JeremyProffittOrg/wopr/output/pdf/wopr-first-draft.pdf

DESIGN REVIEW

# W.O.P.R. / divided storage and inset base

Seven RGB panels per side. Two main-cup layouts. Recessed screw heads. Gray and flush white text.

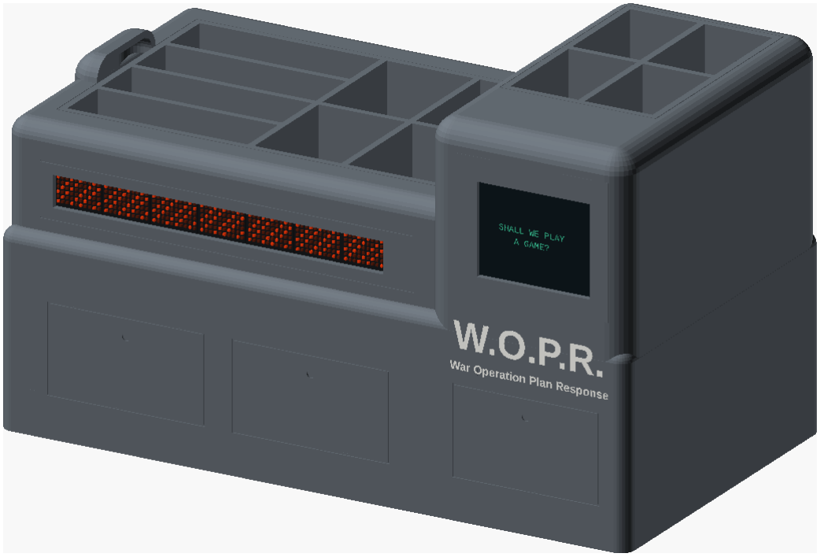
[picture p187: figure]

W.O.P.R. / DRAFT 07 / 2026-09-27 / dimensions in mm / not to print scale | 01 / 08
279.4 x 155 x 165 mm | 11.00 x 6.10 x 6.50 in | 3 mm nominal shell
OpenSCAD model render. Colored LEDs and display are hardware previews, not printed material.

MOCKUPS

# Seven-panel banks, the same case

Fourteen boards total: seven adjacent boards behind one continuous window on each side.

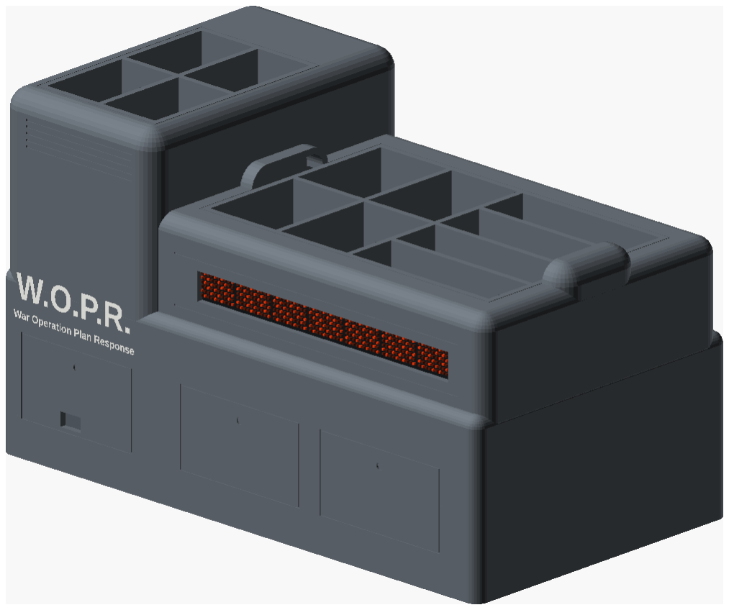
[picture p188: figure]
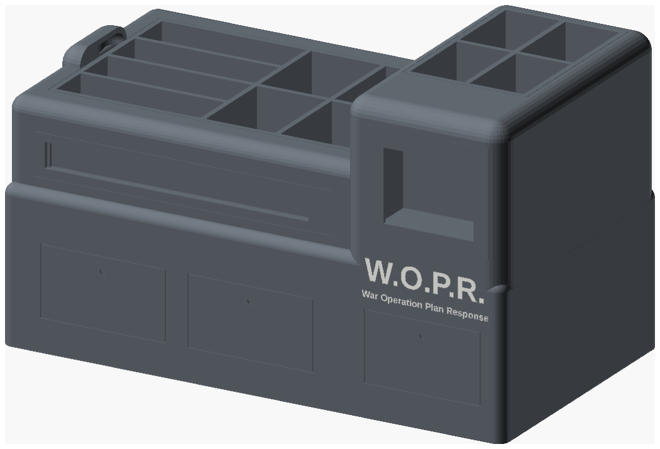
[picture p189: figure]

W.O.P.R. / DRAFT 07 / 2026-09-27 / dimensions in mm / not to print scale | 02 / 08

CASE WITHOUT ELECTRONICS

The tower cup has crossed dividers, making four deep compartments.

Both long sides carry white W.O.P.R. / War Operation Plan Response lettering.

The main touchscreen is on one side, directly above its logo.

Main cup: four shallow compartments in one half, four deep compartments in the other.

The inset base has 3 mm of screw-head space above the lower body edge.

Remove the pen cups and base for rear access. Fit the electronics first, then lower the cups into place.

# Overall envelope and panel placement

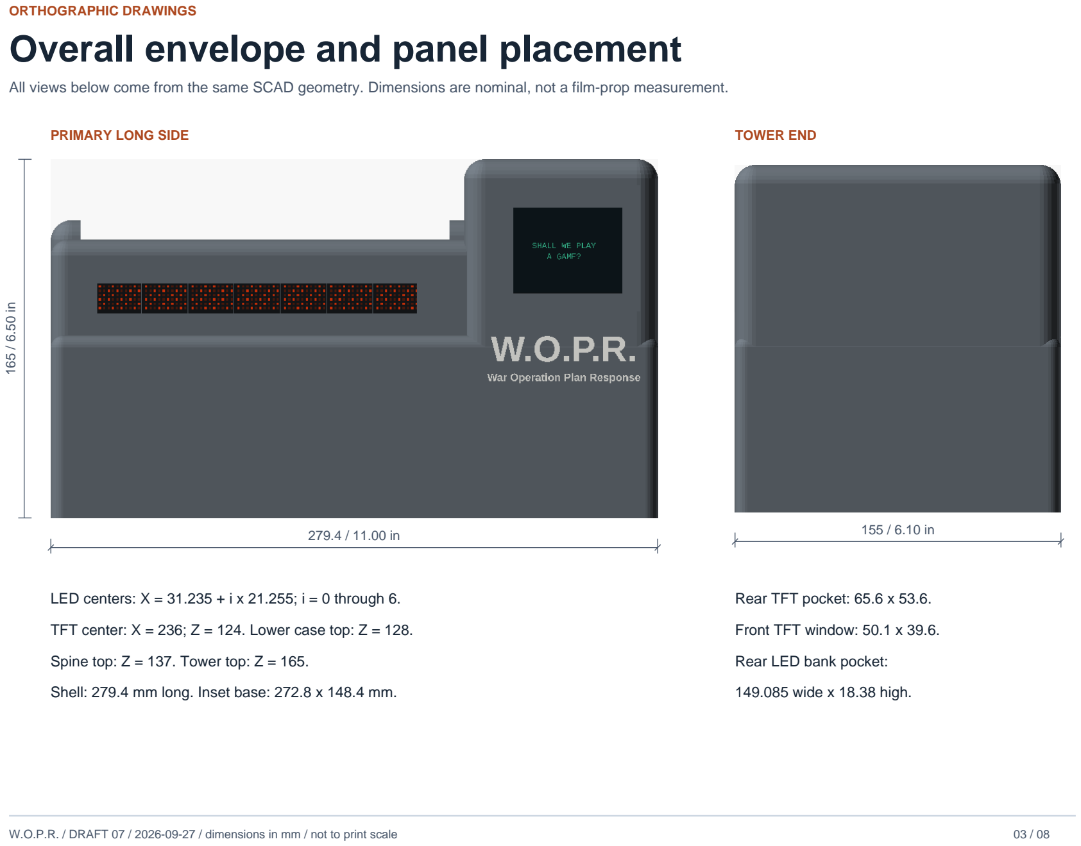
[picture p190: page 3]

ORTHOGRAPHIC DRAWINGS

All views below come from the same SCAD geometry. Dimensions are nominal, not a film-prop measurement.

W.O.P.R. / DRAFT 07 / 2026-09-27 / dimensions in mm / not to print scale | 03 / 08

PRIMARY LONG SIDE

279.4 / 11.00 in

165 / 6.50 in

TOWER END

155 / 6.10 in

LED centers: X = 31.235 + i x 21.255; i = 0 through 6.

TFT center: X = 236; Z = 124. Lower case top: Z = 128.

Spine top: Z = 137. Tower top: Z = 165.

Shell: 279.4 mm long. Inset base: 272.8 x 148.4 mm.

Rear TFT pocket: 65.6 x 53.6.

Front TFT window: 50.1 x 39.6.

Rear LED bank pocket:

149.085 wide x 18.38 high.

# Top, rear and service access

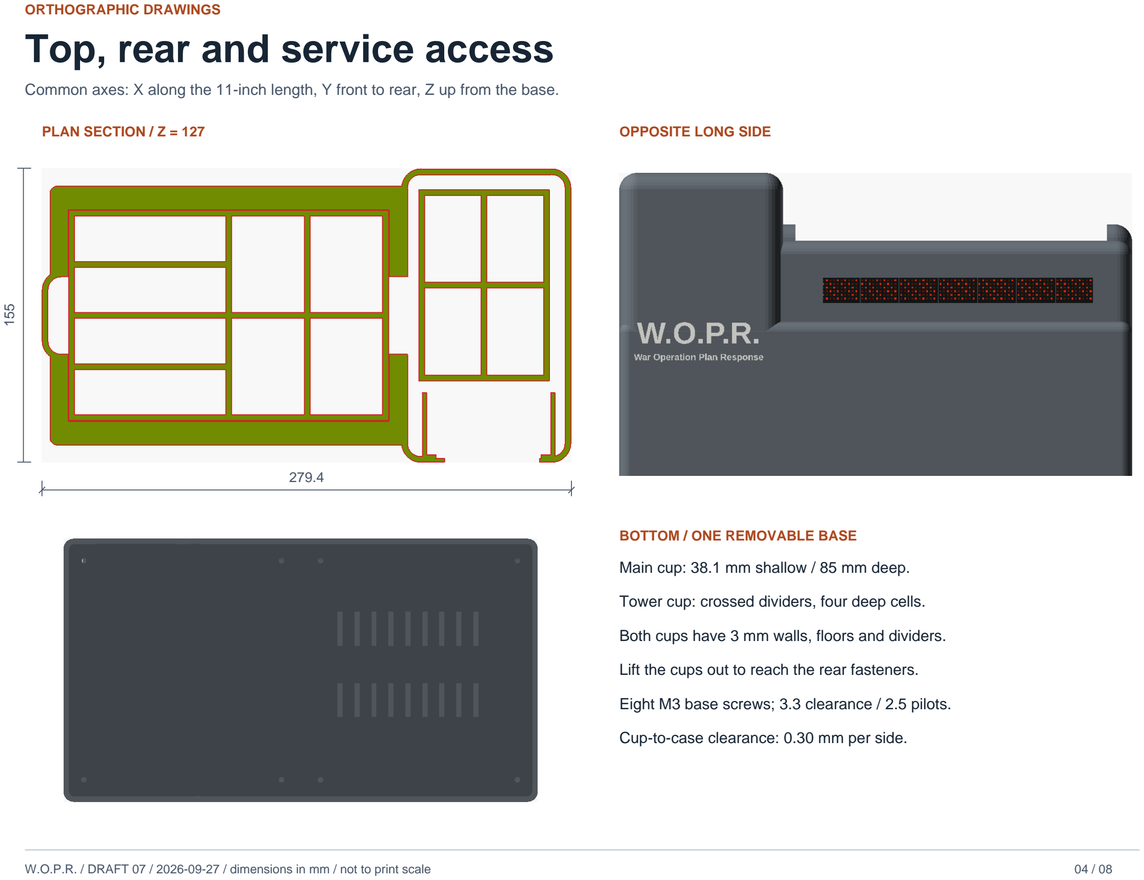
[picture p191: page 4]

ORTHOGRAPHIC DRAWINGS

Common axes: X along the 11-inch length, Y front to rear, Z up from the base.

W.O.P.R. / DRAFT 07 / 2026-09-27 / dimensions in mm / not to print scale | 04 / 08

PLAN SECTION / Z = 127

279.4

155

OPPOSITE LONG SIDE

BOTTOM / ONE REMOVABLE BASE

Main cup: 38.1 mm shallow / 85 mm deep.

Tower cup: crossed dividers, four deep cells.

Both cups have 3 mm walls, floors and dividers.

Lift the cups out to reach the rear fasteners.

Eight M3 base screws; 3.3 clearance / 2.5 pilots.

Cup-to-case clearance: 0.30 mm per side.

# Both main-cup versions are included

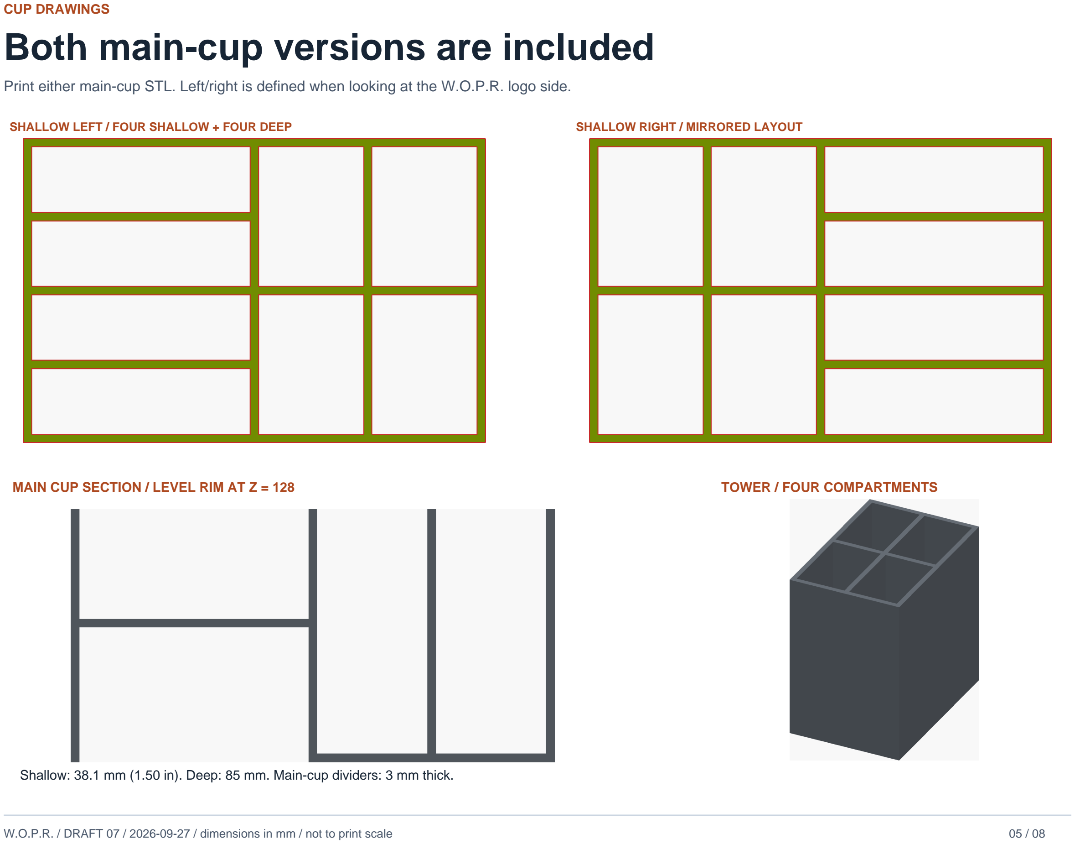
[picture p192: page 5]

CUP DRAWINGS

Print either main-cup STL. Left/right is defined when looking at the W.O.P.R. logo side.

W.O.P.R. / DRAFT 07 / 2026-09-27 / dimensions in mm / not to print scale | 05 / 08
SHALLOW LEFT / FOUR SHALLOW + FOUR DEEP | SHALLOW RIGHT / MIRRORED LAYOUT
MAIN CUP SECTION / LEVEL RIM AT Z = 128 | TOWER / FOUR COMPARTMENTS

Shallow: 38.1 mm (1.50 in). Deep: 85 mm. Main-cup dividers: 3 mm thick.

BASE DRAWING

# The base sits inside the body

Exactly 3 mm from the underside of the plate to the bottom edge of the body.

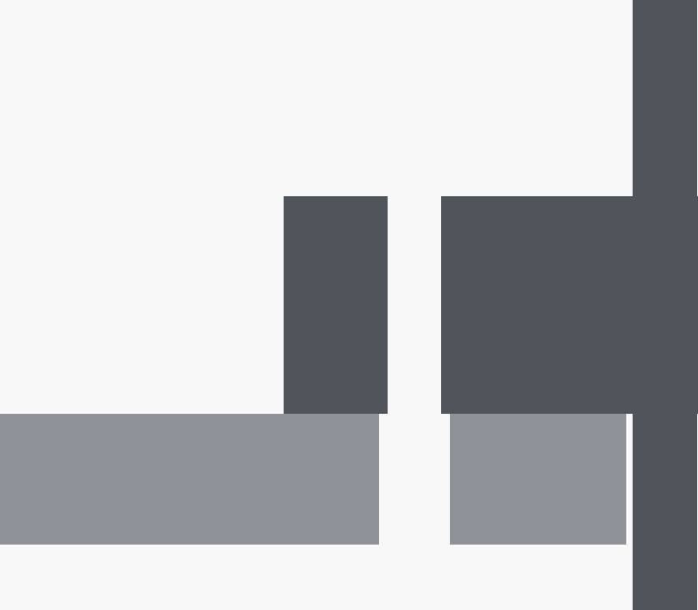
[picture p193: figure]

W.O.P.R. / DRAFT 07 / 2026-09-27 / dimensions in mm / not to print scale | 06 / 08

SECTION THROUGH A FRONT BASE SCREW

SCREW-HEAD SPACE

### 6 mm BASE PLATE

SCREW BOSS

3.0 mm

6.0 mm

BODY BOTTOM / Z = 0

Base footprint: 272.8 x 148.4 mm, inside the 279.4 x 155 mm body. 3.3 mm inset per side = 3 mm shell wall + 0.3 mm assembly clearance. Plate underside Z = 3. Plate top and screw-boss seats Z = 9.
Use M3 heads no taller than 3 mm; the old counterbores have been removed.

MOUNT DRAWING

# A full inch behind the display

Section through X = 236. The bay is open at the rear for wires and installation from below.

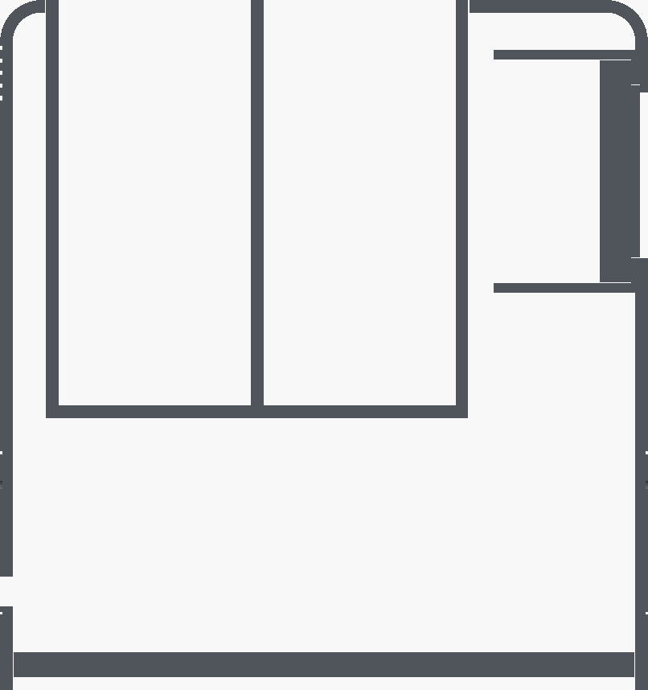
[picture p194: figure]

W.O.P.R. / DRAFT 07 / 2026-09-27 / dimensions in mm / not to print scale | 07 / 08

SCAD SECTION / LOOKING ALONG X

DEPTH CHAIN / DETAIL

2.0

9.5 hardware

25.4 / 1.00 in clear

OUTSIDE | CLEAR REAR BAY

36.9 from exterior face to bay rear

Rear-loading pocket: 65.6 x 53.6; front bezel hides PCB.

Front opening: 50.1 x 39.6; left +4.5, right -1, top -2.

Four hidden blind pilots: diameter 1.8 for M2 screws.

V2 hole pitch: 59.690 x 47.498 (landscape).

Front glass is nominally 2 mm below the case face.

Tower cup starts at Y = 43, beyond the 36.9 mm bay.

The 25.4 mm bay excludes the 9.5 mm hardware depth. Mount positions follow manufacturer CAD; assembly thickness and tolerances still need a physical check.

PRINT KIT AND EVIDENCE

# Install from the inside

Rear access shown with the base and removable pen cups removed. Physical fit remains untested.

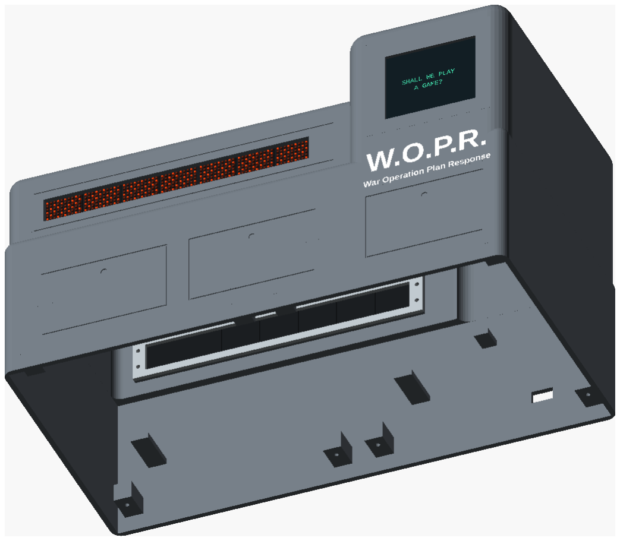
[picture p195: figure]

W.O.P.R. / DRAFT 07 / 2026-09-27 / dimensions in mm / not to print scale | 08 / 08

UNDERSIDE / REAR MOUNTING ACCESS

PRINT FILES
OPEN wopr-parts.3mf alone in Bambu Studio. gray-shell.stl: one continuous structural case. white-text.stl: aligned lettering; import with gray-shell. base.stl: one continuous removable underside. cup-main-shallow-left / shallow-right: choose ONE. cup-tower.stl: four compartments with crossed dividers. led-retainer.stl: print two; screws enter from inside.
3 mm walls/dividers. White text: 0.8 mm deep, flush. No splice strips. Test fit-coupon.stl before the case. Shell and base need a 280 x 155 mm area, plus brim. Assign the two filament colors explicitly in the slicer.

CHECKED: Eight STL exports are watertight; each structural part is a single solid.
CHECKED: 3 mm base recess, 38.1 mm shallow cells, dividers and mounting clearances.
NOT CHECKED: Actual print, hardware fit, touch access, electrical power or operating temperature. Proportions are adapted from visual references. This is a review draft, not a measured replica.

SOURCES / MANUFACTURER DATA AND VISUAL REFERENCE

Seeed product + board CAD | https://wiki.seeedstudio.com/rgb_matrix_for_xiao/
Adafruit #3315 / 65 x 53 x 9.5 mm | https://www.adafruit.com/product/3315
Adafruit V2 mounting geometry | https://github.com/adafruit/Adafruit-2.4-TFT-FeatherWing-PCB
Miniatua / visual proportions only | https://www.miniatua.com/work/wopr/
