JeremyProffittOrg/wopr/output/concealed/views/four-wheel-concealed-shell-0.png

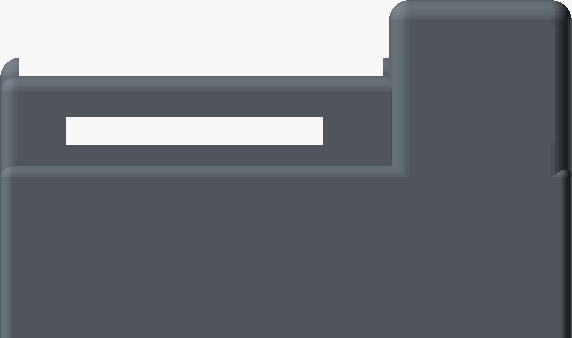
output/concealed/views/four-wheel-concealed-shell-0.png
