JeremyProffittOrg/wopr/output/concealed/views/four-wheel-concealed-shell-2.png

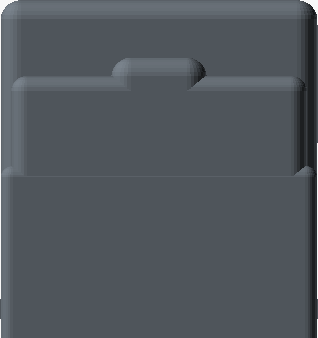
output/concealed/views/four-wheel-concealed-shell-2.png
