JeremyProffittOrg/wopr/output/concealed/views/four-wheel-concealed-shell-3.png

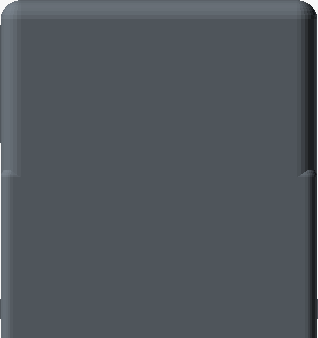
output/concealed/views/four-wheel-concealed-shell-3.png
