JeremyProffittOrg/wopr/output/concealed/views/four-wheel-concealed-shell-4.png

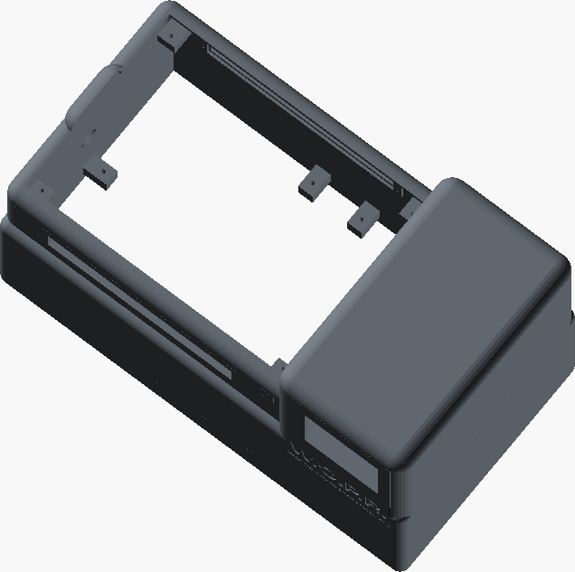
output/concealed/views/four-wheel-concealed-shell-4.png
