JeremyProffittOrg/wopr/output/concealed/views/four-wheel-concealed-shell-5.png

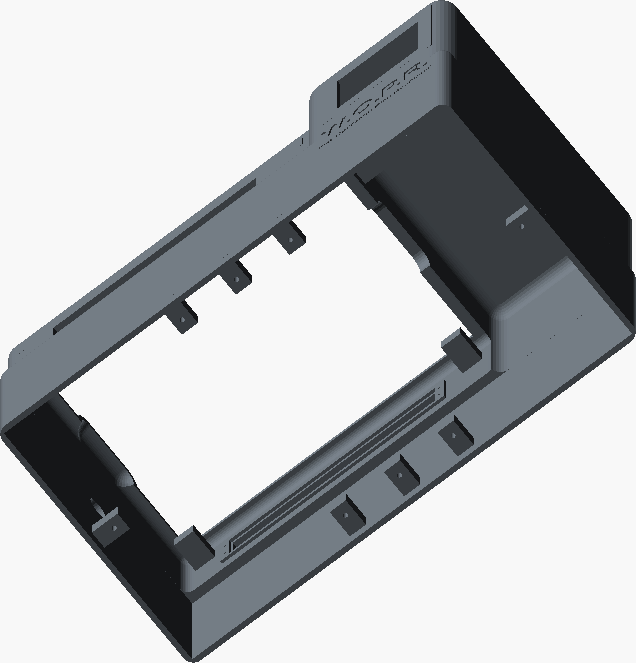
output/concealed/views/four-wheel-concealed-shell-5.png
