JeremyProffittOrg/wopr/output/concealed/views/four-wheel-concealed-shell-6.png

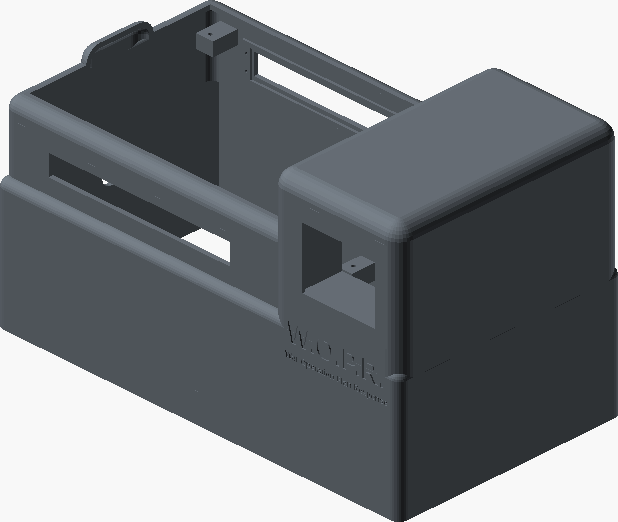
output/concealed/views/four-wheel-concealed-shell-6.png
