JeremyProffittOrg/wopr/output/concealed/views/four-wheel-concealed-shell-7.png

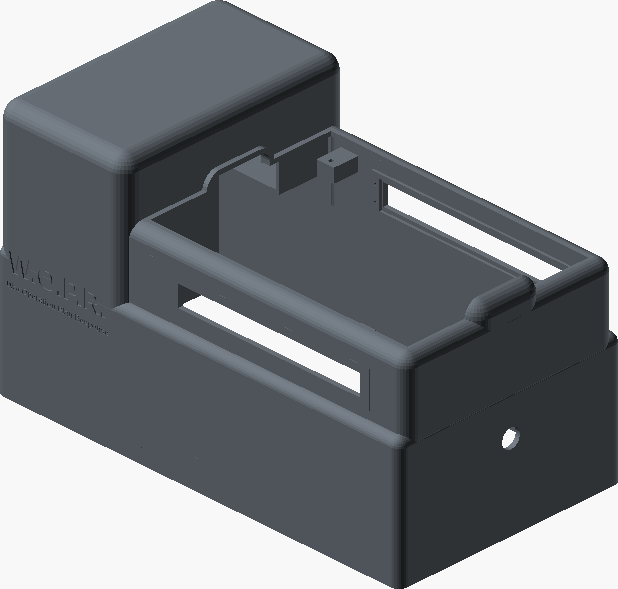
output/concealed/views/four-wheel-concealed-shell-7.png
