JeremyProffittOrg/wopr/output/concealed/views/four-wheel-exploded-6.png

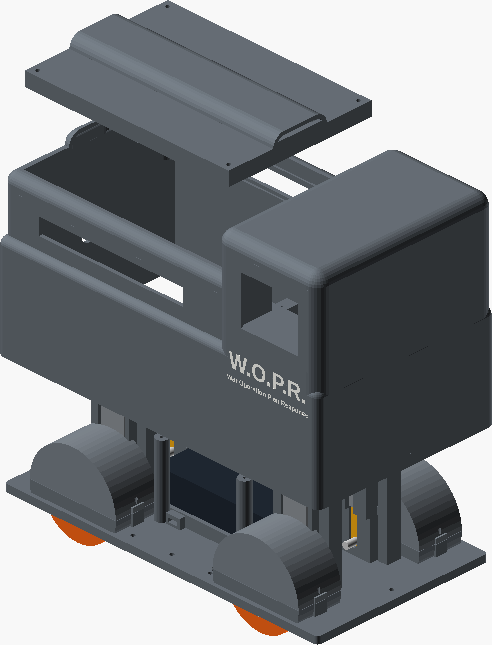
output/concealed/views/four-wheel-exploded-6.png
