JeremyProffittOrg/wopr/output/concealed/views/four-wheel-fit-coupon-5.png

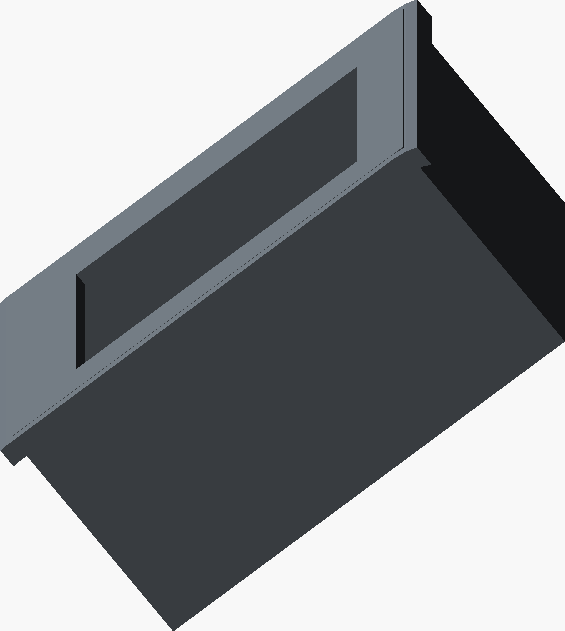
output/concealed/views/four-wheel-fit-coupon-5.png
