JeremyProffittOrg/wopr/output/concealed/views/four-wheel-interior-6.png

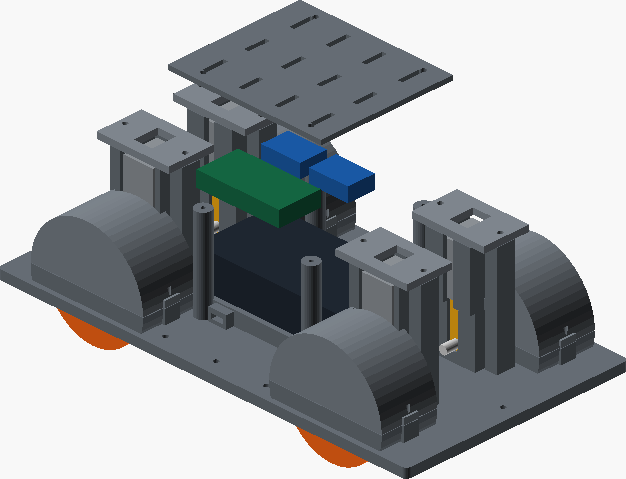
output/concealed/views/four-wheel-interior-6.png
