JeremyProffittOrg/wopr/output/concealed/views/four-wheel-robot-lid-6.png

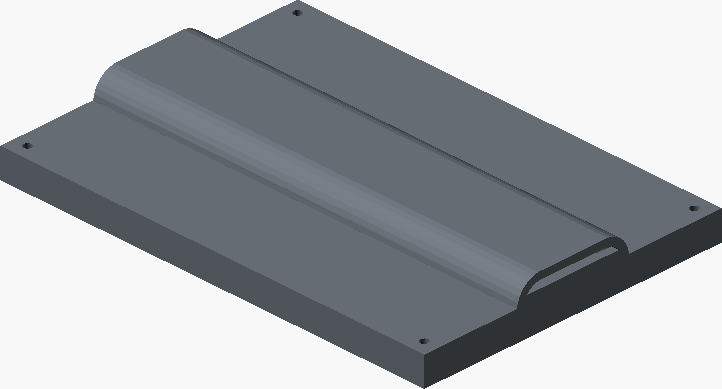
output/concealed/views/four-wheel-robot-lid-6.png
