JeremyProffittOrg/wopr/output/concealed/views/four-wheel-wheel-hood-front-4.png

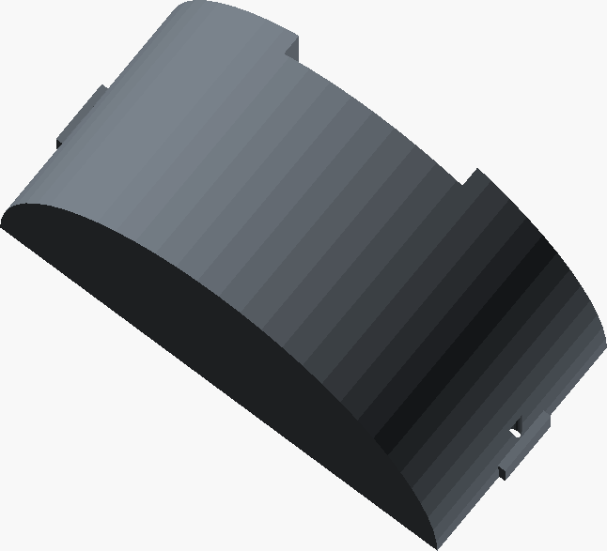
output/concealed/views/four-wheel-wheel-hood-front-4.png
