JeremyProffittOrg/wopr/output/concealed/views/four-wheel-wheel-hood-front-5.png

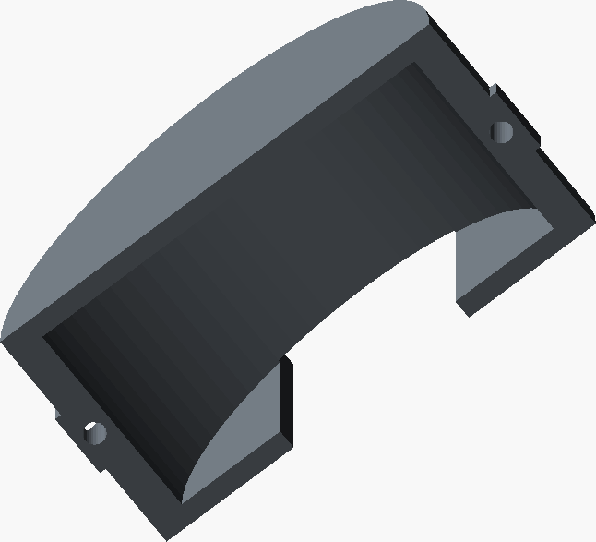
output/concealed/views/four-wheel-wheel-hood-front-5.png
