JeremyProffittOrg/wopr/output/concealed/views/four-wheel-wheel-hood-rear-0.png

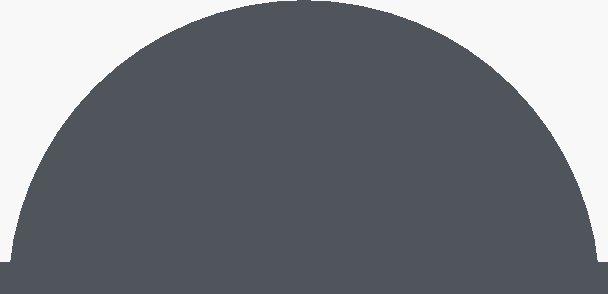
output/concealed/views/four-wheel-wheel-hood-rear-0.png
