JeremyProffittOrg/wopr/output/concealed/views/four-wheel-wheel-hood-rear-4.png

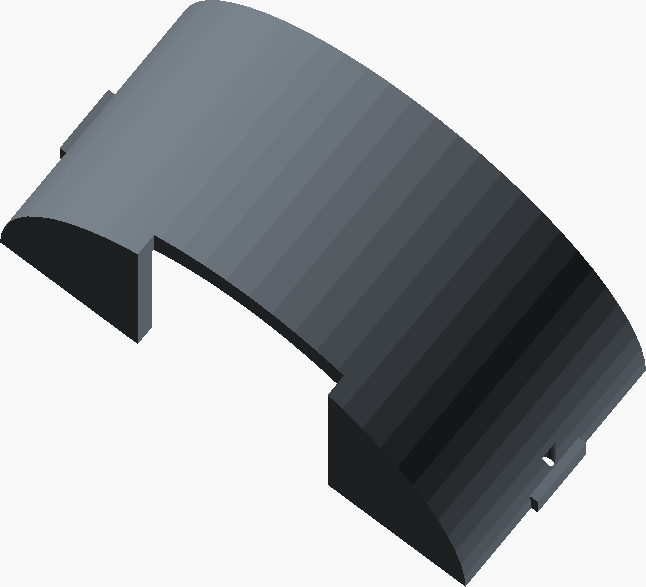
output/concealed/views/four-wheel-wheel-hood-rear-4.png
