JeremyProffittOrg/wopr/output/concealed/views/four-wheel-white-text-1.png

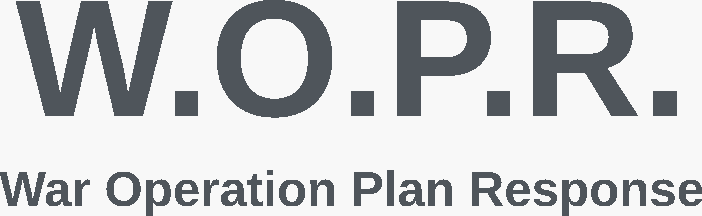
output/concealed/views/four-wheel-white-text-1.png
