JeremyProffittOrg/wopr/output/concealed/views/wide-eight-wheel-concealed-shell-6.png

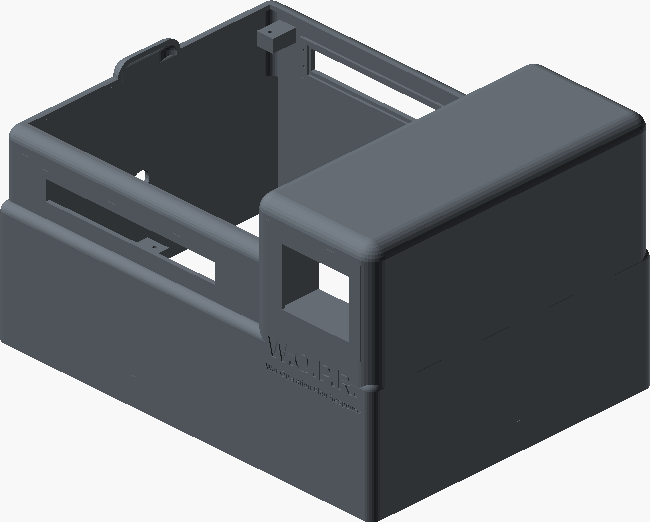
output/concealed/views/wide-eight-wheel-concealed-shell-6.png
