JeremyProffittOrg/wopr/output/concealed/views/wide-eight-wheel-concealed-shell-7.png

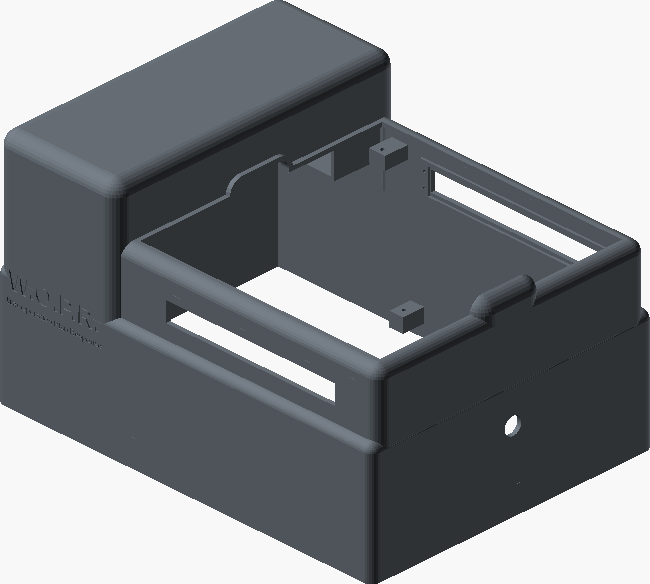
output/concealed/views/wide-eight-wheel-concealed-shell-7.png
