JeremyProffittOrg/wopr/output/concealed/views/wide-eight-wheel-exploded-6.png

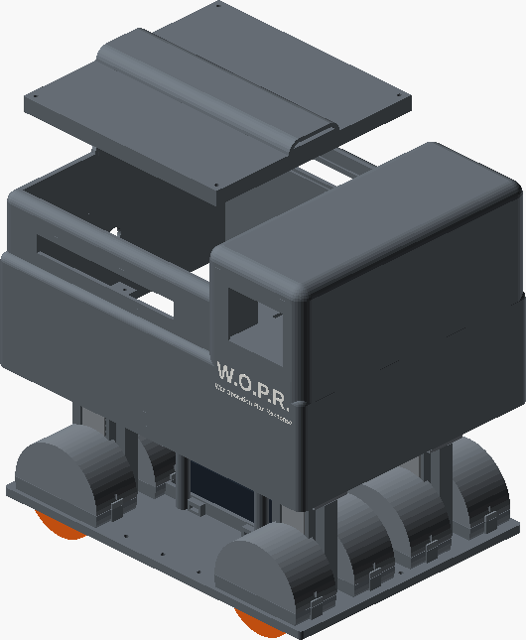
output/concealed/views/wide-eight-wheel-exploded-6.png
