JeremyProffittOrg/wopr/output/concealed/views/wide-eight-wheel-interior-6.png

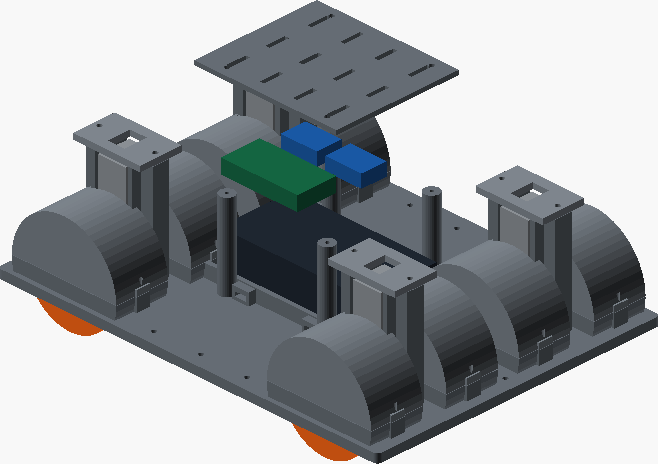
output/concealed/views/wide-eight-wheel-interior-6.png
