JeremyProffittOrg/wopr/output/reinforced/views/exposed-r-shell-3.png

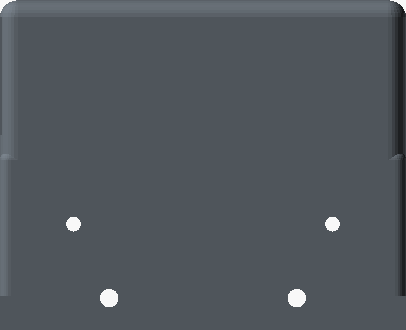
output/reinforced/views/exposed-r-shell-3.png
