JeremyProffittOrg/wopr/output/reinforced/views/exposed-r-shell-4.png

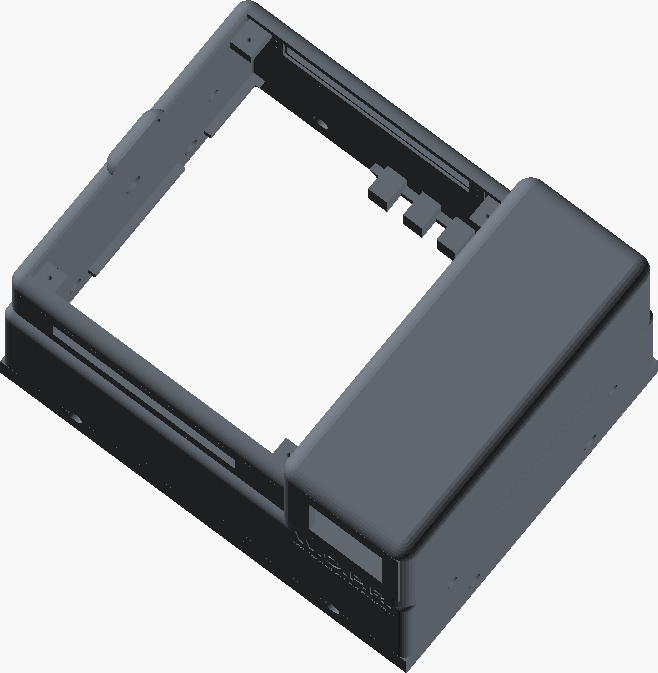
output/reinforced/views/exposed-r-shell-4.png
