JeremyProffittOrg/wopr/output/reinforced/views/exposed-r-shell-5.png

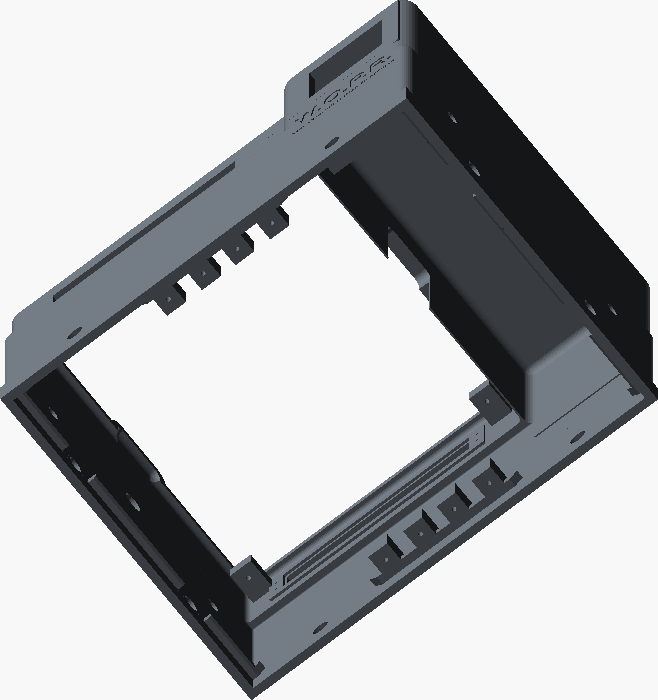
output/reinforced/views/exposed-r-shell-5.png
