JeremyProffittOrg/wopr/output/reinforced/views/exposed-r-shell-6.png

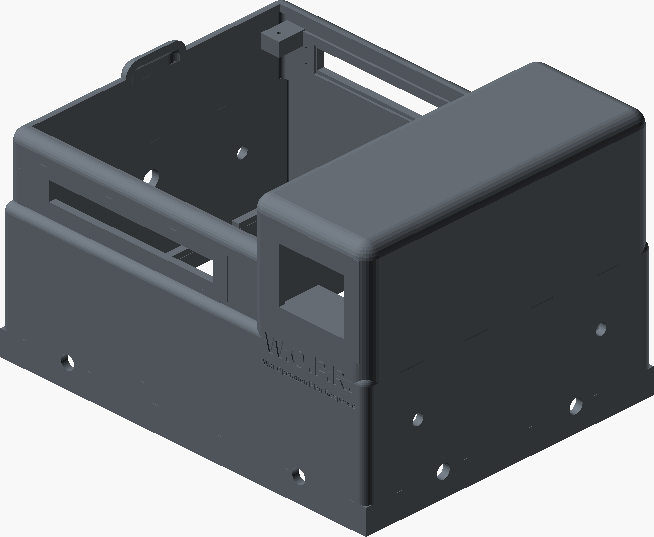
output/reinforced/views/exposed-r-shell-6.png
