JeremyProffittOrg/wopr/output/reinforced/views/exposed-r-shell-7.png

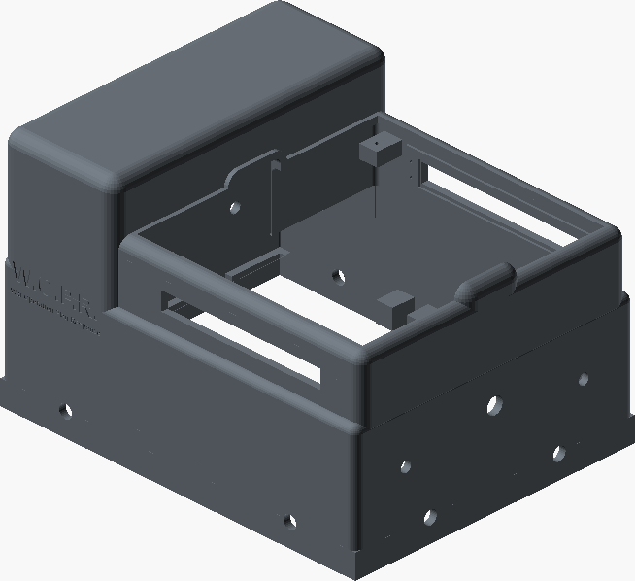
output/reinforced/views/exposed-r-shell-7.png
