JeremyProffittOrg/wopr/output/reinforced/views/four-r-cap-7.png

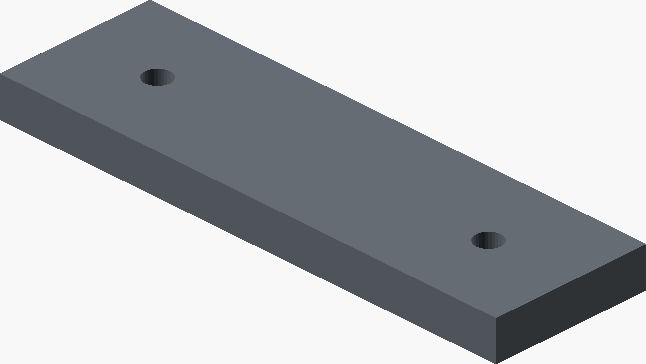
output/reinforced/views/four-r-cap-7.png
