JeremyProffittOrg/wopr/output/reinforced/views/four-r-shell-1.png

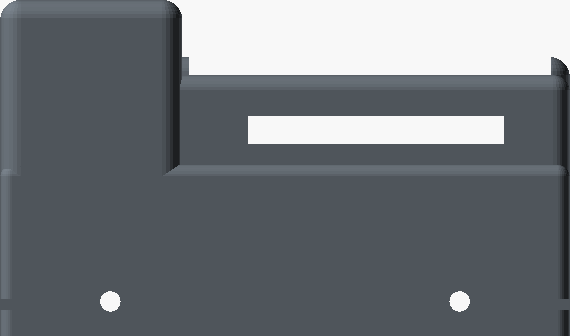
output/reinforced/views/four-r-shell-1.png
