JeremyProffittOrg/wopr/output/reinforced/views/four-r-shell-3.png

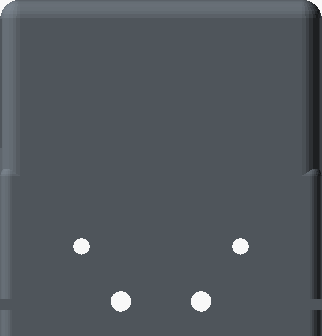
output/reinforced/views/four-r-shell-3.png
