JeremyProffittOrg/wopr/output/reinforced/views/four-r-shell-5.png

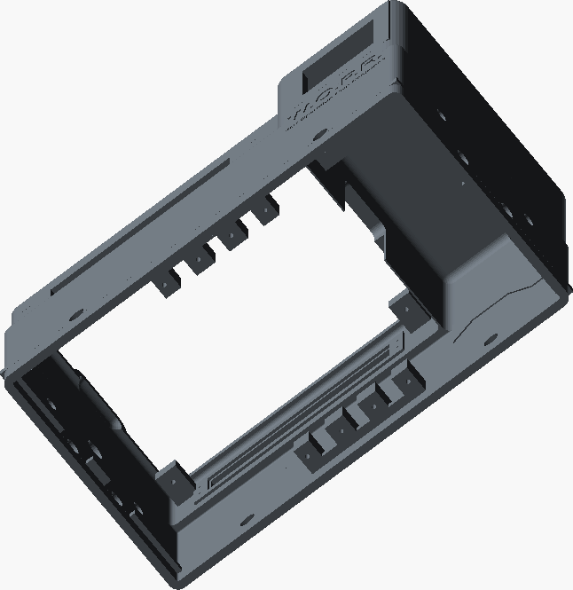
output/reinforced/views/four-r-shell-5.png
