JeremyProffittOrg/wopr/output/reinforced/views/four-r-tray-7.png

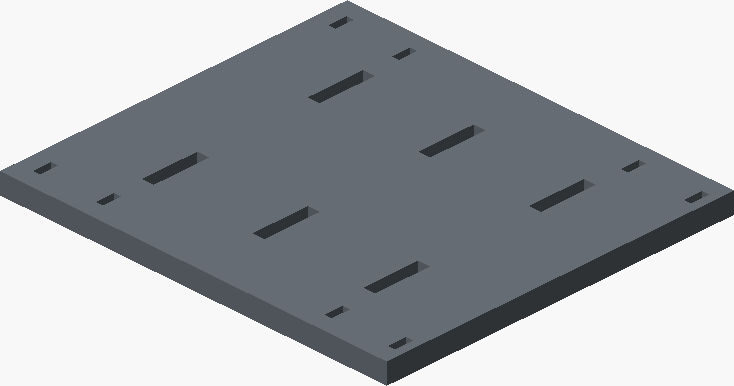
output/reinforced/views/four-r-tray-7.png
