JeremyProffittOrg/wopr/output/reinforced/views/four-zip-route-1.png

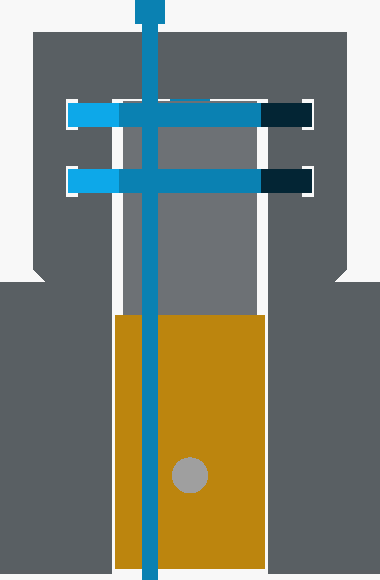
output/reinforced/views/four-zip-route-1.png
