JeremyProffittOrg/wopr/output/reinforced/views/four-zip-route-3.png

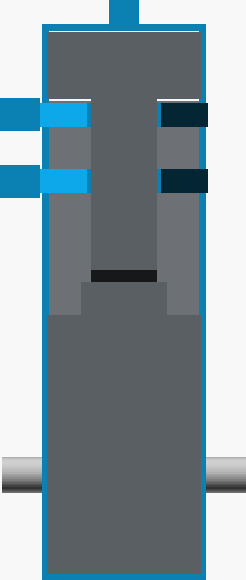
output/reinforced/views/four-zip-route-3.png
