JeremyProffittOrg/wopr/output/reinforced/views/four-zip-route-4.png

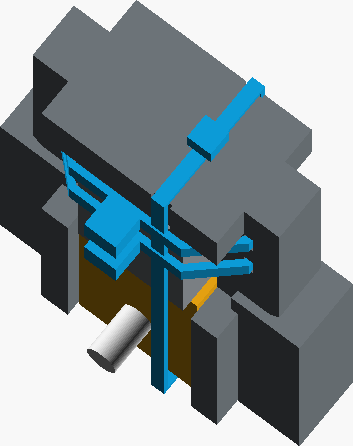
output/reinforced/views/four-zip-route-4.png
