JeremyProffittOrg/wopr/output/reinforced/views/four-zip-route-7.png

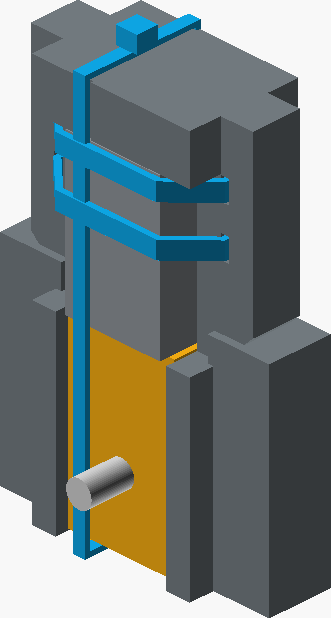
output/reinforced/views/four-zip-route-7.png
