JeremyProffittOrg/wopr/output/reinforced/views/seven-r-cup-left-4.png

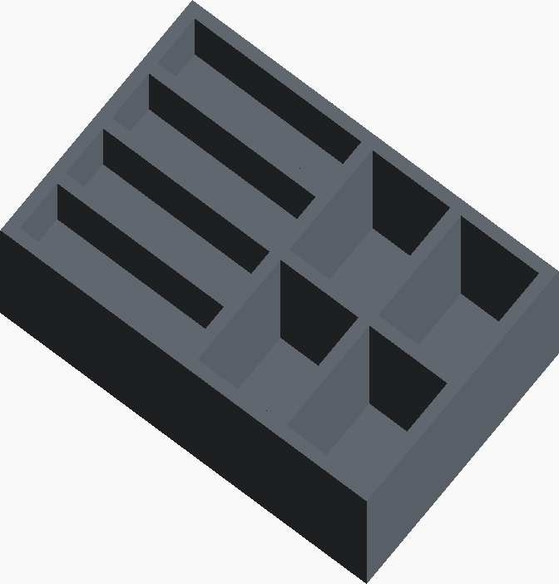
output/reinforced/views/seven-r-cup-left-4.png
