JeremyProffittOrg/wopr/output/reinforced/views/seven-r-cup-left-6.png

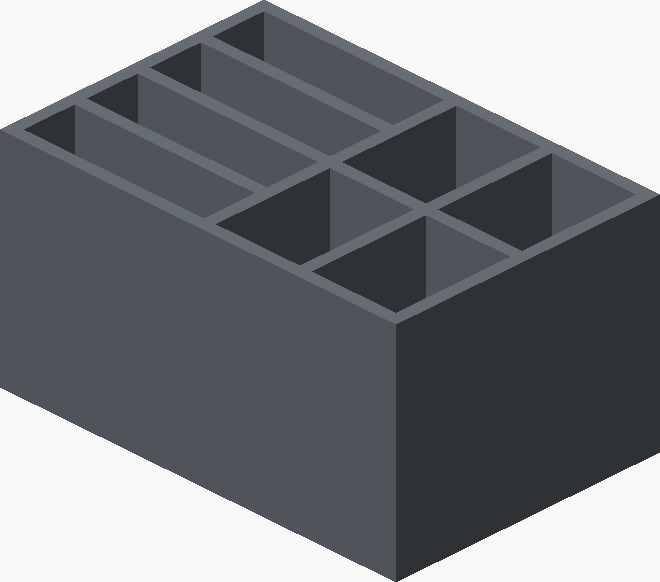
output/reinforced/views/seven-r-cup-left-6.png
