JeremyProffittOrg/wopr/output/reinforced/views/seven-r-cup-left-7.png

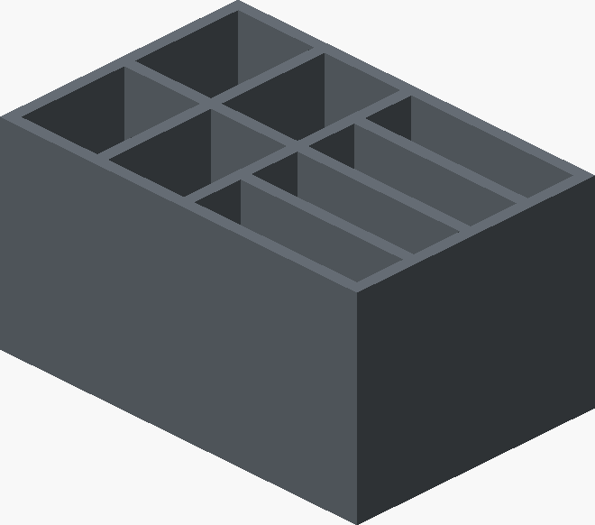
output/reinforced/views/seven-r-cup-left-7.png
