JeremyProffittOrg/wopr/output/reinforced/views/seven-r-cup-tower-4.png

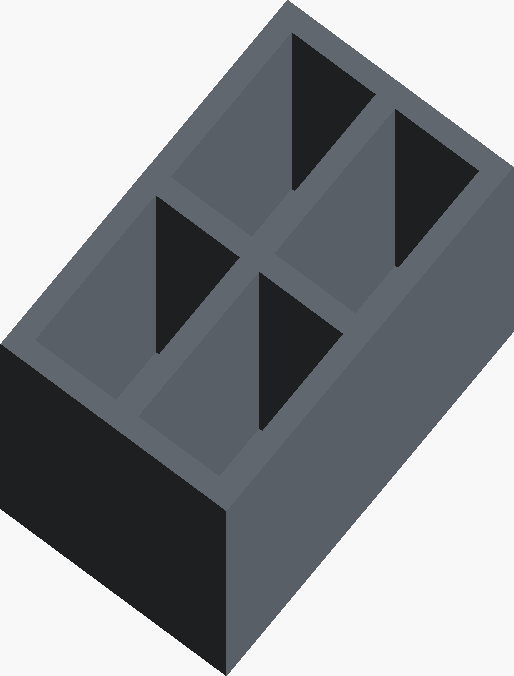
output/reinforced/views/seven-r-cup-tower-4.png
