JeremyProffittOrg/wopr/output/reinforced/views/six-r-shell-1.png

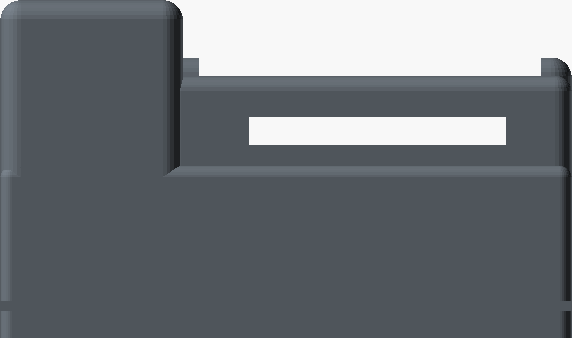
output/reinforced/views/six-r-shell-1.png
