JeremyProffittOrg/wopr/output/reinforced/views/wide-r-frame-zip-4.png

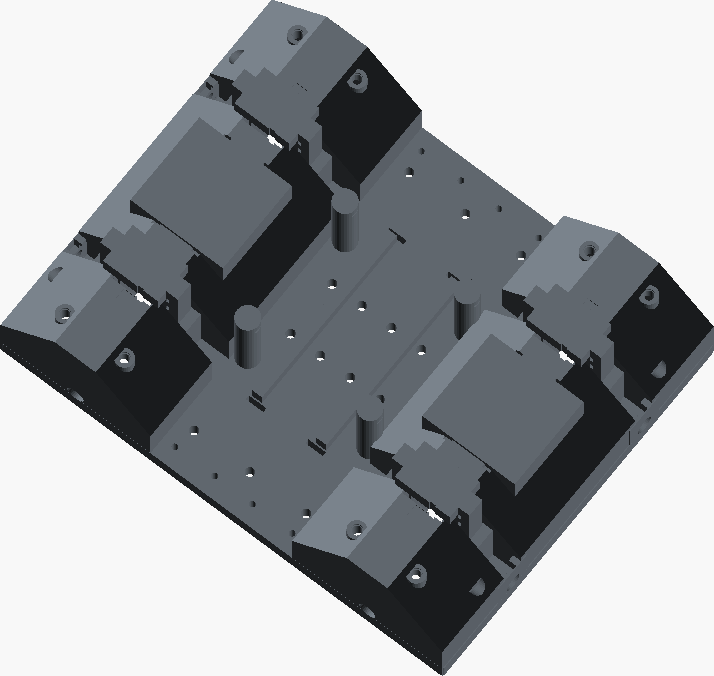
output/reinforced/views/wide-r-frame-zip-4.png
