JeremyProffittOrg/wopr/output/reinforced/views/wide-r-shell-7.png

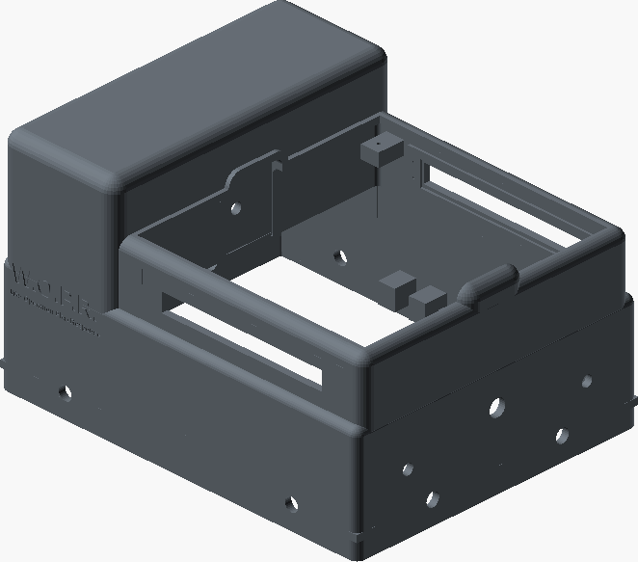
output/reinforced/views/wide-r-shell-7.png
