JeremyProffittOrg/wopr/output/variants/views/replica-base-6.png

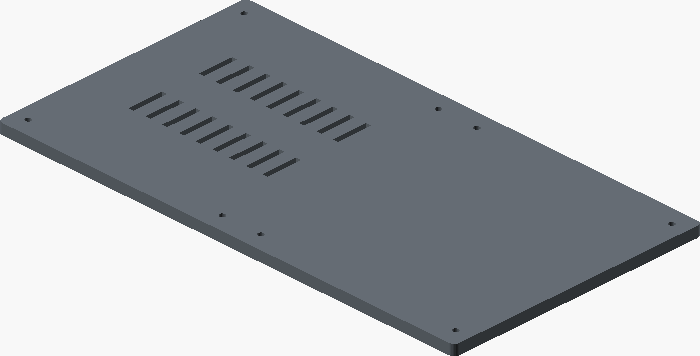
output/variants/views/replica-base-6.png
