JeremyProffittOrg/wopr/output/variants/views/replica-cup-main-shallow-left-5.png

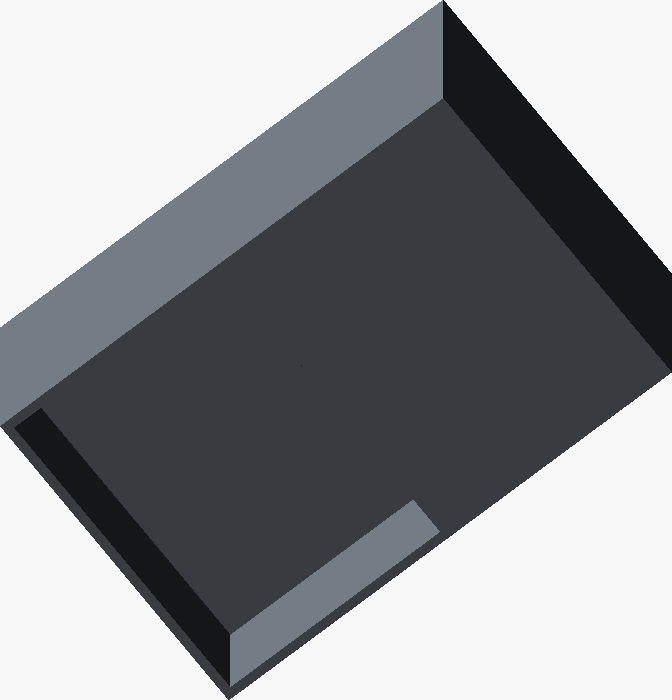
output/variants/views/replica-cup-main-shallow-left-5.png
