JeremyProffittOrg/wopr/output/variants/views/replica-cup-tower-5.png

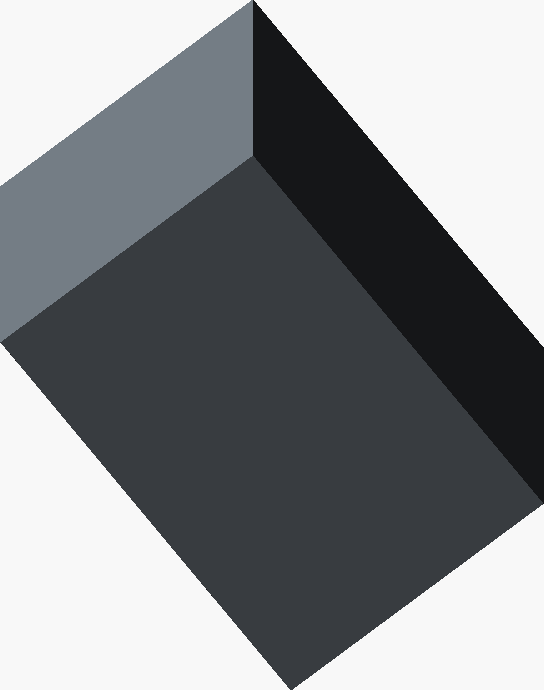
output/variants/views/replica-cup-tower-5.png
