JeremyProffittOrg/wopr/output/variants/views/replica-cup-tower-6.png

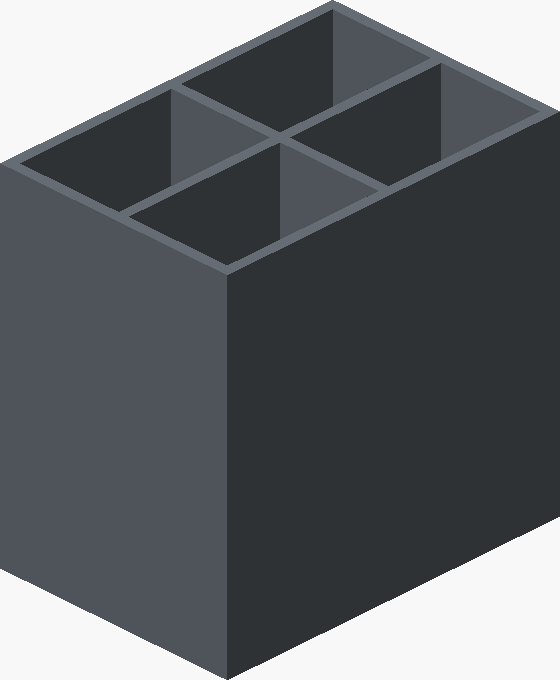
output/variants/views/replica-cup-tower-6.png
