JeremyProffittOrg/wopr/output/variants/views/replica-gray-shell-5.png

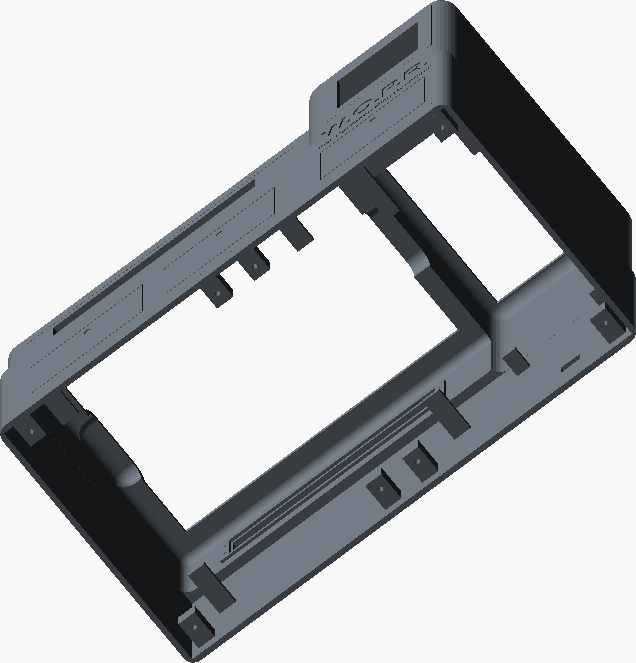
output/variants/views/replica-gray-shell-5.png
