JeremyProffittOrg/wopr/output/variants/views/replica-gray-shell-7.png

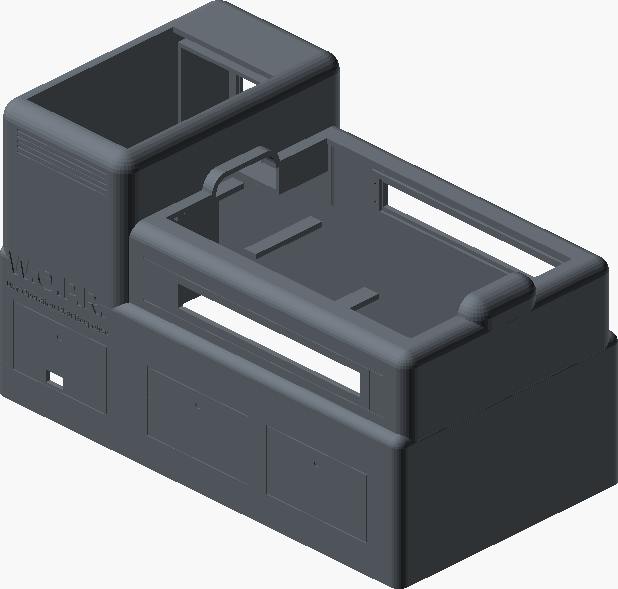
output/variants/views/replica-gray-shell-7.png
