JeremyProffittOrg/wopr/output/variants/views/robot-robot-floor-5.png

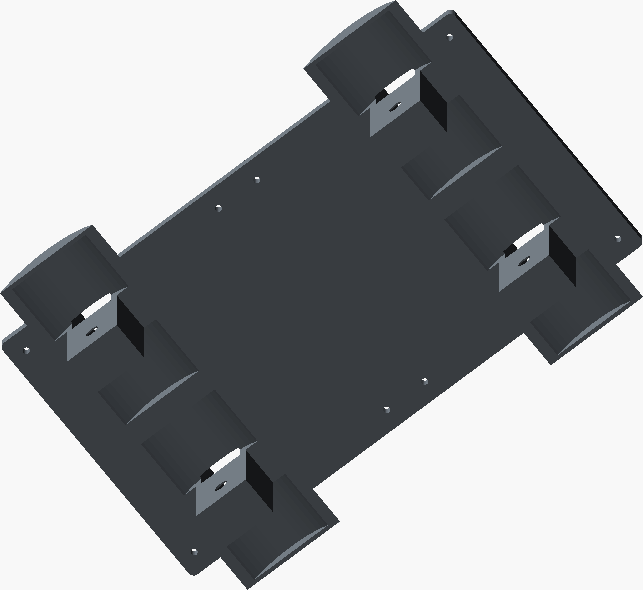
output/variants/views/robot-robot-floor-5.png
