JeremyProffittOrg/wopr/output/variants/views/robot-robot-floor-6.png

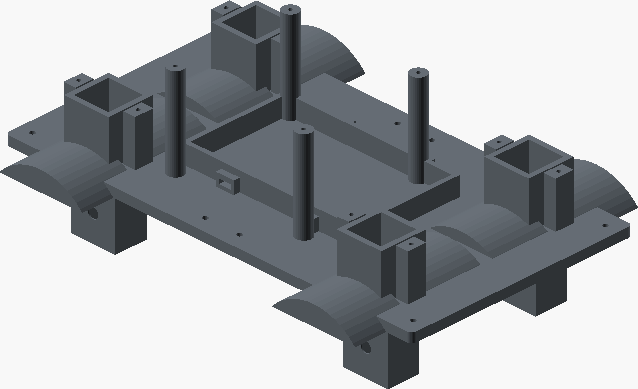
output/variants/views/robot-robot-floor-6.png
