JeremyProffittOrg/wopr/output/variants/views/robot-robot-tray-6.png

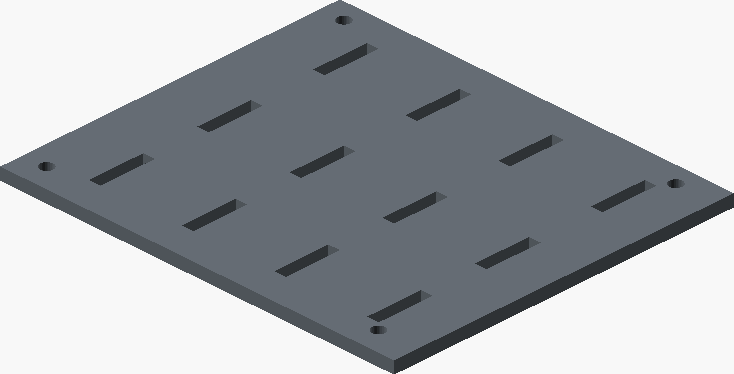
output/variants/views/robot-robot-tray-6.png
