JeremyProffittOrg/wopr/output/views/back.png

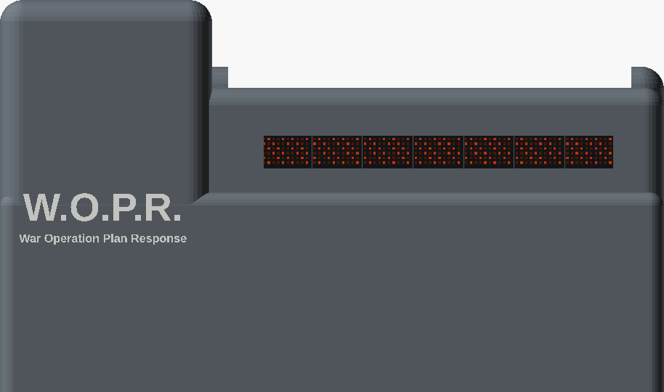
output/views/back.png
