JeremyProffittOrg/wopr/output/views/bottom.png

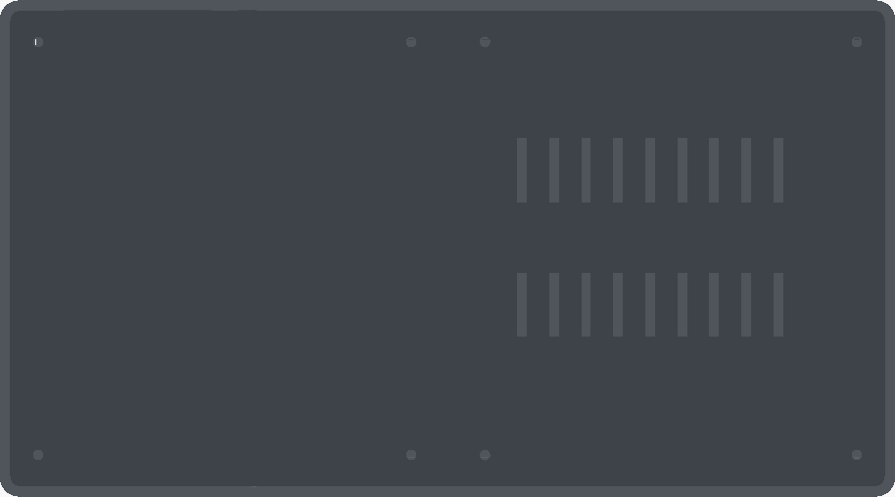
output/views/bottom.png
