JeremyProffittOrg/wopr/output/views/coupon.png

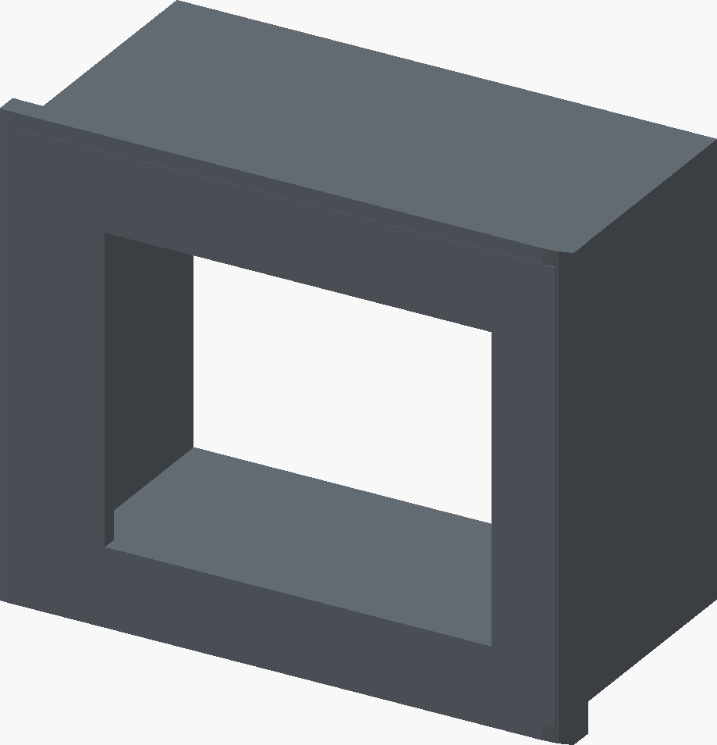
output/views/coupon.png
