JeremyProffittOrg/wopr/output/views/cup-left-top.png

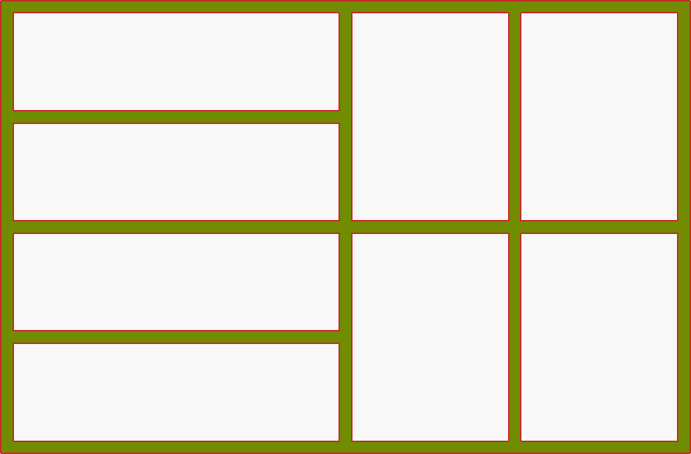
output/views/cup-left-top.png
