JeremyProffittOrg/wopr/output/views/cup-right-top.png

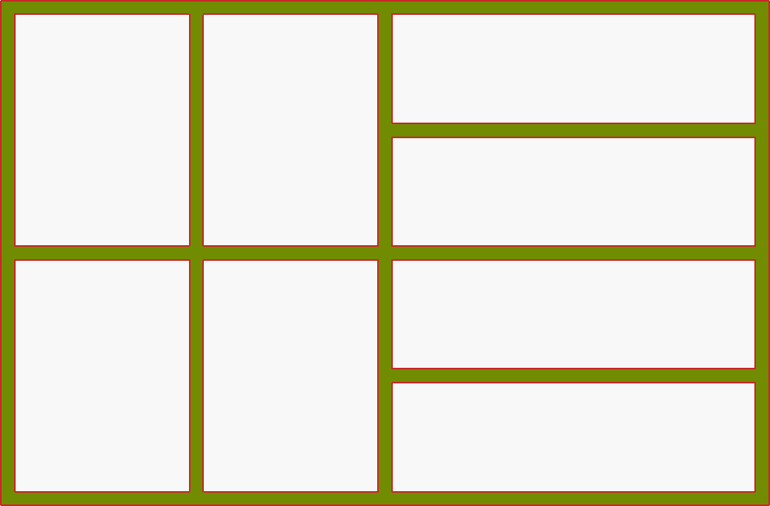
output/views/cup-right-top.png
