JeremyProffittOrg/wopr/output/views/lcd-rear-mounts.png

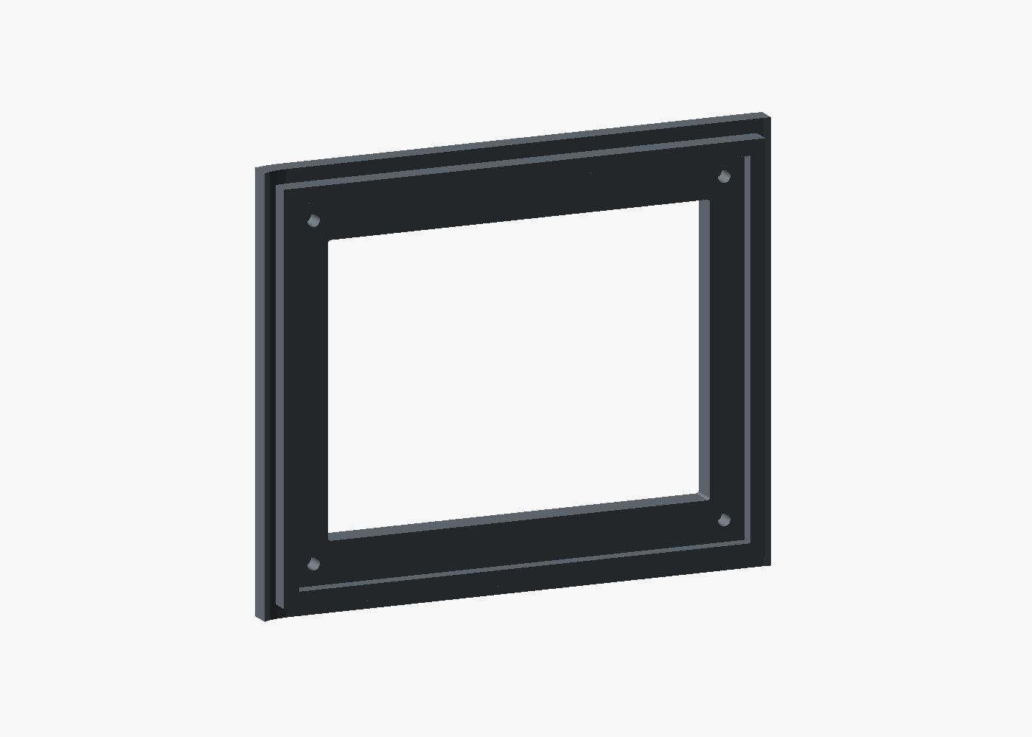
output/views/lcd-rear-mounts.png
