JeremyProffittOrg/wopr/output/views/rear.png

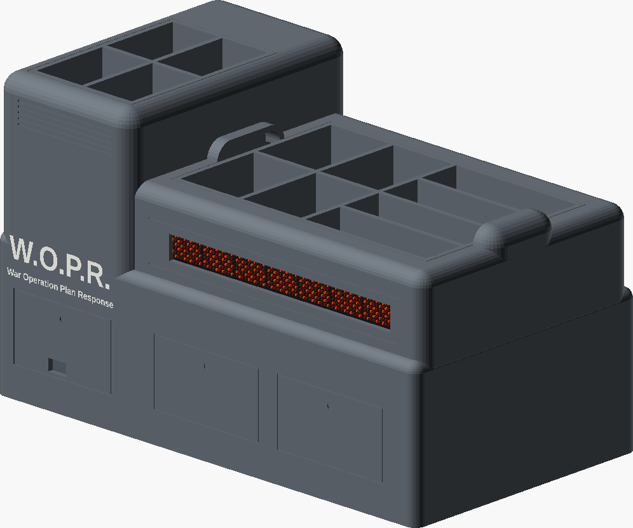
output/views/rear.png
