JeremyProffittOrg/wopr/output/variants/replica/cup-main-shallow-right.stl

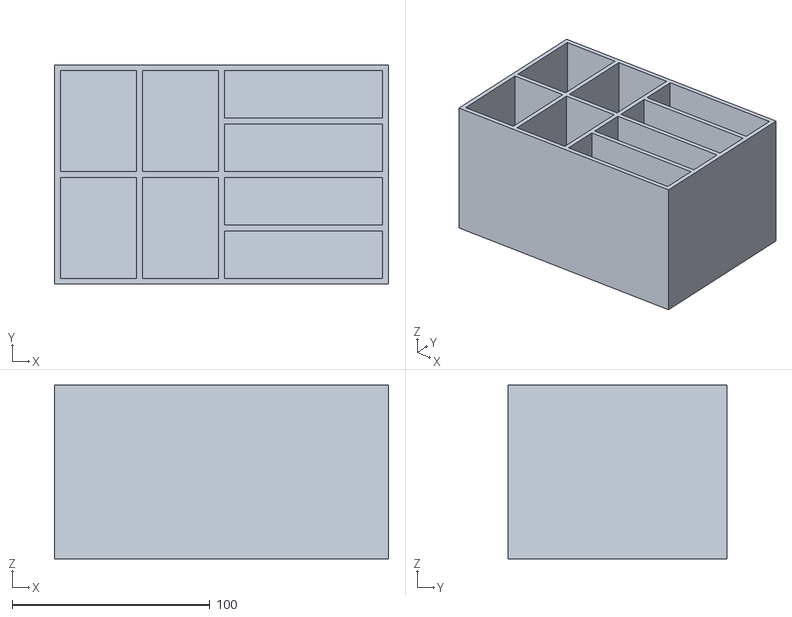
[picture p253: CAD file, 2026-09-26]
output/variants/replica/cup-main-shallow-right.stl
169.0 x 111.0 x 88.0
