JeremyProffittOrg/wopr/output/body-projects/wopr-body-multi-color.3mf

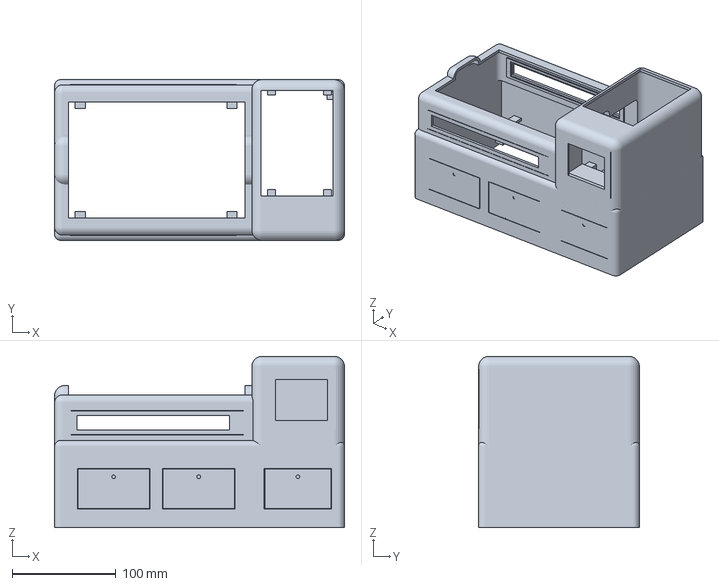
[picture p254: CAD file, 2026-09-27]
output/body-projects/wopr-body-multi-color.3mf
279.3 x 155.0 x 165.0 mm
