JeremyProffittOrg/wopr/output/concealed/four-wheel/wheel-hood-front.stl

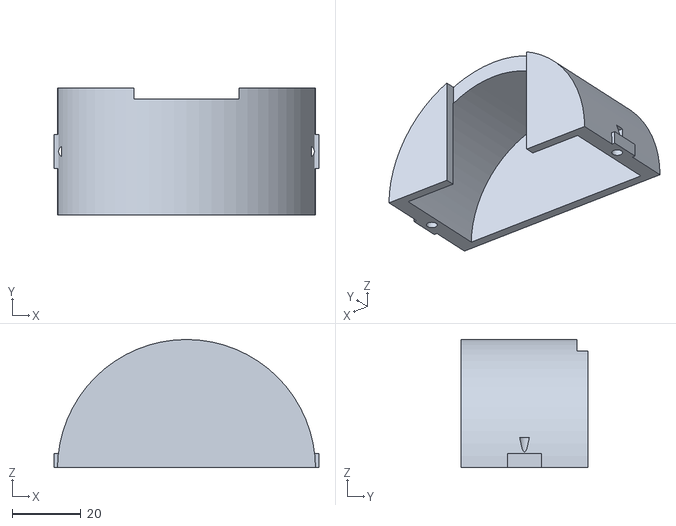
[picture p255: CAD file, 2026-09-28]
output/concealed/four-wheel/wheel-hood-front.stl
77.0 x 37.0 x 37.2
