JeremyProffittOrg/wopr/output/concealed/wide-eight-wheel/concealed-tray.stl

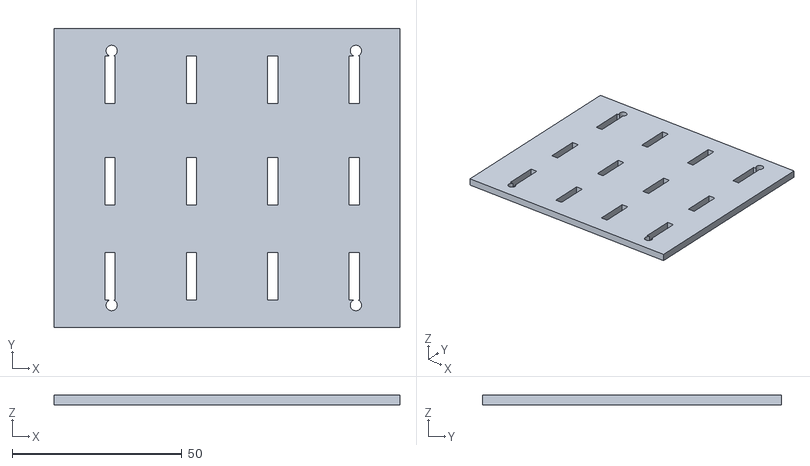
[picture p256: CAD file, 2026-09-28]
output/concealed/wide-eight-wheel/concealed-tray.stl
102.0 x 88.0 x 3.00
