JeremyProffittOrg/wopr/output/model/wopr-parts.3mf

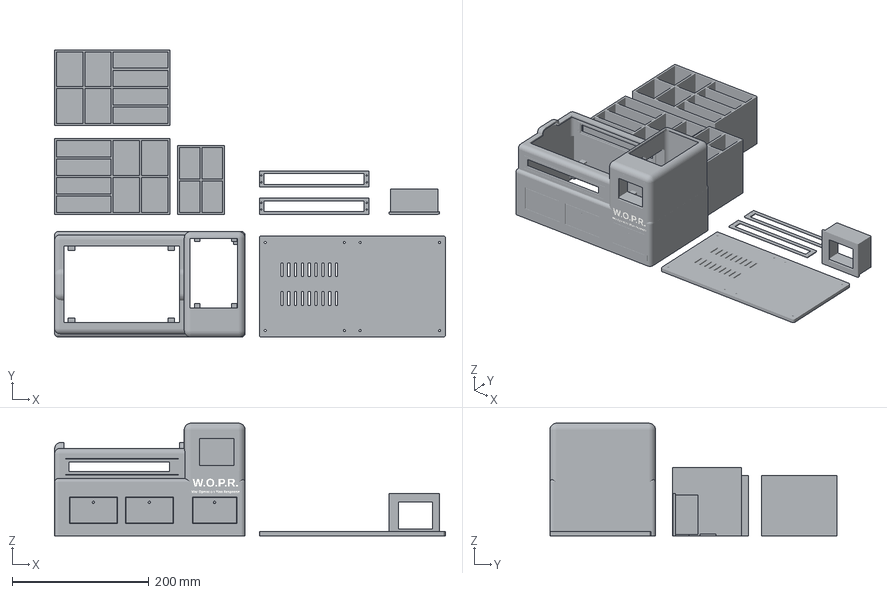
[picture p257: CAD file, 2026-09-27]
output/model/wopr-parts.3mf
572.8 x 421.0 x 165.0 mm
WOPR one-piece shell - assign gray and white
base
cup-main-shallow-left
cup-tower
led-retainer x 2
fit-coupon
cup-main-shallow-right
