JeremyProffittOrg/wopr/output/reinforced/bambu-projects/wopr-wide-one-piece-cap.3mf

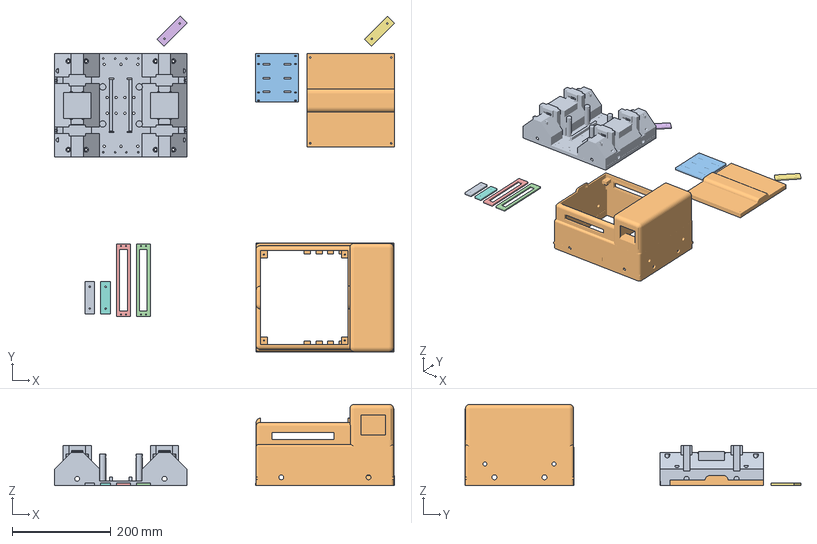
[picture p258: CAD file, 2026-10-02]
output/reinforced/bambu-projects/wopr-wide-one-piece-cap.3mf
688.8 x 680.0 x 165.0 mm
r-frame
r-lid
r-tray
r-retainer
r-cap
WOPR wide-one-piece-cap body
