JeremyProffittOrg/wopr/output/reinforced/exposed/r-cap.stl

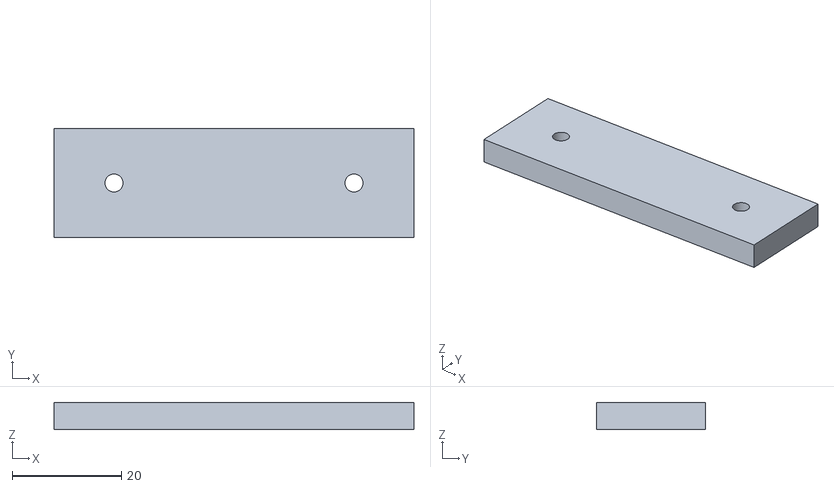
[picture p259: CAD file, 2026-10-02]
output/reinforced/exposed/r-cap.stl
66.0 x 20.0 x 5.00
