JeremyProffittOrg/wopr/output/reinforced/four/r-shell.stl

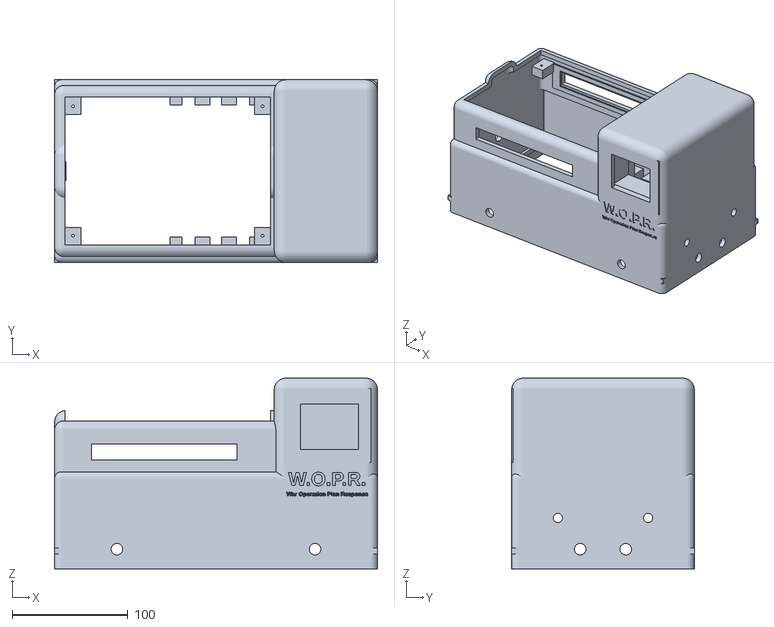
[picture p260: CAD file, 2026-10-02]
output/reinforced/four/r-shell.stl
279.4 x 158.0 x 165.0
