JeremyProffittOrg/wopr/output/reinforced/seven/shell-two-color.3mf

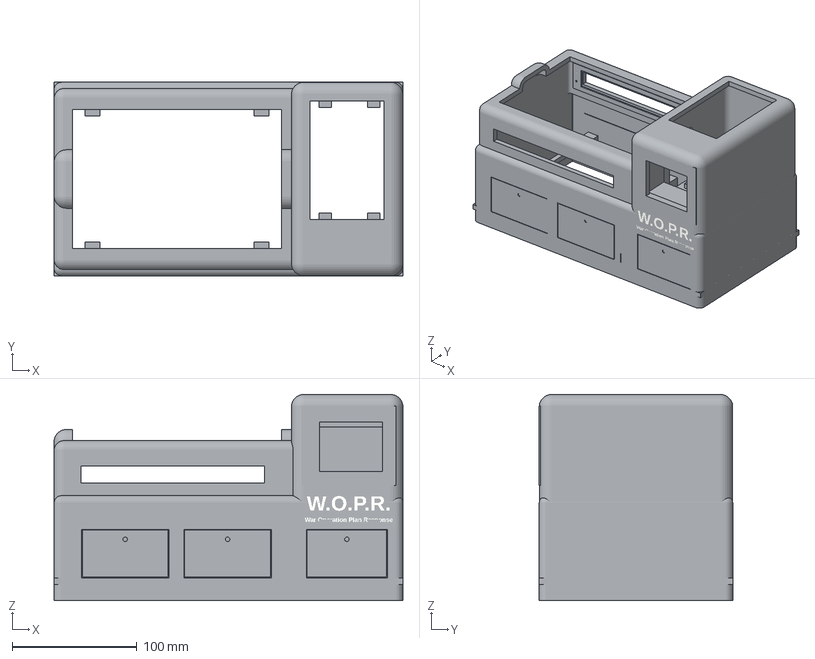
[picture p261: CAD file, 2026-10-02]
output/reinforced/seven/shell-two-color.3mf
279.4 x 155.0 x 165.0 mm
