JeremyProffittOrg/wopr/output/reinforced/wide/shell-two-color.3mf

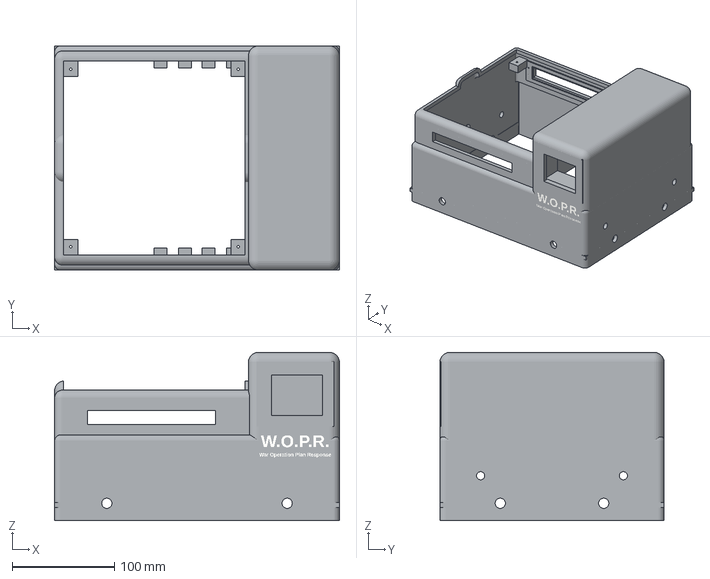
[picture p262: CAD file, 2026-10-02]
output/reinforced/wide/shell-two-color.3mf
279.4 x 220.0 x 165.0 mm
