JeremyProffittOrg/wopr/output/variants/robot/robot-shell.stl

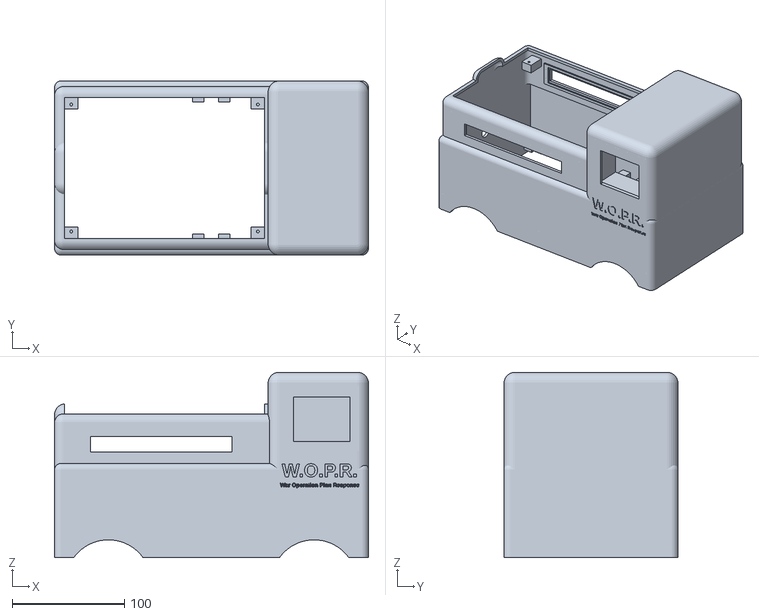
[picture p263: CAD file, 2026-09-28]
output/variants/robot/robot-shell.stl
279.3 x 155.0 x 165.0
