JeremyProffittOrg/wopr/output/wording-test/wopr-two-filament-test.3mf

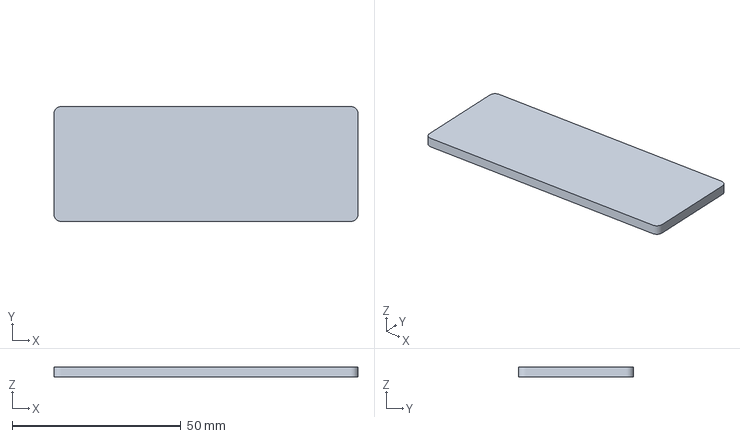
[picture p264: CAD file, 2026-09-27]
output/wording-test/wopr-two-filament-test.3mf
90.0 x 34.0 x 3.00 mm
