JeremyProffittOrg/wopr/output/concealed/wide-eight-wheel/concealed-floor.stl

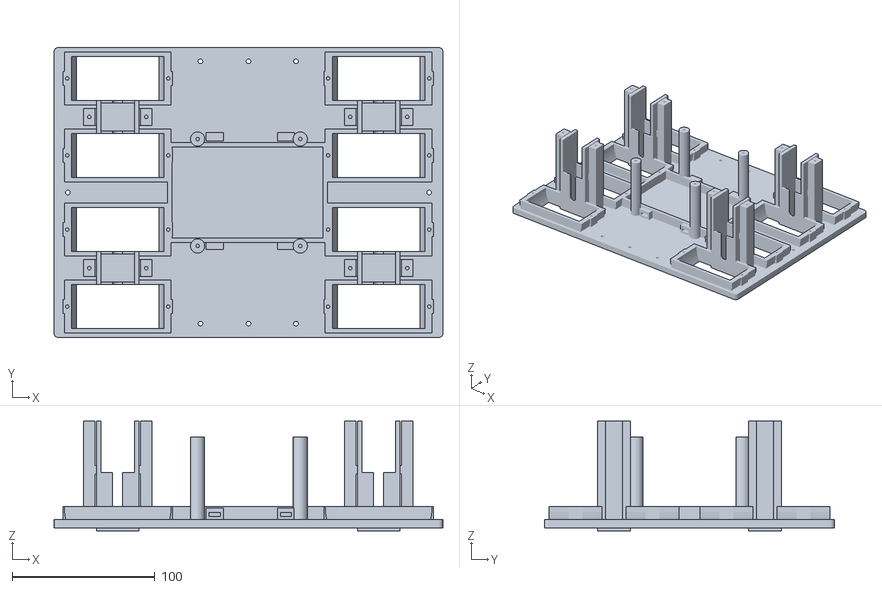
[picture p265: CAD file, 2026-09-28]
output/concealed/wide-eight-wheel/concealed-floor.stl
272.8 x 203.4 x 77.0
