JeremyProffittOrg/wopr/output/reinforced/bambu-projects/wopr-exposed-one-piece-zip.3mf

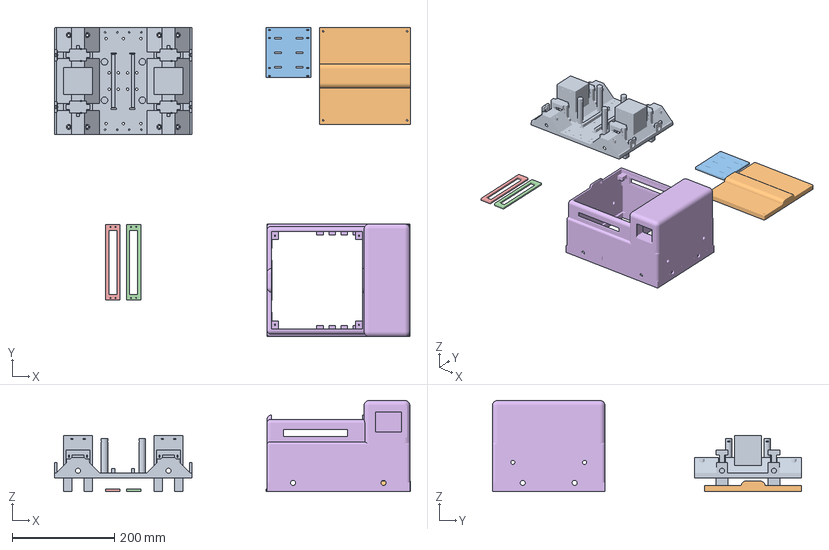
[picture p266: CAD file, 2026-10-02]
output/reinforced/bambu-projects/wopr-exposed-one-piece-zip.3mf
695.4 x 604.0 x 178.0 mm
r-frame-zip
r-lid
r-tray
r-retainer
WOPR exposed-one-piece-zip body
