JeremyProffittOrg/wopr/output/reinforced/exposed/r-shell.stl

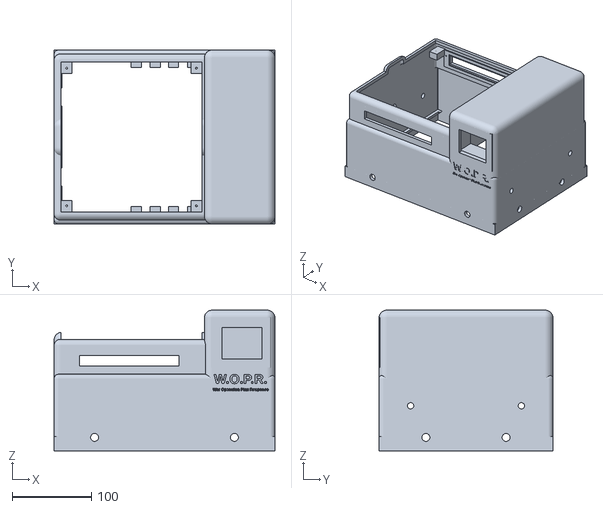
[picture p267: CAD file, 2026-10-02]
output/reinforced/exposed/r-shell.stl
279.4 x 220.0 x 178.0
