JeremyProffittOrg/wopr/output/reinforced/six/r-cup-right.stl

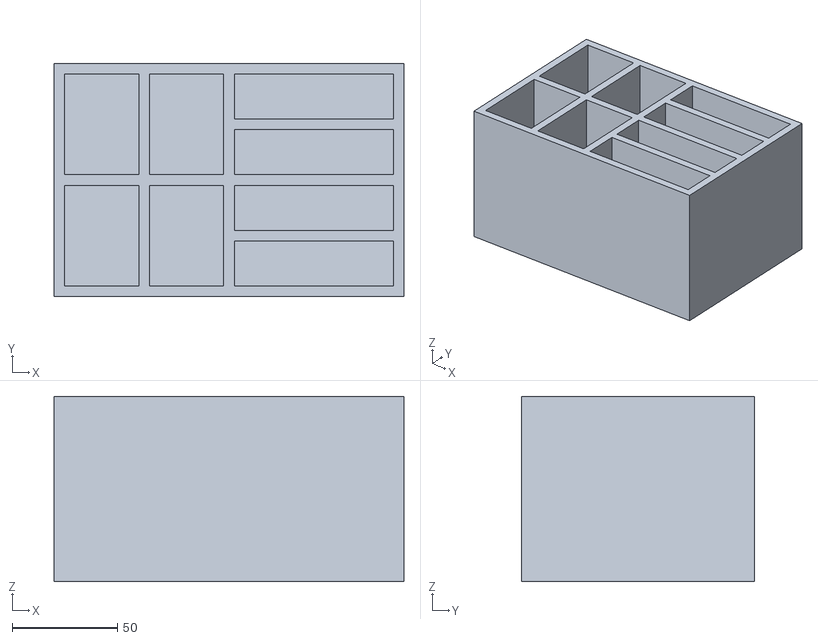
[picture p268: CAD file, 2026-10-02]
output/reinforced/six/r-cup-right.stl
166.4 x 111.0 x 88.0
