JeremyProffittOrg/wopr/output/reinforced/wide/r-frame-zip.stl

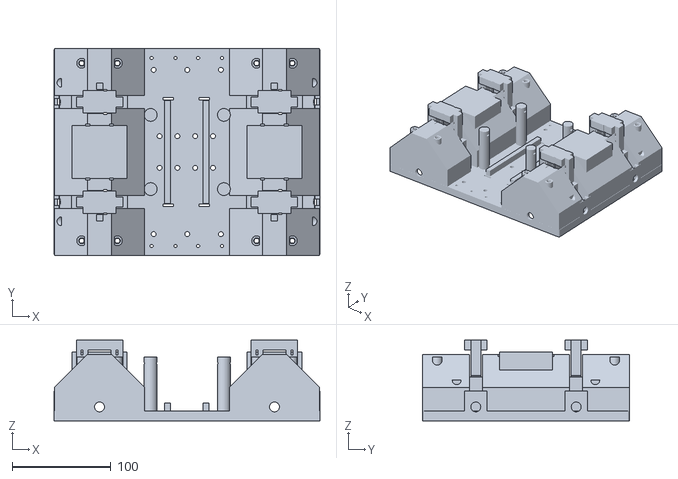
[picture p269: CAD file, 2026-10-02]
output/reinforced/wide/r-frame-zip.stl
268.8 x 209.6 x 81.4
