JeremyProffittOrg/wopr/output/wording-test/wording-gray.stl

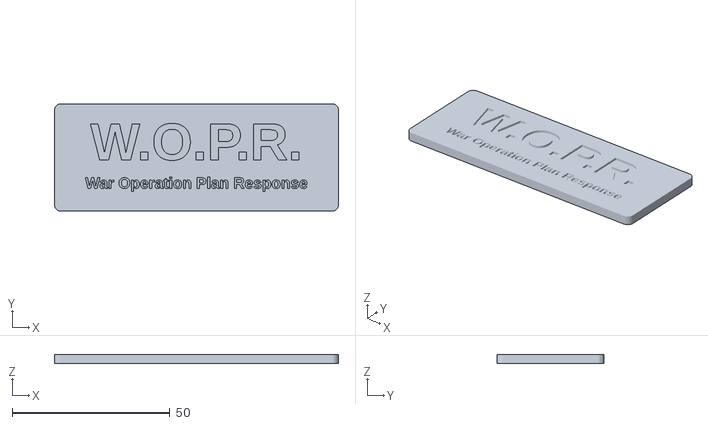
[picture p270: CAD file, 2026-09-27]
output/wording-test/wording-gray.stl
90.0 x 34.0 x 3.00
