JeremyProffittOrg/wopr/output/concealed/four-wheel/concealed-floor.stl

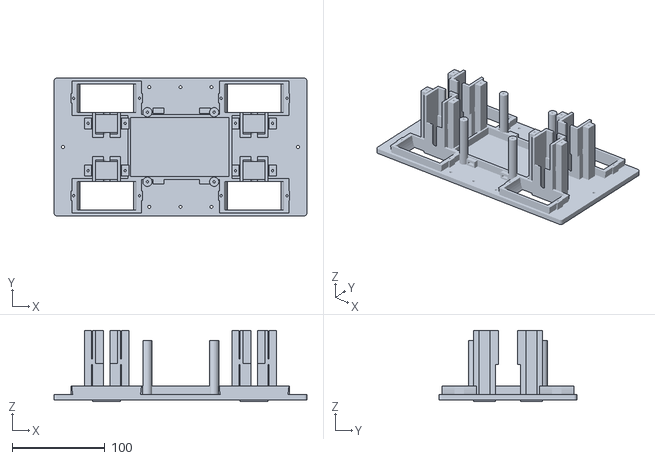
[picture p271: CAD file, 2026-09-28]
output/concealed/four-wheel/concealed-floor.stl
272.8 x 148.4 x 77.0
