JeremyProffittOrg/wopr/output/concealed/wide-eight-wheel/fit-coupon.stl

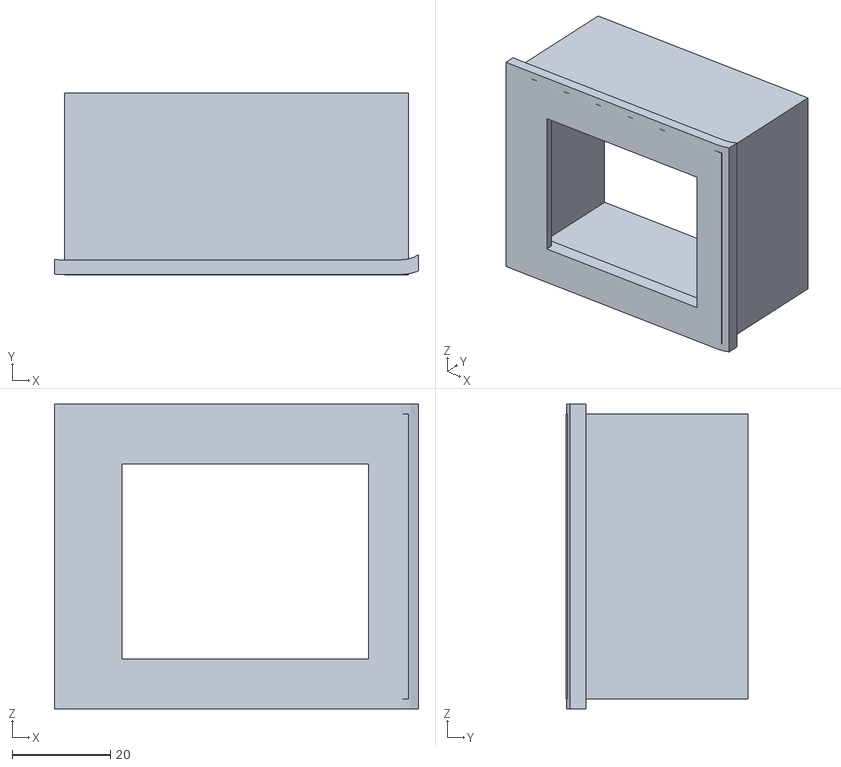
[picture p272: CAD file, 2026-09-28]
output/concealed/wide-eight-wheel/fit-coupon.stl
74.0 x 36.9 x 62.0
