JeremyProffittOrg/wopr/output/reinforced/bambu-projects/wopr-four-one-piece-zip.3mf

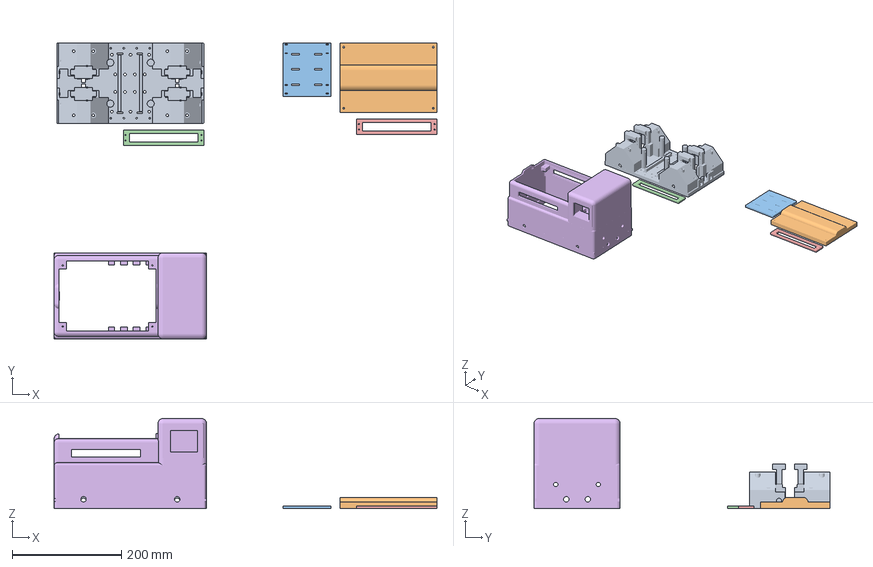
[picture p273: CAD file, 2026-10-02]
output/reinforced/bambu-projects/wopr-four-one-piece-zip.3mf
700.7 x 542.0 x 165.0 mm
r-frame-zip
r-lid
r-tray
r-retainer
WOPR four-one-piece-zip body
