JeremyProffittOrg/wopr/output/variants/replica/base.stl

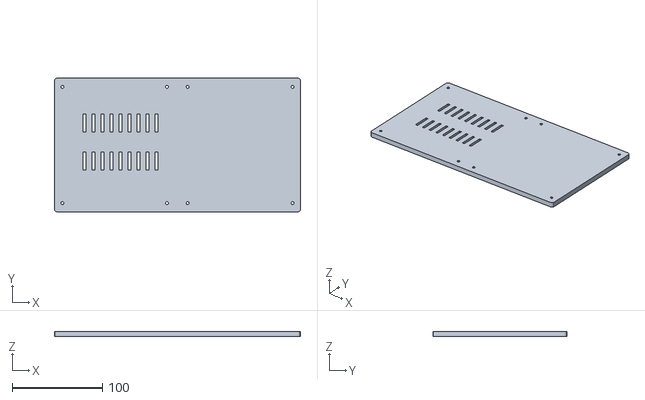
[picture p274: CAD file, 2026-09-28]
output/variants/replica/base.stl
272.8 x 148.4 x 6.00
