JeremyProffittOrg/wopr/output/variants/robot/robot-pod-test.stl

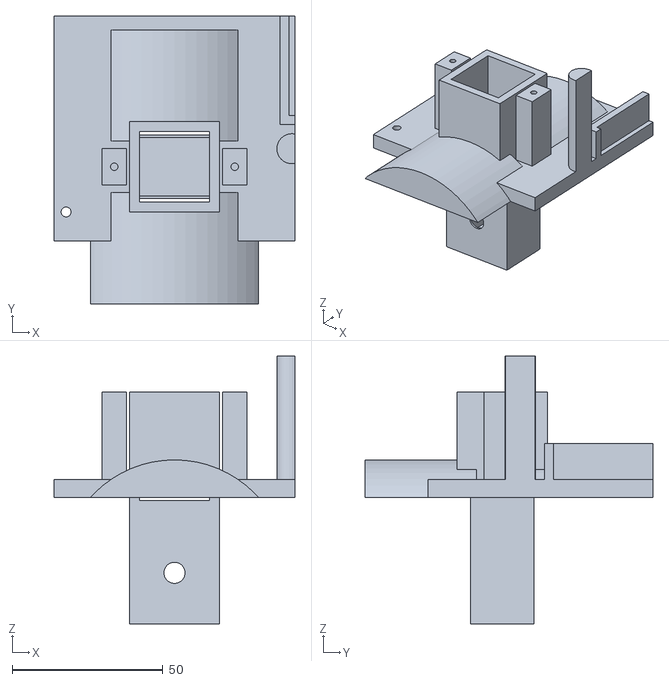
[picture p275: CAD file, 2026-09-28]
output/variants/robot/robot-pod-test.stl
80.0 x 95.5 x 89.0
