JeremyProffittOrg/wopr/output/wording-test/wording-white.stl

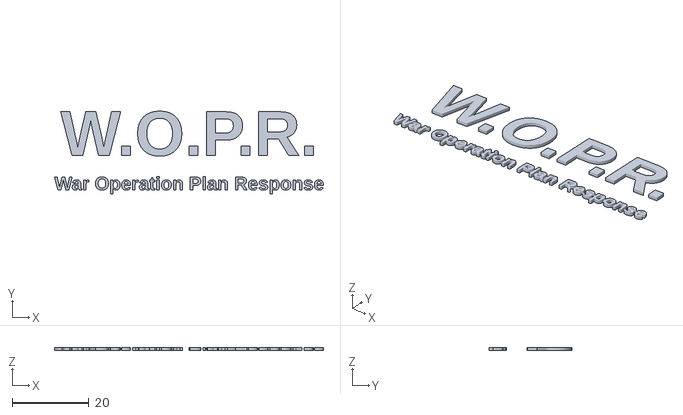
[picture p276: CAD file, 2026-09-27]
output/wording-test/wording-white.stl
70.3 x 21.7 x 0.8
