JeremyProffittOrg/wopr/output/concealed/wide-eight-wheel/white-text.stl

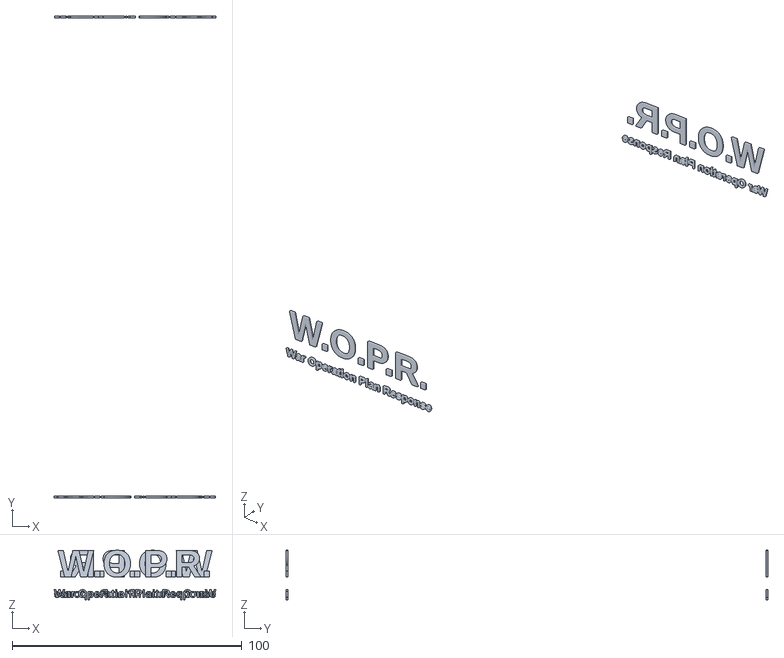
[picture p277: CAD file, 2026-09-28]
output/concealed/wide-eight-wheel/white-text.stl
70.5 x 210.0 x 21.7
