JeremyProffittOrg/wopr/output/reinforced/bambu-projects/wopr-wide-one-piece-zip.3mf

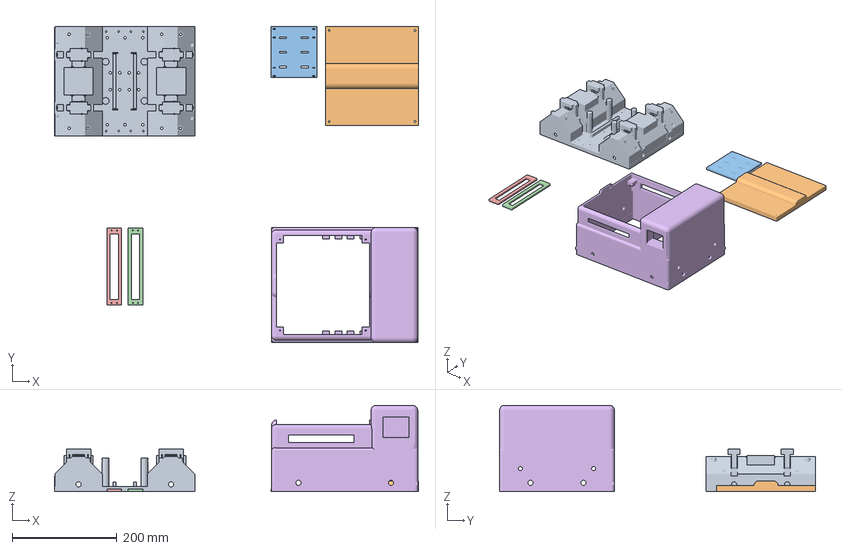
[picture p278: CAD file, 2026-10-02]
output/reinforced/bambu-projects/wopr-wide-one-piece-zip.3mf
695.4 x 604.0 x 165.0 mm
r-frame-zip
r-lid
r-tray
r-retainer
WOPR wide-one-piece-zip body
