JeremyProffittOrg/wopr/output/reinforced/exposed/r-frame-zip.stl

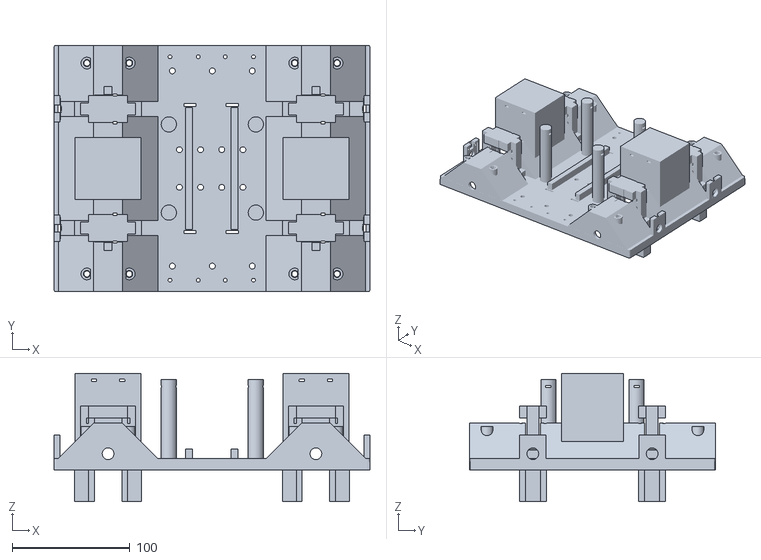
[picture p279: CAD file, 2026-10-02]
output/reinforced/exposed/r-frame-zip.stl
268.8 x 209.6 x 109.0
