JeremyProffittOrg/wopr/output/reinforced/four/r-frame.stl

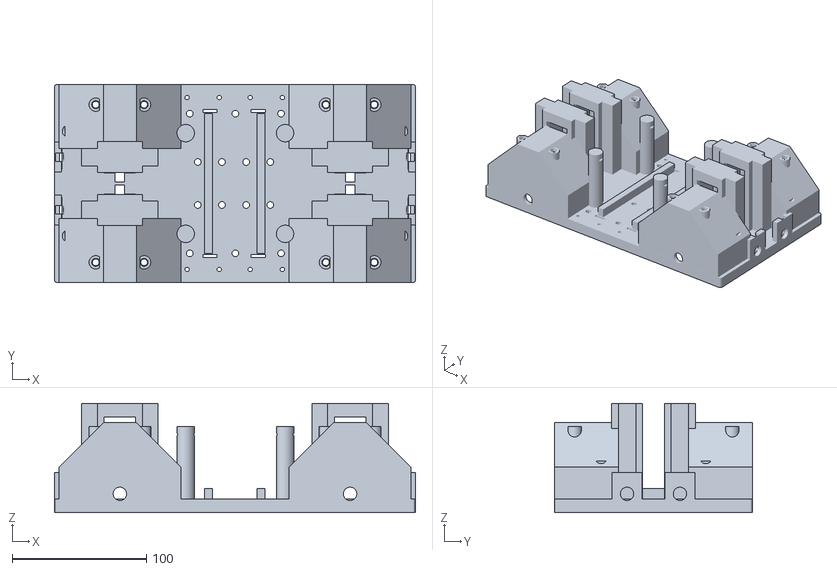
[picture p280: CAD file, 2026-10-02]
output/reinforced/four/r-frame.stl
268.8 x 147.6 x 81.4
