JeremyProffittOrg/wopr/output/variants/replica/cup-tower.stl

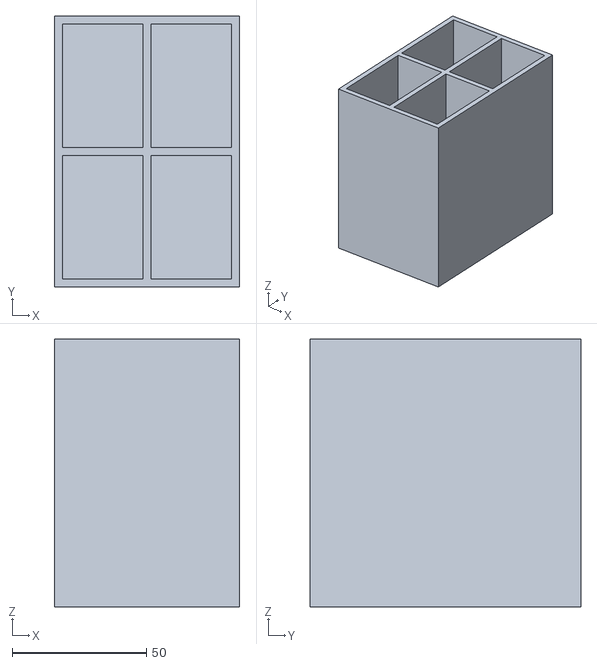
[picture p281: CAD file, 2026-09-26]
output/variants/replica/cup-tower.stl
69.0 x 101.0 x 100.0
