JeremyProffittOrg/wopr/output/concealed/four-wheel/concealed-pod-test.stl

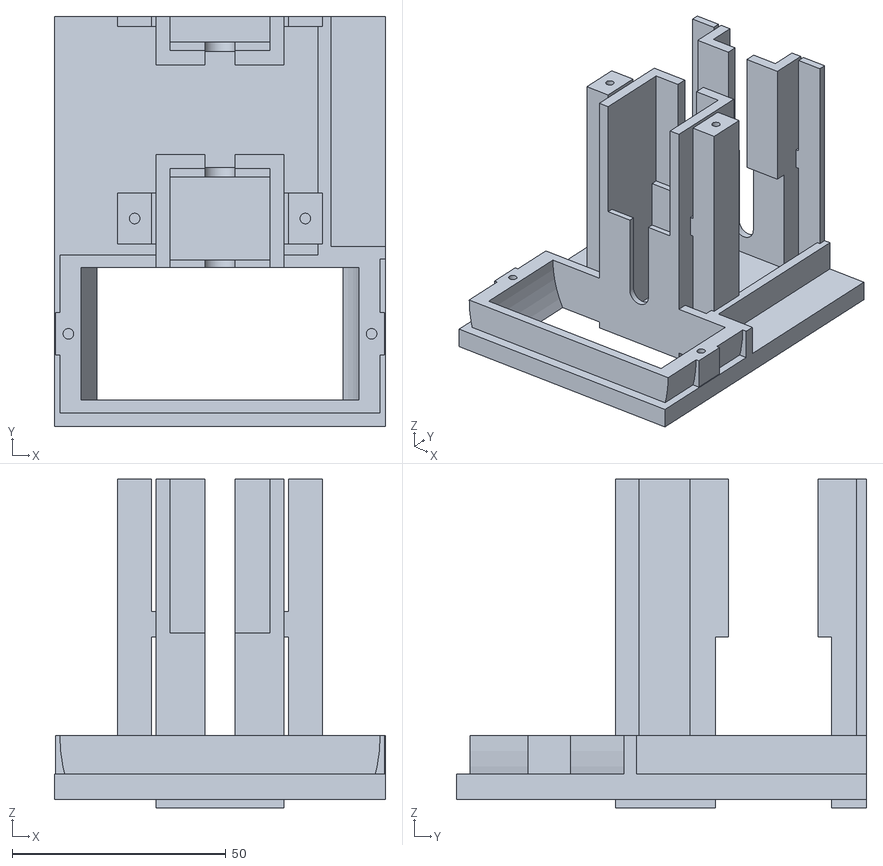
[picture p282: CAD file, 2026-09-28]
output/concealed/four-wheel/concealed-pod-test.stl
77.6 x 96.0 x 77.0
