JeremyProffittOrg/wopr/output/concealed/wide-eight-wheel/robot-lid.stl

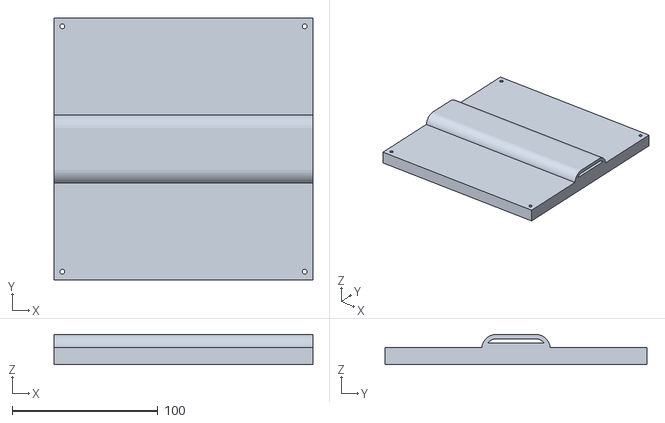
[picture p283: CAD file, 2026-09-28]
output/concealed/wide-eight-wheel/robot-lid.stl
177.4 x 179.4 x 20.7
