JeremyProffittOrg/wopr/output/reinforced/bambu-projects/wopr-exposed-one-piece-cap.3mf

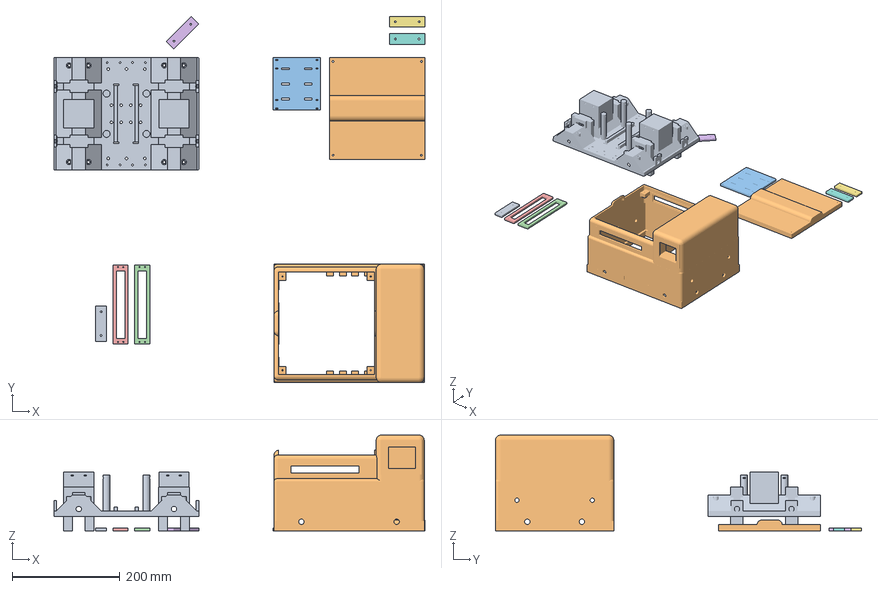
[picture p284: CAD file, 2026-10-02]
output/reinforced/bambu-projects/wopr-exposed-one-piece-cap.3mf
688.8 x 680.0 x 178.0 mm
r-frame
r-lid
r-tray
r-retainer
r-cap
WOPR exposed-one-piece-cap body
