JeremyProffittOrg/wopr/output/reinforced/exposed/r-lcd-coupon.stl

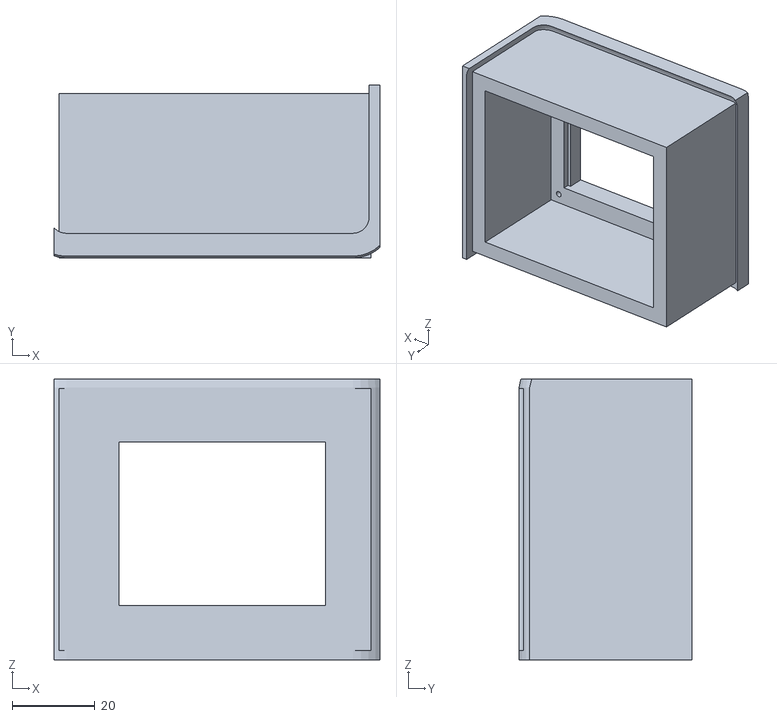
[picture p285: CAD file, 2026-10-02]
output/reinforced/exposed/r-lcd-coupon.stl
79.0 x 42.0 x 68.0
