JeremyProffittOrg/wopr/output/reinforced/seven/r-frame.stl

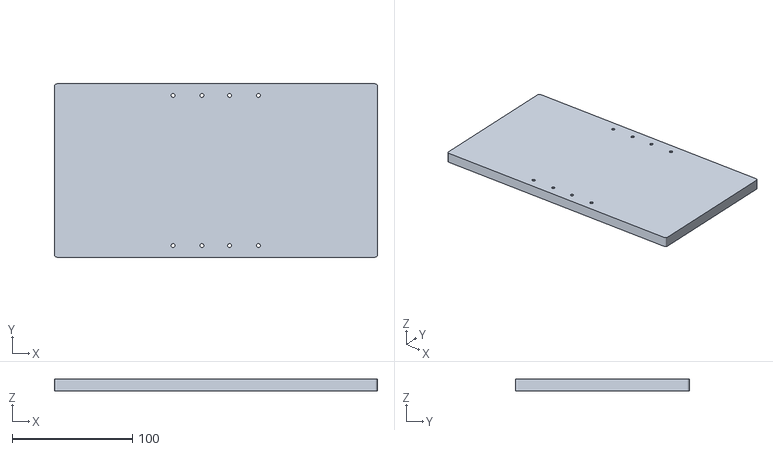
[picture p286: CAD file, 2026-09-29]
output/reinforced/seven/r-frame.stl
268.8 x 144.4 x 10.0
