JeremyProffittOrg/wopr/output/reinforced/wide/r-frame.stl

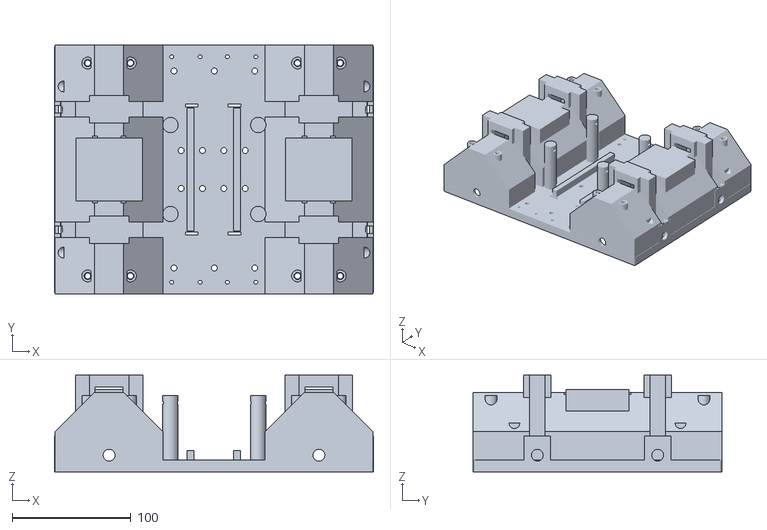
[picture p287: CAD file, 2026-10-02]
output/reinforced/wide/r-frame.stl
268.8 x 209.6 x 81.4
