JeremyProffittOrg/wopr/output/variants/robot/robot-floor.stl

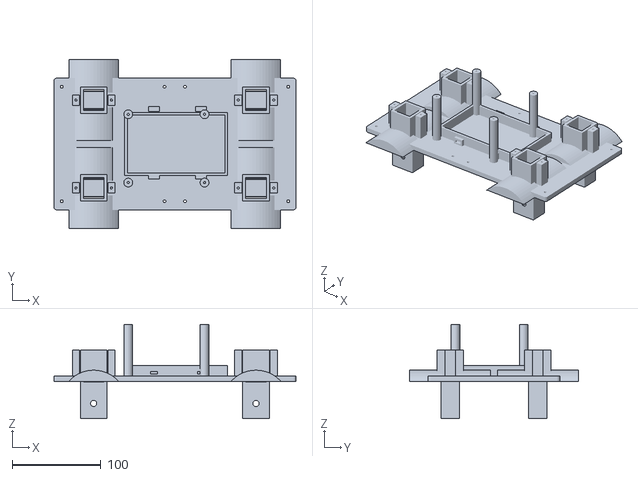
[picture p288: CAD file, 2026-09-28]
output/variants/robot/robot-floor.stl
272.8 x 190.0 x 106.0
