JeremyProffittOrg/wopr/output/concealed/wide-eight-wheel/concealed-shell.stl

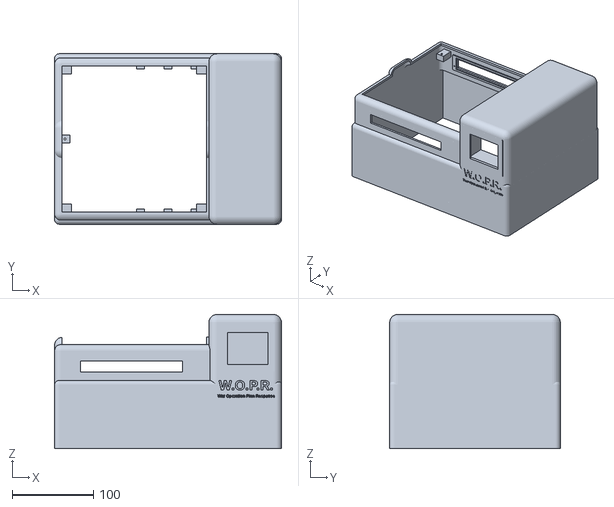
[picture p289: CAD file, 2026-09-28]
output/concealed/wide-eight-wheel/concealed-shell.stl
279.4 x 210.0 x 165.0
