JeremyProffittOrg/wopr/output/reinforced/bambu-projects/wopr-four-one-piece-cap.3mf

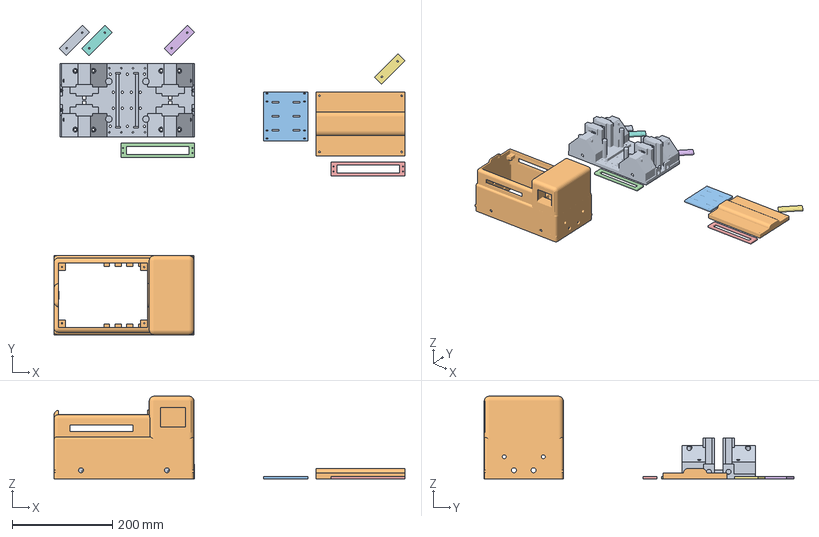
[picture p290: CAD file, 2026-10-02]
output/reinforced/bambu-projects/wopr-four-one-piece-cap.3mf
700.7 x 618.0 x 165.0 mm
r-frame
r-lid
r-tray
r-retainer
r-cap
WOPR four-one-piece-cap body
