JeremyProffittOrg/wopr/output/reinforced/exposed/r-frame.stl

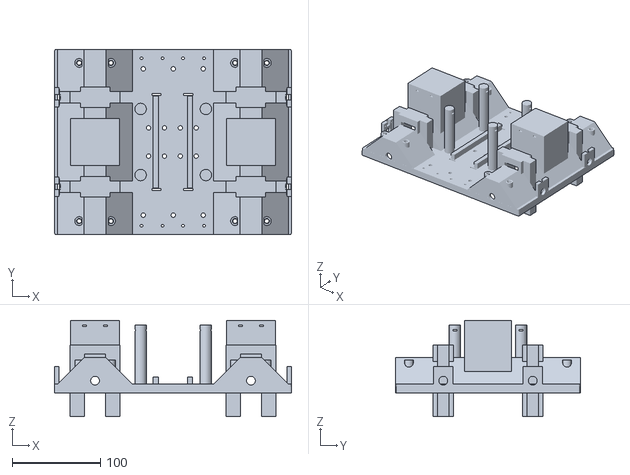
[picture p291: CAD file, 2026-10-02]
output/reinforced/exposed/r-frame.stl
268.8 x 209.6 x 109.0
