JeremyProffittOrg/wopr/output/reinforced/four/r-lid.stl

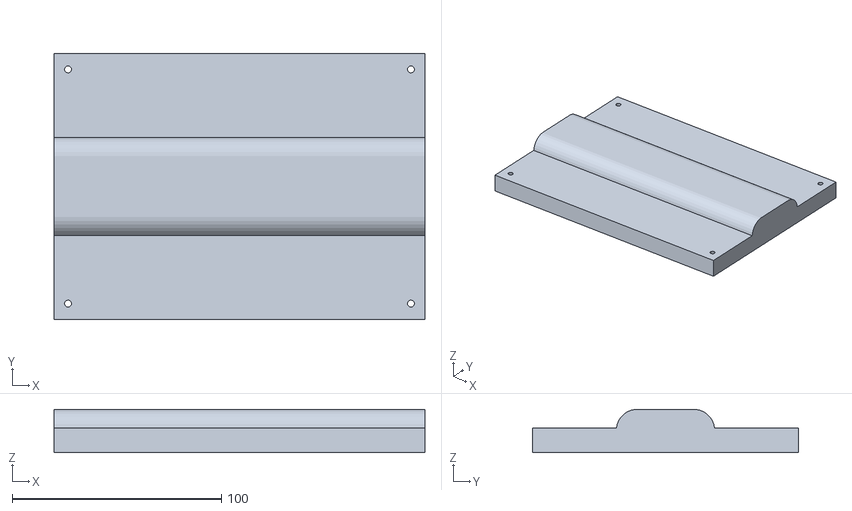
[picture p292: CAD file, 2026-09-29]
output/reinforced/four/r-lid.stl
177.4 x 127.4 x 20.7
