JeremyProffittOrg/wopr/output/reinforced/six/r-cup-tower.stl

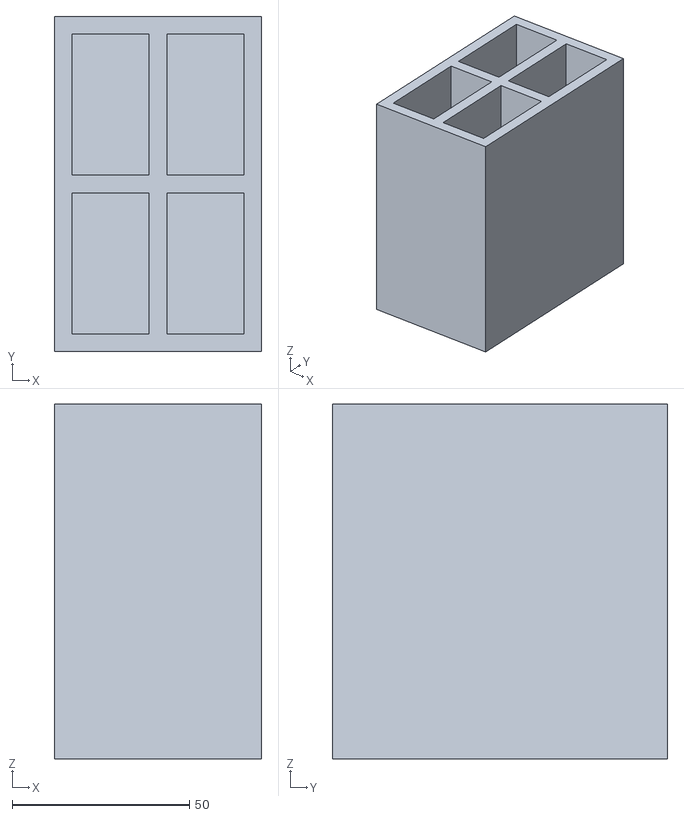
[picture p293: CAD file, 2026-09-29]
output/reinforced/six/r-cup-tower.stl
58.4 x 94.4 x 100.0
