JeremyProffittOrg/wopr/output/reinforced/wide/r-tray.stl

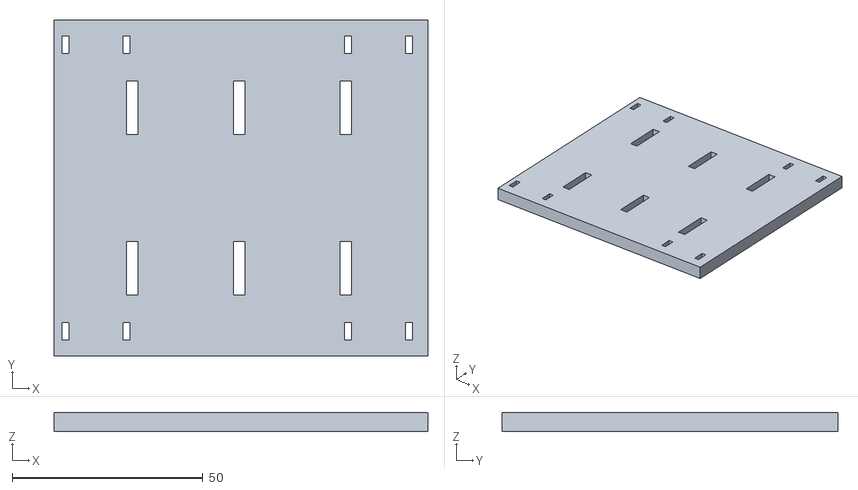
[picture p294: CAD file, 2026-09-29]
output/reinforced/wide/r-tray.stl
98.0 x 88.0 x 5.00
