JeremyProffittOrg/wopr/output/reinforced/four/r-white.stl

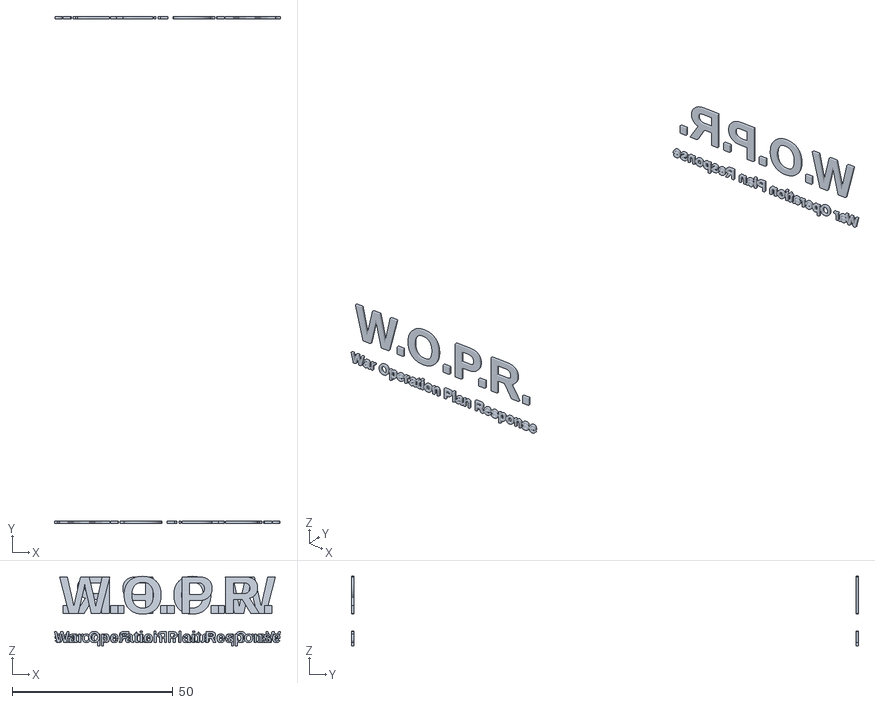
[picture p295: CAD file, 2026-09-29]
output/reinforced/four/r-white.stl
70.5 x 157.9 x 21.7
