JeremyProffittOrg/wopr/output/reinforced/six/r-white.stl

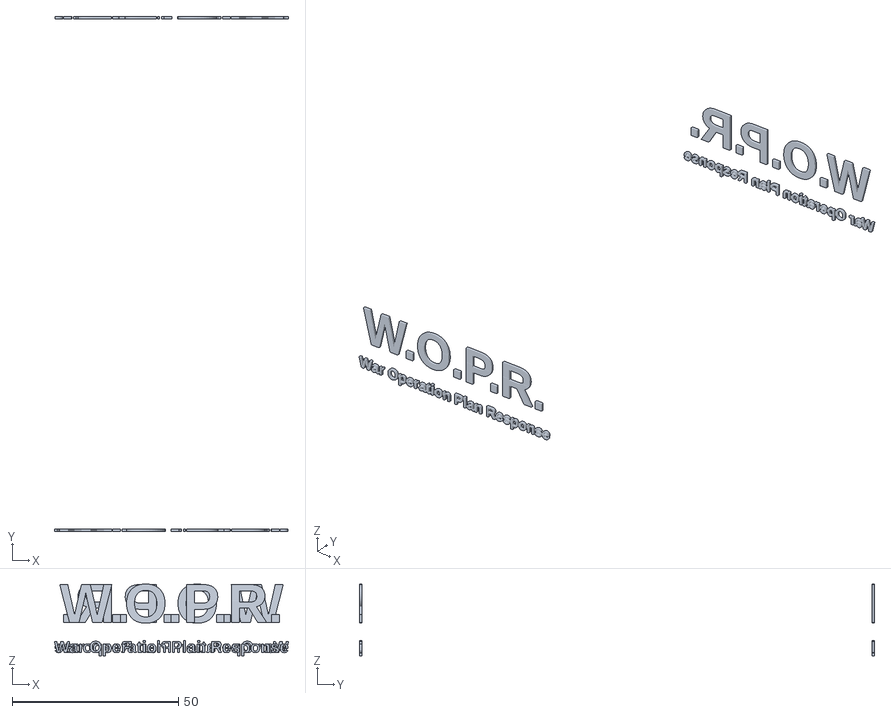
[picture p296: CAD file, 2026-09-29]
output/reinforced/six/r-white.stl
70.5 x 154.9 x 21.7
