JeremyProffittOrg/wopr/output/concealed/four-wheel/robot-cap.stl

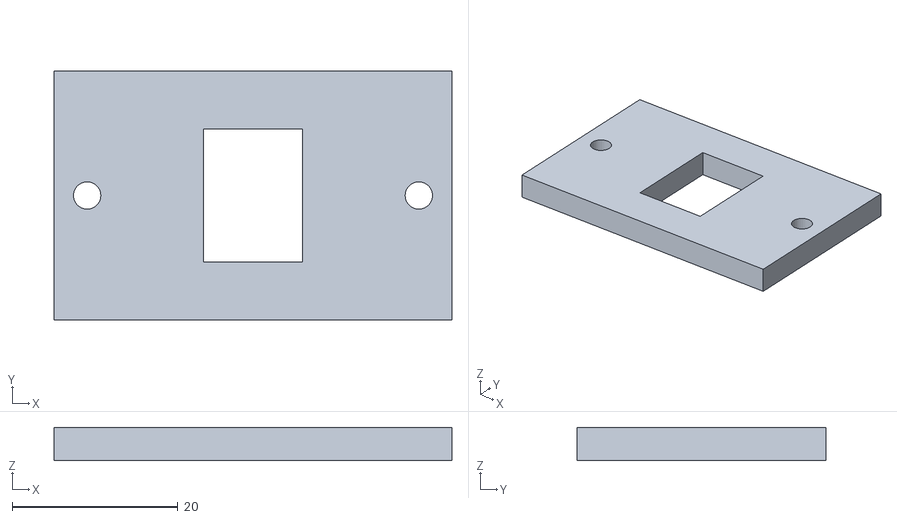
[picture p297: CAD file, 2026-09-28]
output/concealed/four-wheel/robot-cap.stl
48.0 x 30.0 x 4.00
