JeremyProffittOrg/wopr/output/concealed/wide-eight-wheel/concealed-pod-test.stl

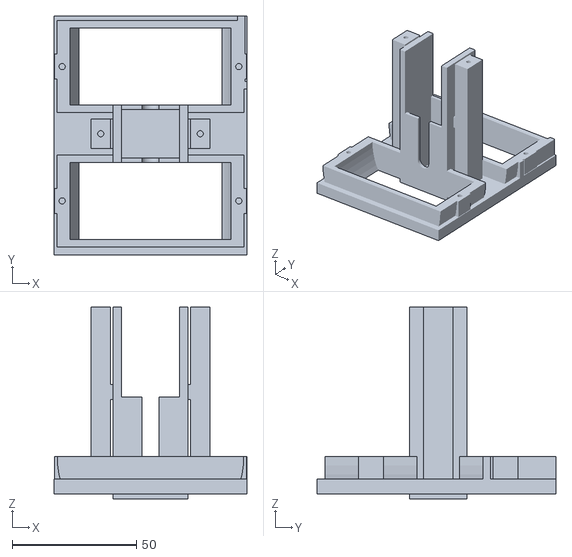
[picture p298: CAD file, 2026-09-28]
output/concealed/wide-eight-wheel/concealed-pod-test.stl
77.6 x 96.0 x 77.0
