JeremyProffittOrg/wopr/output/reinforced/exposed/r-retainer.stl

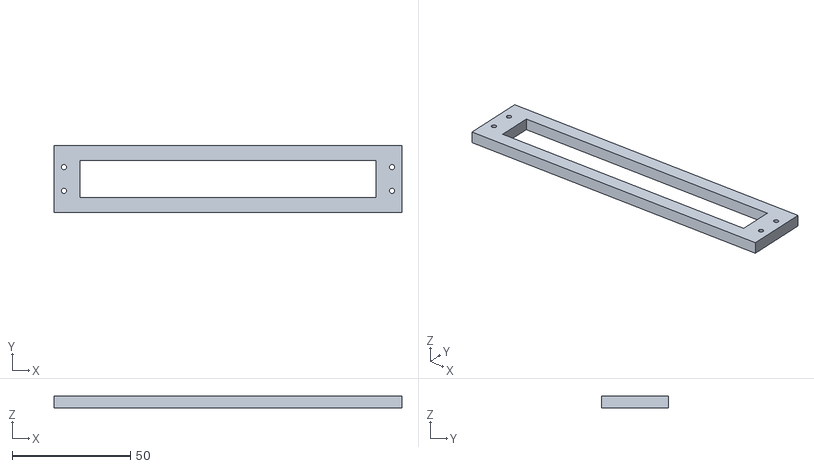
[picture p299: CAD file, 2026-09-29]
output/reinforced/exposed/r-retainer.stl
147.2 x 28.4 x 5.00
