JeremyProffittOrg/wopr/output/reinforced/seven/r-retainer.stl

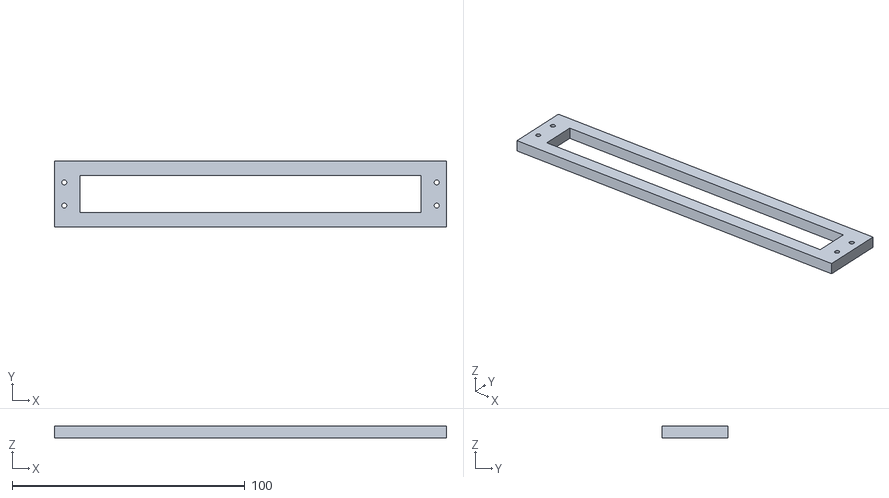
[picture p300: CAD file, 2026-09-29]
output/reinforced/seven/r-retainer.stl
168.5 x 28.4 x 5.00
