JeremyProffittOrg/wopr/output/concealed/four-wheel/robot-lid.stl

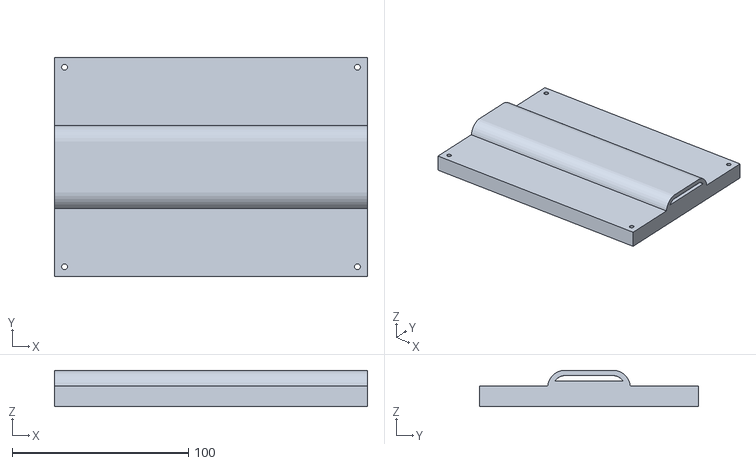
[picture p301: CAD file, 2026-09-28]
output/concealed/four-wheel/robot-lid.stl
177.4 x 124.4 x 20.7
