JeremyProffittOrg/wopr/output/reinforced/exposed/r-white.stl

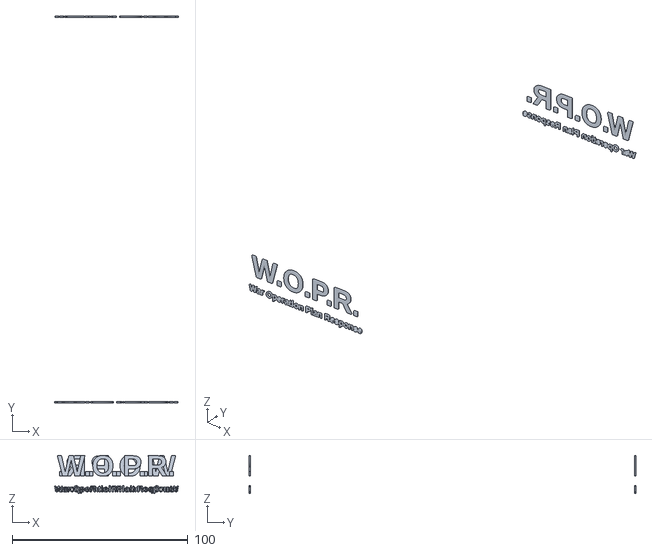
[picture p302: CAD file, 2026-09-29]
output/reinforced/exposed/r-white.stl
70.5 x 219.9 x 21.7
