JeremyProffittOrg/wopr/output/reinforced/wide/r-lid.stl

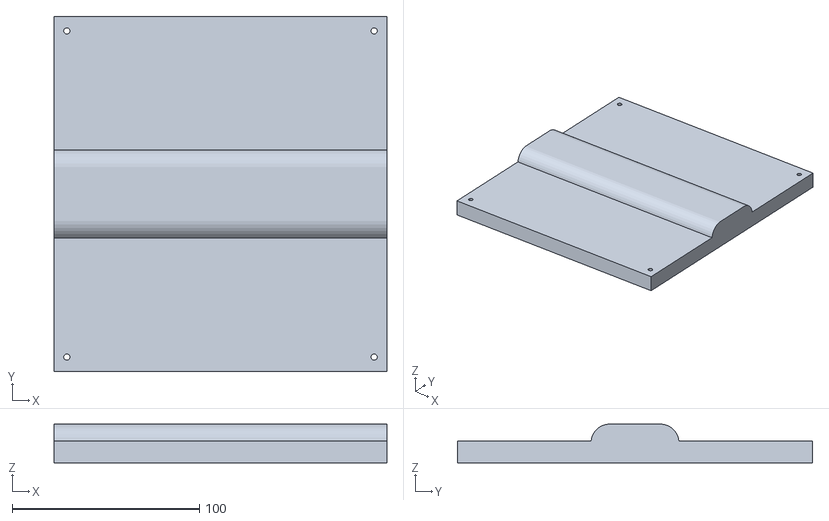
[picture p303: CAD file, 2026-09-29]
output/reinforced/wide/r-lid.stl
177.4 x 189.4 x 20.7
