JeremyProffittOrg/wopr/output/concealed/four-wheel/led-retainer.stl

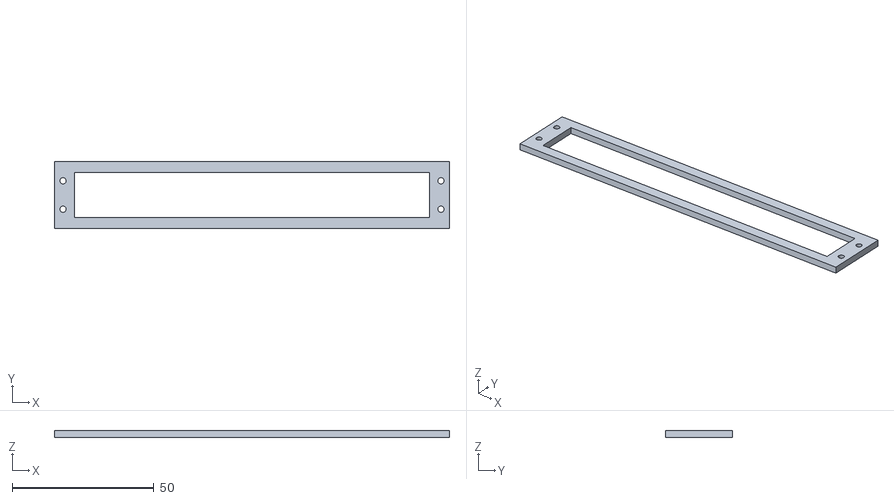
[picture p304: CAD file, 2026-09-28]
output/concealed/four-wheel/led-retainer.stl
139.2 x 23.8 x 2.40
