JeremyProffittOrg/wopr/(list of files, cad)

Other CAD files:
output/variants/replica/cup-main-shallow-left.stl
output/reinforced/six/shell-two-color.3mf
output/variants/replica/shell-two-color.3mf
output/body-projects/wopr-body-single-filament.3mf
output/concealed/four-wheel/wheel-hood-rear.stl
output/reinforced/four/shell-two-color.3mf
output/reinforced/seven/r-shell.stl
output/variants/replica/gray-shell.stl
output/variants/robot/robot-tray.stl
output/reinforced/exposed/shell-two-color.3mf
output/reinforced/six/r-cup-left.stl
output/concealed/four-wheel/concealed-shell.stl
output/reinforced/seven/r-cup-left.stl
output/reinforced/six/r-shell.stl
output/reinforced/wide/r-shell.stl
output/variants/robot/shell-two-color.3mf
output/reinforced/four/r-frame-zip.stl
output/reinforced/six/r-lcd-coupon.stl
output/concealed/four-wheel/shell-two-color.3mf
output/reinforced/seven/r-lcd-coupon.stl
output/concealed/four-wheel/concealed-tray.stl
output/concealed/wide-eight-wheel/wheel-hood-rear.stl
output/reinforced/wide/r-lcd-coupon.stl
output/reinforced/four/r-lcd-coupon.stl
output/concealed/wide-eight-wheel/shell-two-color.3mf
output/reinforced/four/r-tray.stl
output/concealed/four-wheel/fit-coupon.stl
output/concealed/four-wheel/white-text.stl
output/concealed/wide-eight-wheel/wopr-wide-eight-wheel.scad
output/variants/robot/wopr-robot.scad
output/reinforced/four/wopr-reinforced-four.scad
output/reinforced/seven/wopr-reinforced-seven.scad
output/reinforced/six/wopr-reinforced-six.scad
output/reinforced/wide/wopr-reinforced-wide.scad
output/variants/replica/wopr-six-per-side.scad
cad/wopr-concealed.scad
cad/wopr-reinforced.scad
cad/wopr-variants.scad
cad/wopr.scad
