JeremyProffittOrg/wopr/output/concealed/views/four-wheel-assembly-0.png

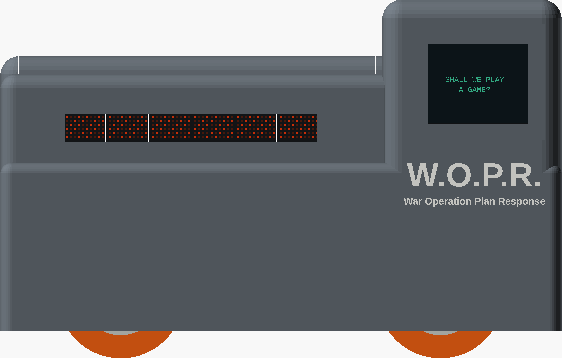
output/concealed/views/four-wheel-assembly-0.png
