JeremyProffittOrg/wopr/output/concealed/views/four-wheel-assembly-1.png

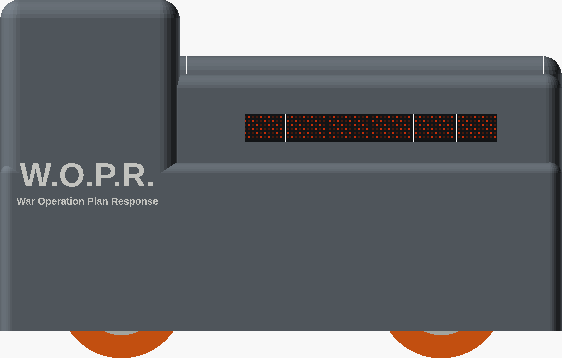
output/concealed/views/four-wheel-assembly-1.png
