JeremyProffittOrg/wopr/output/concealed/views/four-wheel-assembly-2.png

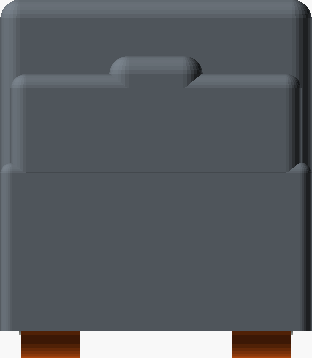
output/concealed/views/four-wheel-assembly-2.png
