JeremyProffittOrg/wopr/output/concealed/views/four-wheel-assembly-4.png

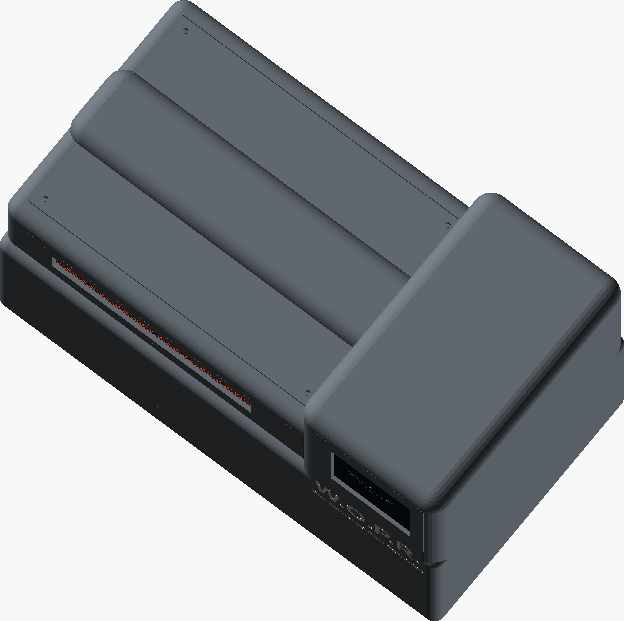
output/concealed/views/four-wheel-assembly-4.png
