JeremyProffittOrg/wopr/output/concealed/views/four-wheel-assembly-5.png

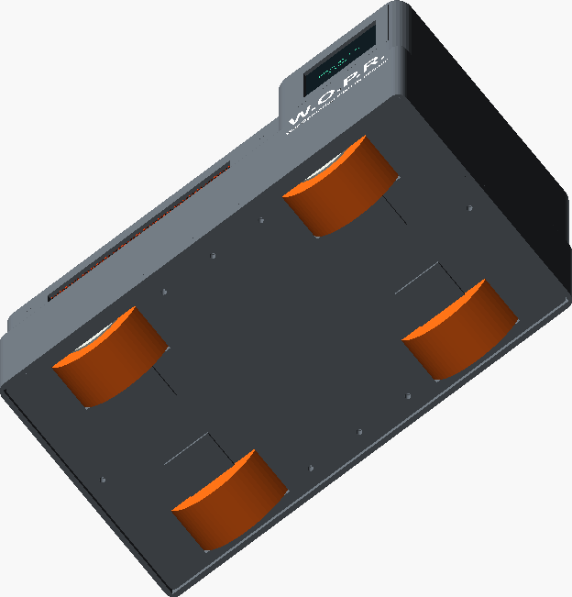
output/concealed/views/four-wheel-assembly-5.png
