JeremyProffittOrg/wopr/output/concealed/views/four-wheel-assembly-6.png

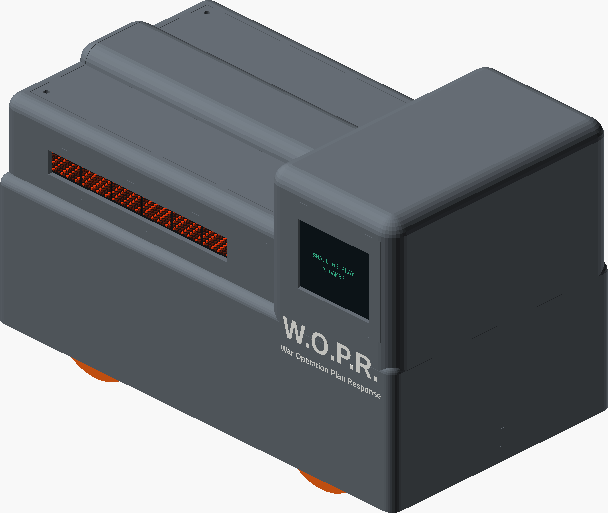
output/concealed/views/four-wheel-assembly-6.png
