JeremyProffittOrg/wopr/output/concealed/views/four-wheel-assembly-7.png

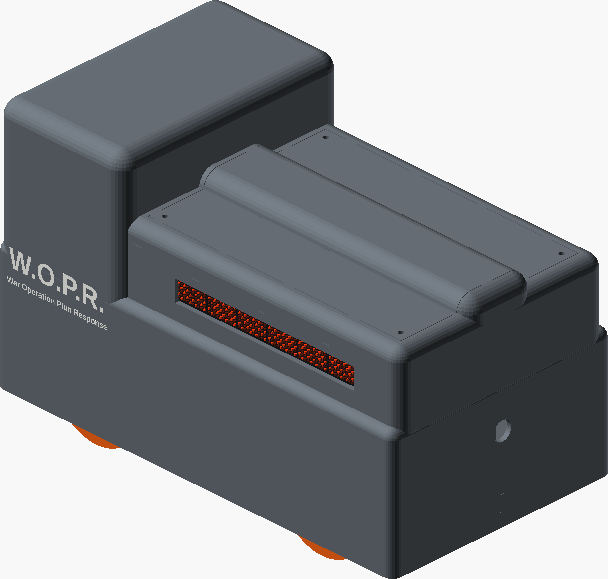
output/concealed/views/four-wheel-assembly-7.png
