JeremyProffittOrg/wopr/output/concealed/views/wide-eight-wheel-assembly-3.png

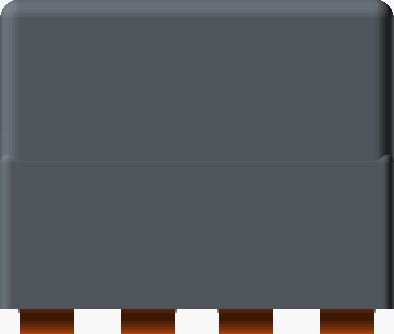
output/concealed/views/wide-eight-wheel-assembly-3.png
