JeremyProffittOrg/wopr/output/concealed/views/wide-eight-wheel-assembly-4.png

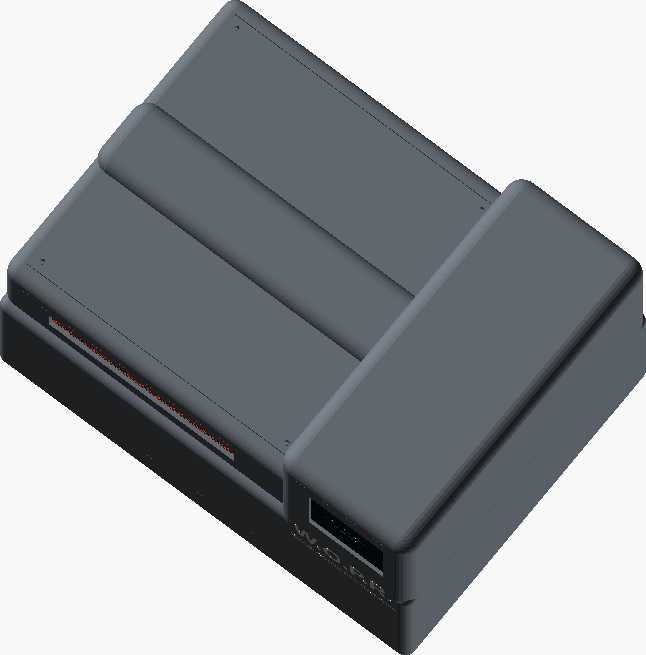
output/concealed/views/wide-eight-wheel-assembly-4.png
