JeremyProffittOrg/wopr/output/concealed/views/wide-eight-wheel-assembly-5.png

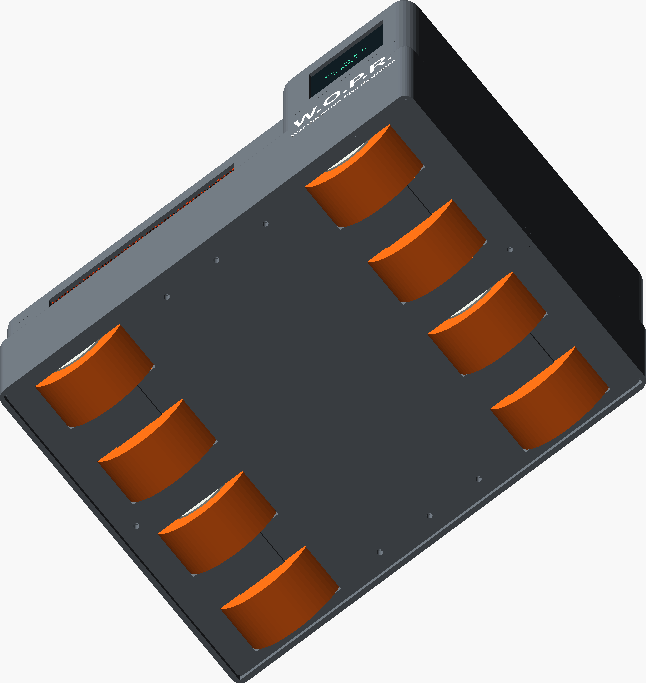
output/concealed/views/wide-eight-wheel-assembly-5.png
