JeremyProffittOrg/wopr/output/concealed/views/wide-eight-wheel-assembly-6.png

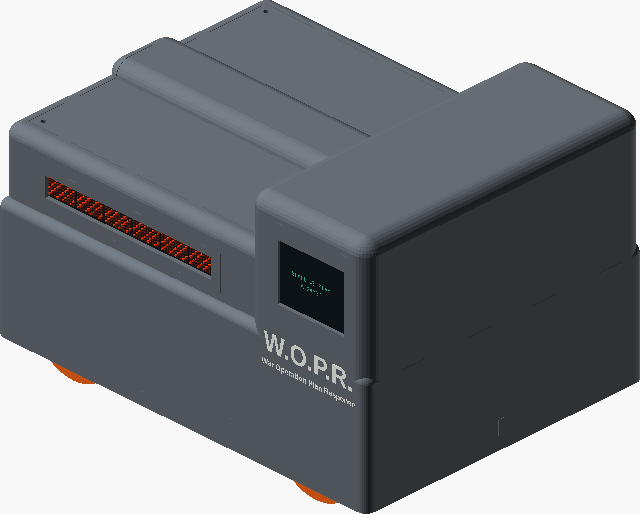
output/concealed/views/wide-eight-wheel-assembly-6.png
