JeremyProffittOrg/wopr/output/concealed/views/wide-eight-wheel-assembly-7.png

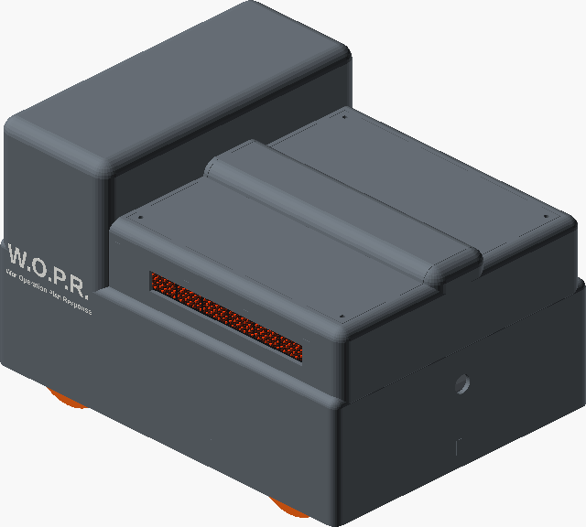
output/concealed/views/wide-eight-wheel-assembly-7.png
