JeremyProffittOrg/wopr/output/reinforced/views/exposed-assembly-0.png

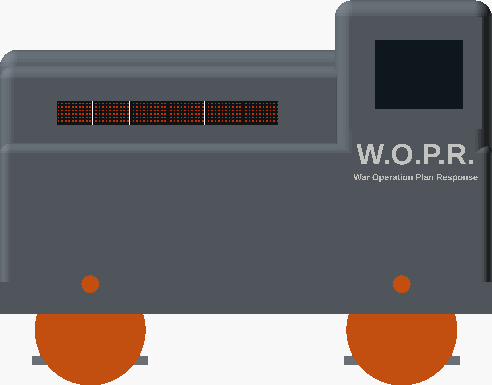
output/reinforced/views/exposed-assembly-0.png
