JeremyProffittOrg/wopr/output/reinforced/views/exposed-assembly-1.png

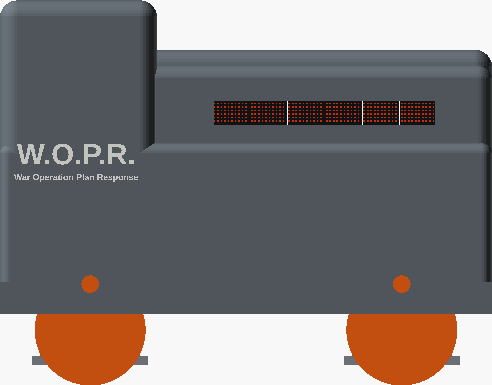
output/reinforced/views/exposed-assembly-1.png
