JeremyProffittOrg/wopr/output/reinforced/views/exposed-assembly-2.png

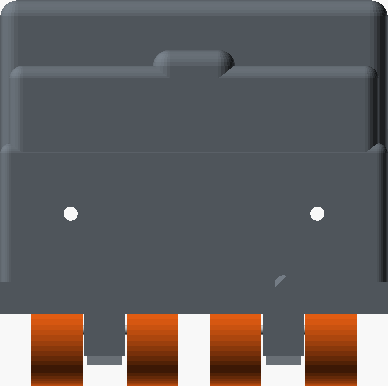
output/reinforced/views/exposed-assembly-2.png
