JeremyProffittOrg/wopr/output/reinforced/views/exposed-assembly-3.png

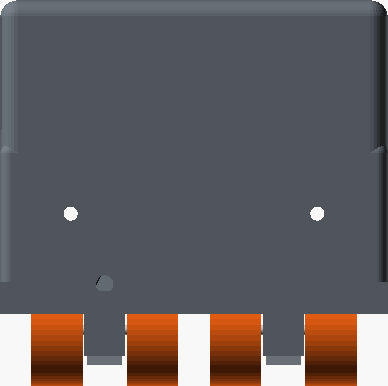
output/reinforced/views/exposed-assembly-3.png
