JeremyProffittOrg/wopr/output/reinforced/views/exposed-assembly-5.png

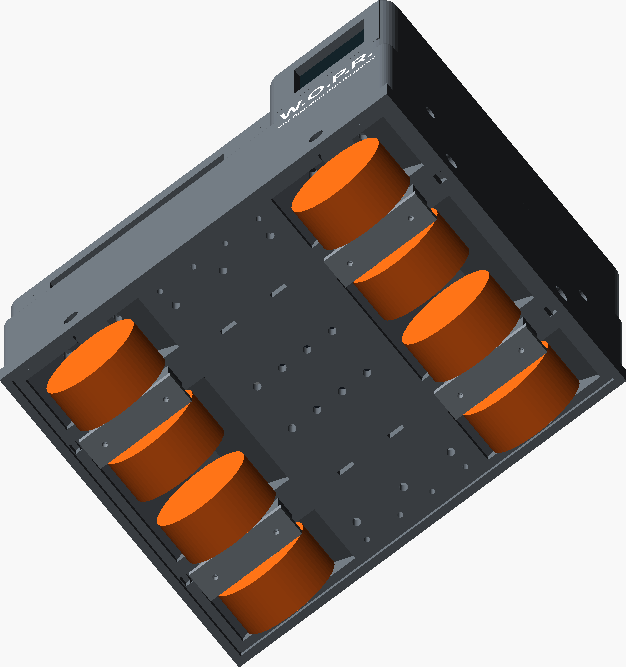
output/reinforced/views/exposed-assembly-5.png
