JeremyProffittOrg/wopr/output/reinforced/views/exposed-assembly-6.png

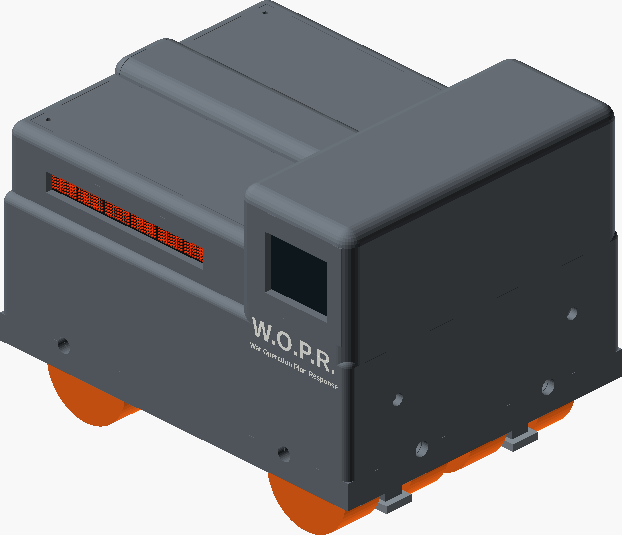
output/reinforced/views/exposed-assembly-6.png
