JeremyProffittOrg/wopr/output/reinforced/views/exposed-assembly-7.png

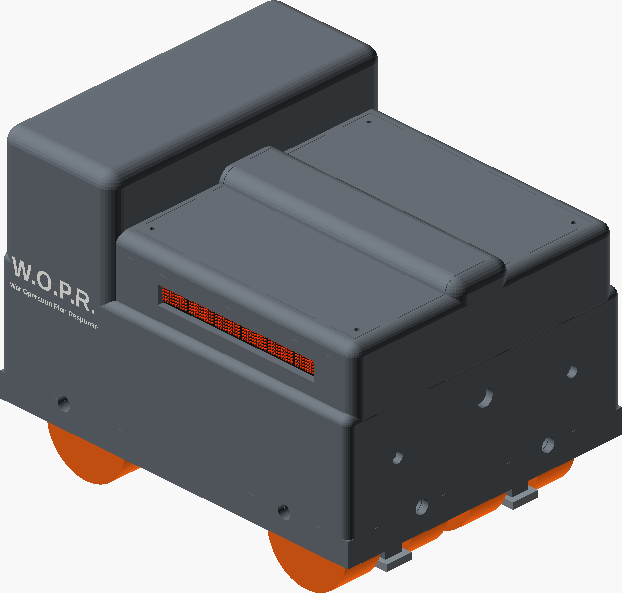
output/reinforced/views/exposed-assembly-7.png
