JeremyProffittOrg/wopr/output/reinforced/views/four-assembly-0.png

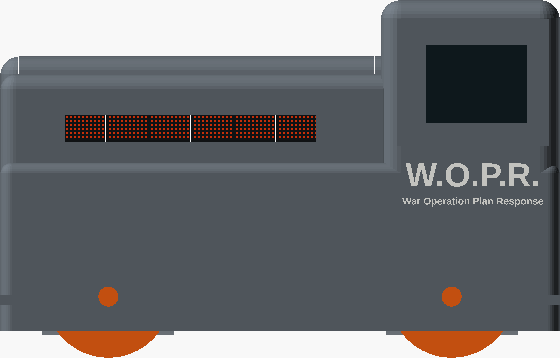
output/reinforced/views/four-assembly-0.png
