JeremyProffittOrg/wopr/output/reinforced/views/four-assembly-1.png

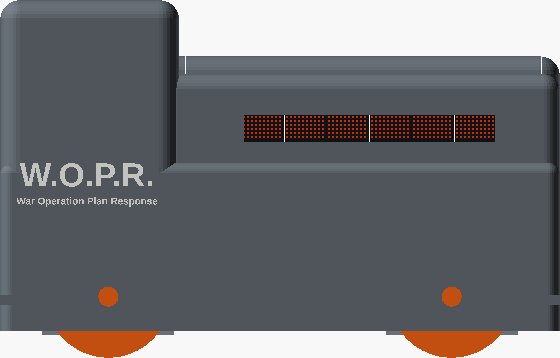
output/reinforced/views/four-assembly-1.png
