JeremyProffittOrg/wopr/output/reinforced/views/four-assembly-3.png

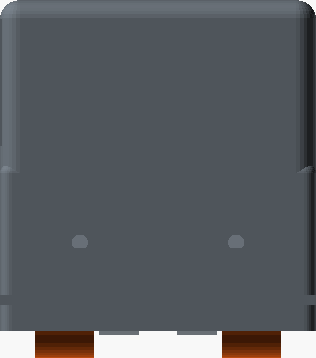
output/reinforced/views/four-assembly-3.png
