JeremyProffittOrg/wopr/output/reinforced/views/four-assembly-5.png

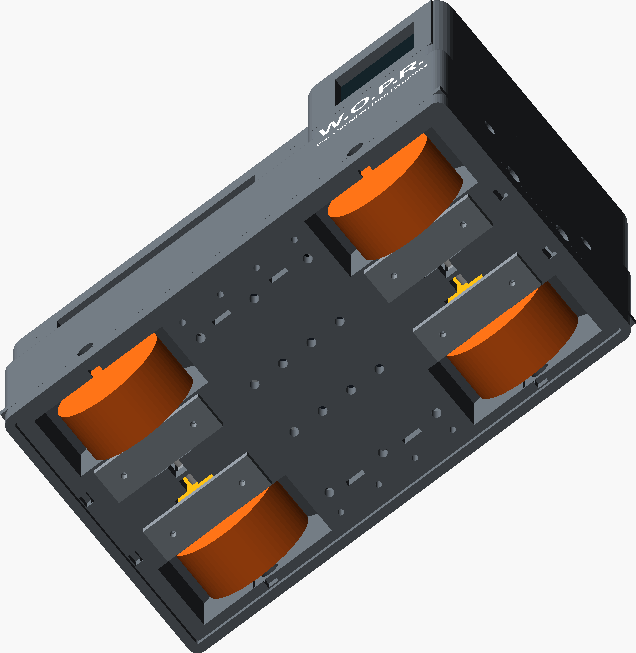
output/reinforced/views/four-assembly-5.png
