JeremyProffittOrg/wopr/output/reinforced/views/seven-assembly-0.png

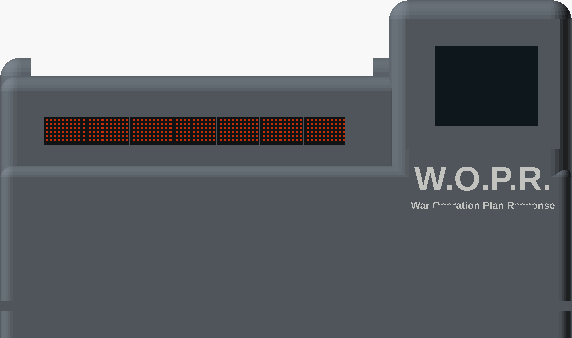
output/reinforced/views/seven-assembly-0.png
