JeremyProffittOrg/wopr/output/reinforced/views/seven-assembly-4.png

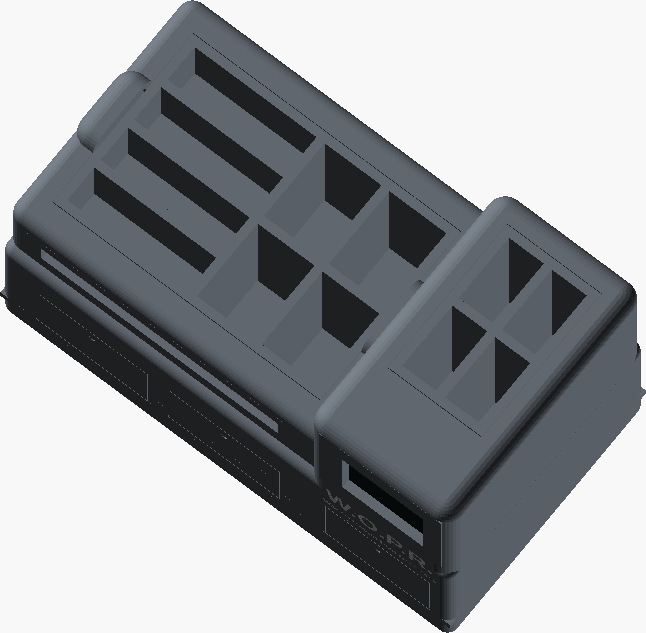
output/reinforced/views/seven-assembly-4.png
