JeremyProffittOrg/wopr/output/reinforced/views/seven-assembly-5.png

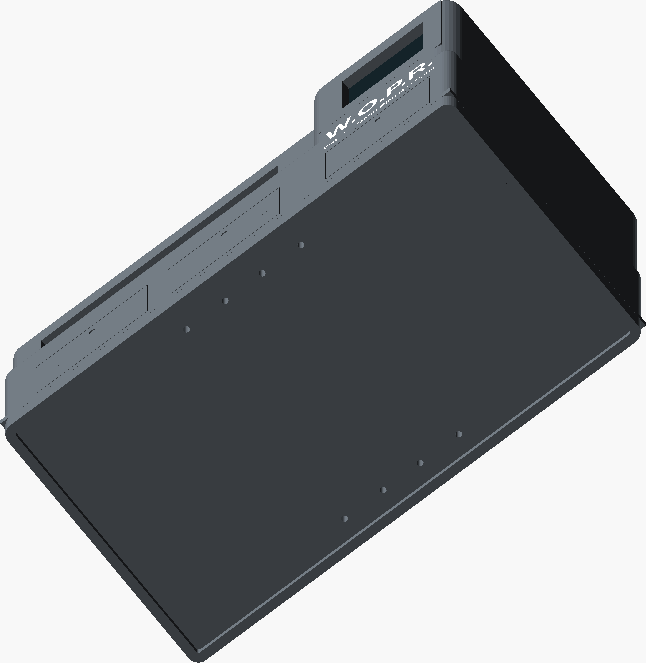
output/reinforced/views/seven-assembly-5.png
