JeremyProffittOrg/wopr/output/reinforced/views/seven-assembly-7.png

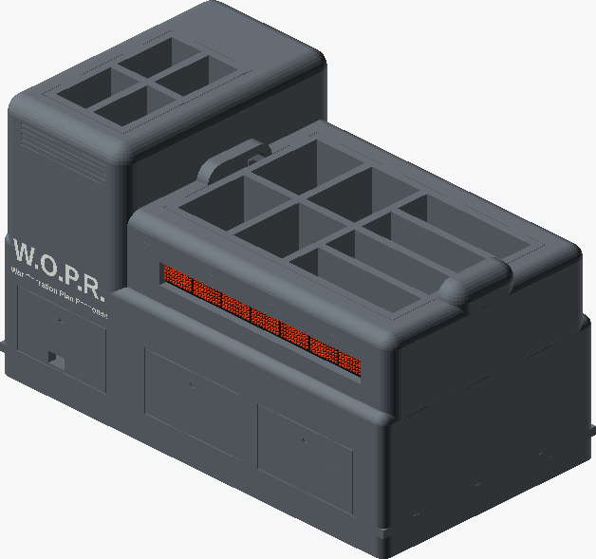
output/reinforced/views/seven-assembly-7.png
