JeremyProffittOrg/wopr/output/reinforced/views/wide-assembly-2.png

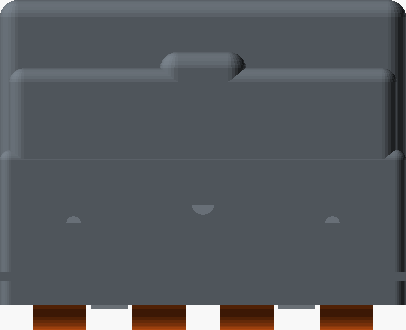
output/reinforced/views/wide-assembly-2.png
