JeremyProffittOrg/wopr/output/reinforced/views/wide-assembly-5.png

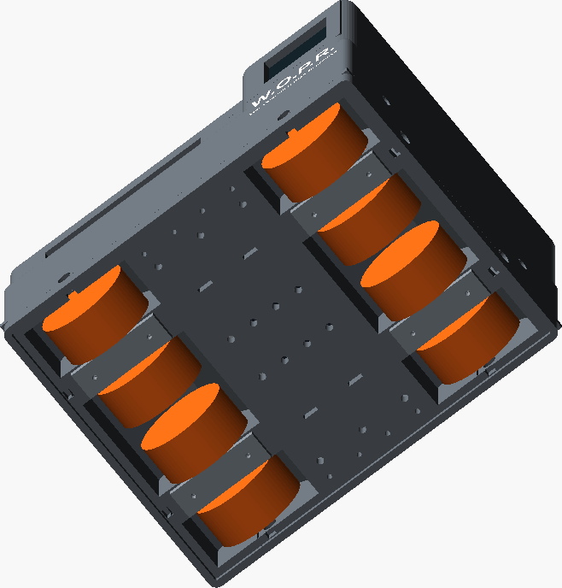
output/reinforced/views/wide-assembly-5.png
