JeremyProffittOrg/wopr/output/reinforced/views/wide-assembly-6.png

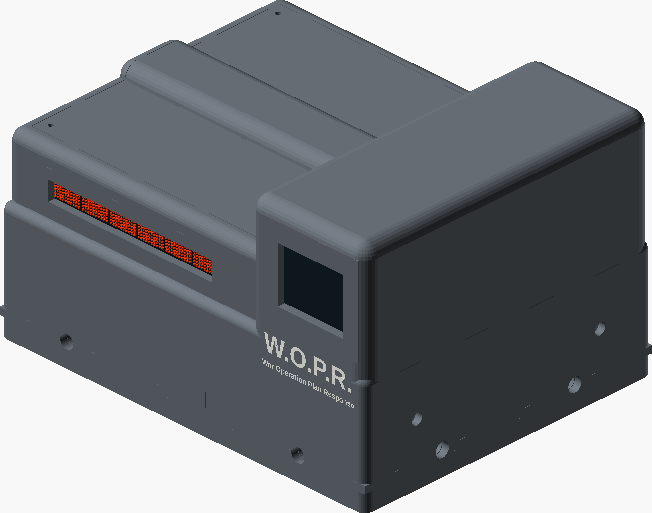
output/reinforced/views/wide-assembly-6.png
