JeremyProffittOrg/wopr/output/variants/views/replica-assembly-1.png

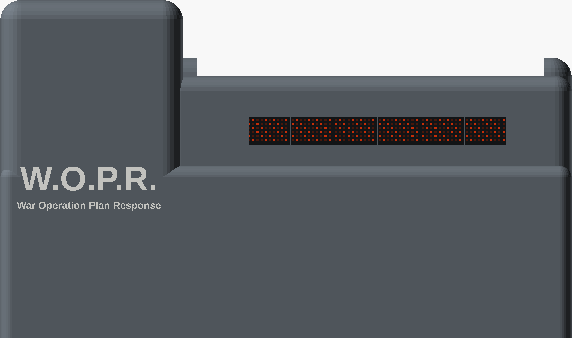
output/variants/views/replica-assembly-1.png
