JeremyProffittOrg/wopr/output/variants/views/robot-assembly-0.png

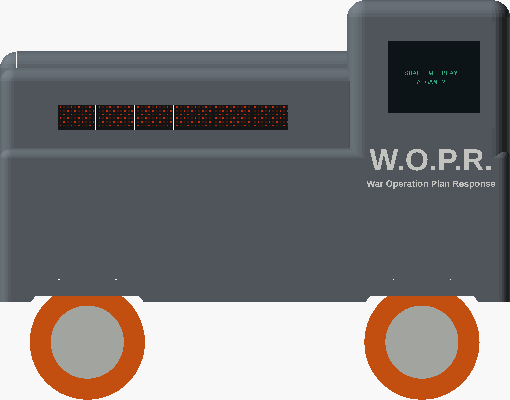
output/variants/views/robot-assembly-0.png
