JeremyProffittOrg/wopr/output/variants/views/robot-assembly-1.png

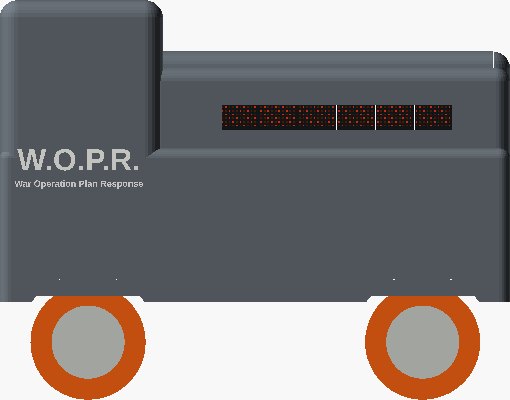
output/variants/views/robot-assembly-1.png
