JeremyProffittOrg/wopr/output/variants/views/robot-assembly-2.png

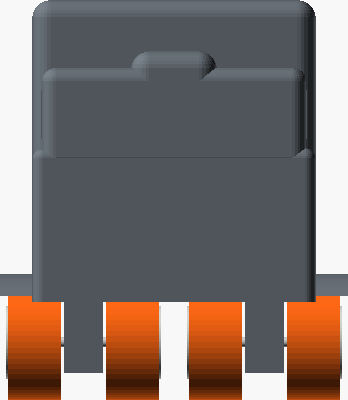
output/variants/views/robot-assembly-2.png
