JeremyProffittOrg/wopr/output/variants/views/robot-assembly-4.png

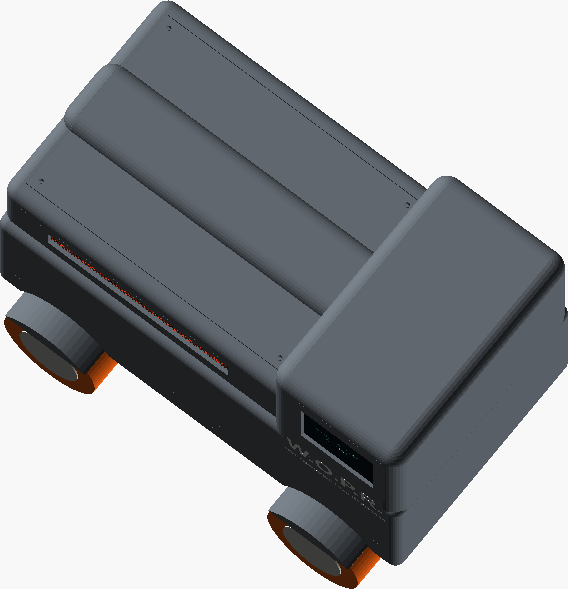
output/variants/views/robot-assembly-4.png
