JeremyProffittOrg/wopr/output/variants/views/robot-assembly-5.png

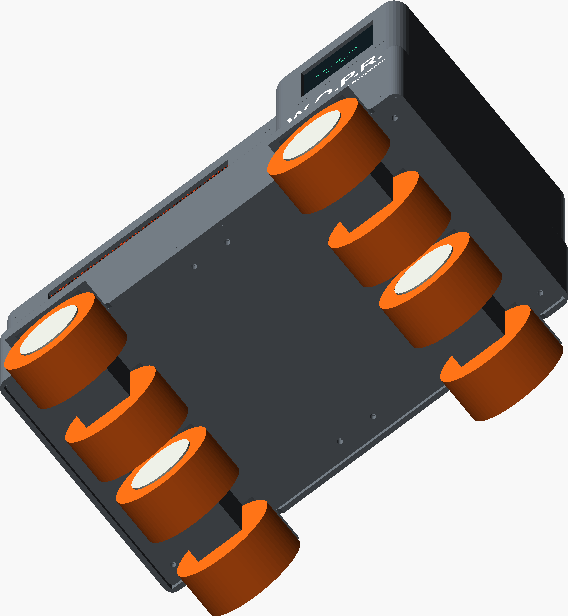
output/variants/views/robot-assembly-5.png
