JeremyProffittOrg/wopr/output/variants/views/robot-assembly-6.png

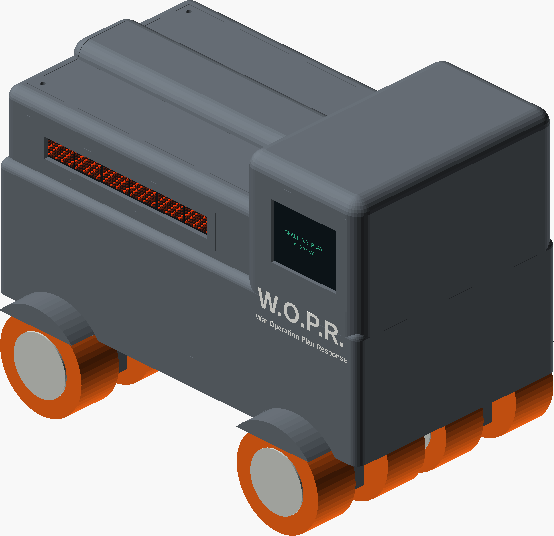
output/variants/views/robot-assembly-6.png
