JeremyProffittOrg/wopr/output/variants/views/robot-assembly-7.png

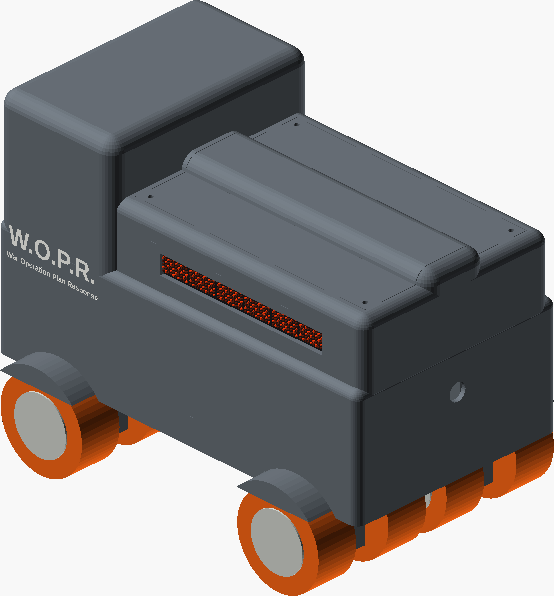
output/variants/views/robot-assembly-7.png
