JeremyProffittOrg/wopr/output/concealed/views/four-wheel-concealed-pod-test-0.png

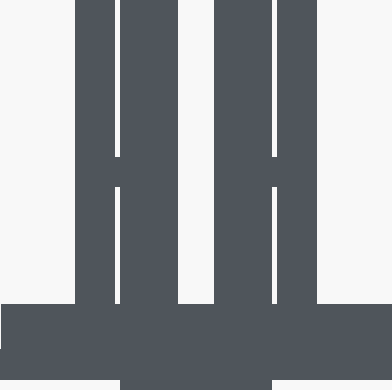
output/concealed/views/four-wheel-concealed-pod-test-0.png
