JeremyProffittOrg/wopr/output/concealed/views/four-wheel-concealed-pod-test-2.png

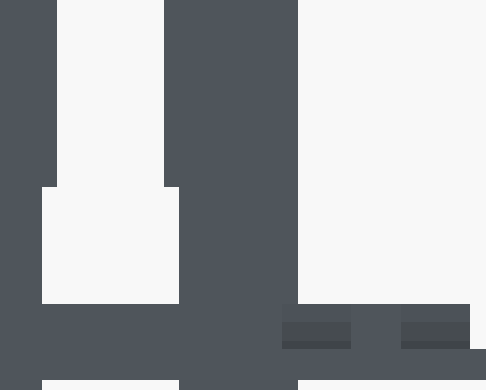
output/concealed/views/four-wheel-concealed-pod-test-2.png
