JeremyProffittOrg/wopr/output/concealed/views/four-wheel-concealed-pod-test-3.png

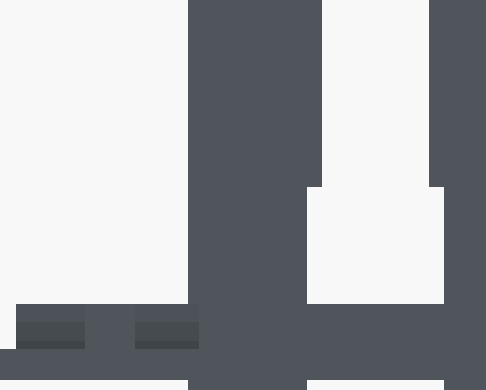
output/concealed/views/four-wheel-concealed-pod-test-3.png
