JeremyProffittOrg/wopr/output/concealed/views/four-wheel-concealed-pod-test-4.png

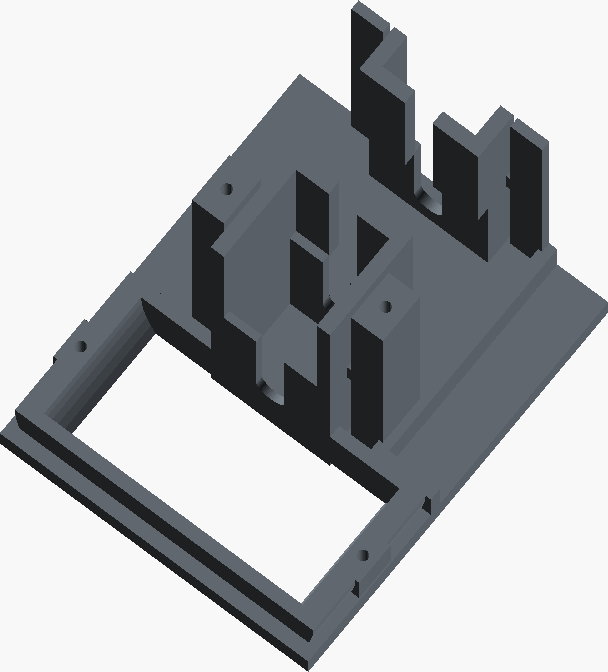
output/concealed/views/four-wheel-concealed-pod-test-4.png
