JeremyProffittOrg/wopr/output/concealed/views/four-wheel-concealed-pod-test-5.png

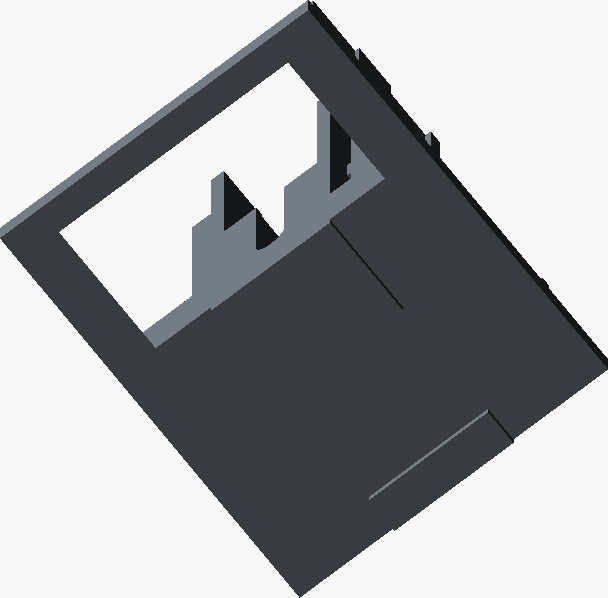
output/concealed/views/four-wheel-concealed-pod-test-5.png
