JeremyProffittOrg/wopr/output/concealed/views/four-wheel-concealed-pod-test-6.png

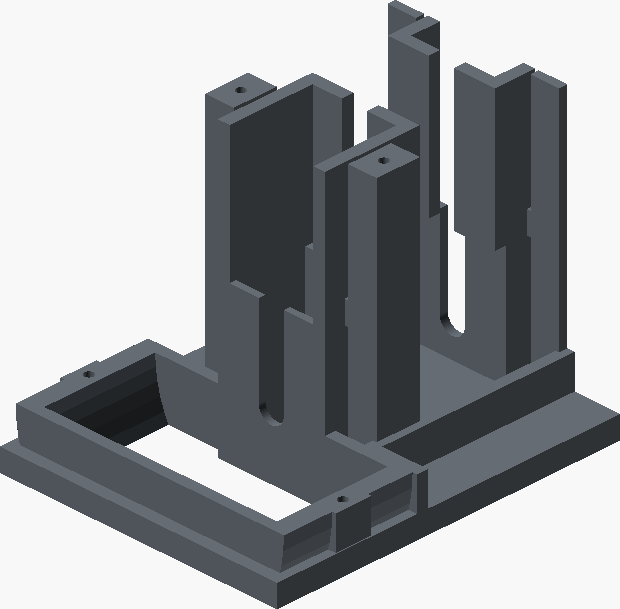
output/concealed/views/four-wheel-concealed-pod-test-6.png
