JeremyProffittOrg/wopr/output/concealed/views/four-wheel-concealed-pod-test-7.png

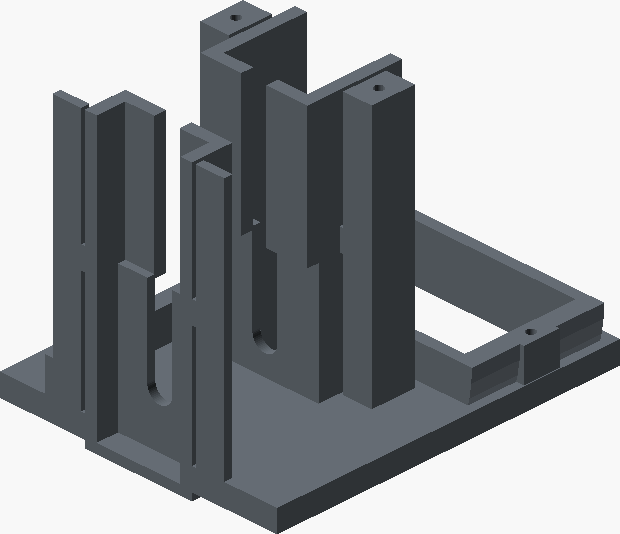
output/concealed/views/four-wheel-concealed-pod-test-7.png
