JeremyProffittOrg/wopr/output/concealed/views/wide-eight-wheel-concealed-pod-test-0.png

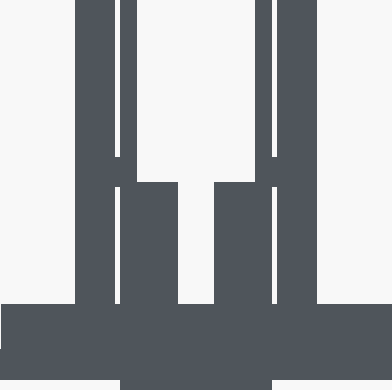
output/concealed/views/wide-eight-wheel-concealed-pod-test-0.png
