JeremyProffittOrg/wopr/output/concealed/views/wide-eight-wheel-concealed-pod-test-2.png

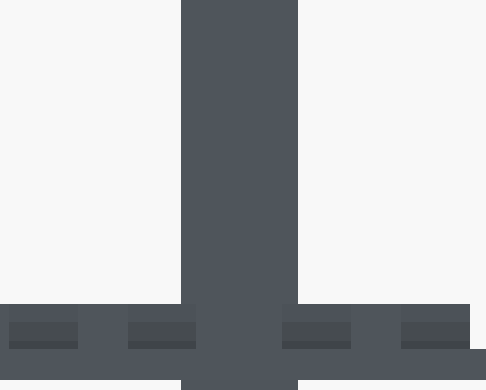
output/concealed/views/wide-eight-wheel-concealed-pod-test-2.png
