JeremyProffittOrg/wopr/output/concealed/views/wide-eight-wheel-concealed-pod-test-4.png

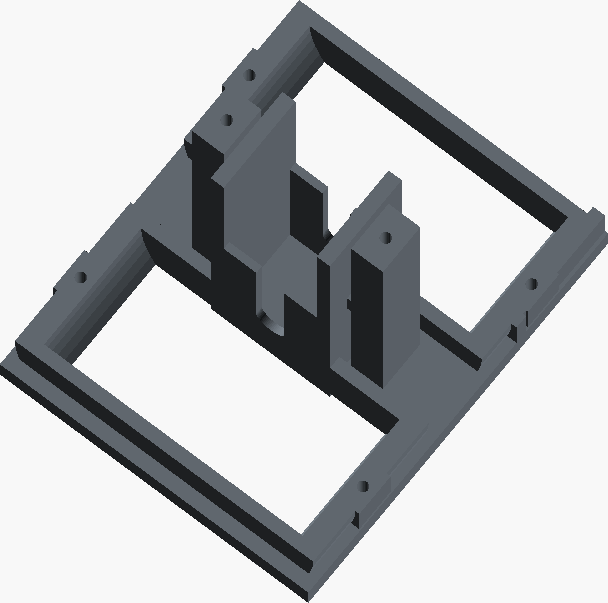
output/concealed/views/wide-eight-wheel-concealed-pod-test-4.png
