JeremyProffittOrg/wopr/output/concealed/views/wide-eight-wheel-concealed-pod-test-5.png

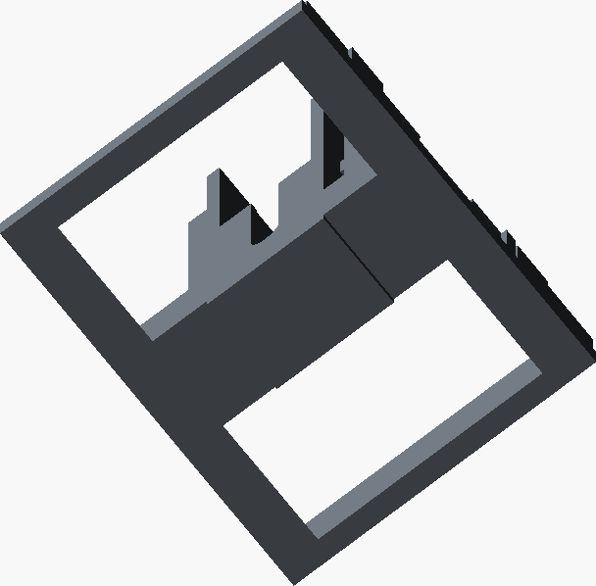
output/concealed/views/wide-eight-wheel-concealed-pod-test-5.png
