JeremyProffittOrg/wopr/output/concealed/views/wide-eight-wheel-concealed-pod-test-6.png

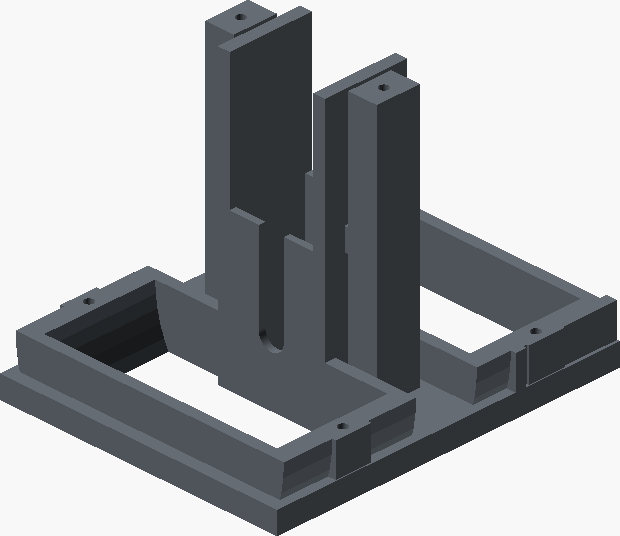
output/concealed/views/wide-eight-wheel-concealed-pod-test-6.png
