JeremyProffittOrg/wopr/output/variants/views/robot-robot-pod-test-0.png

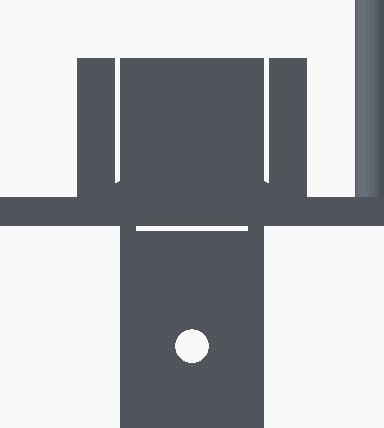
output/variants/views/robot-robot-pod-test-0.png
