JeremyProffittOrg/wopr/output/variants/views/robot-robot-pod-test-1.png

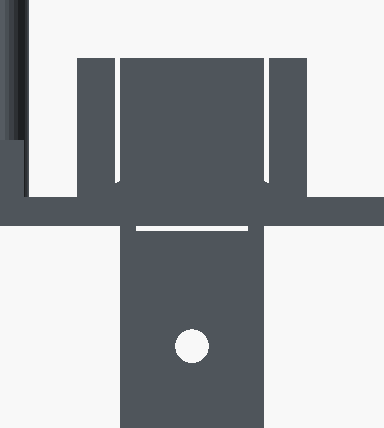
output/variants/views/robot-robot-pod-test-1.png
