JeremyProffittOrg/wopr/output/variants/views/robot-robot-pod-test-2.png

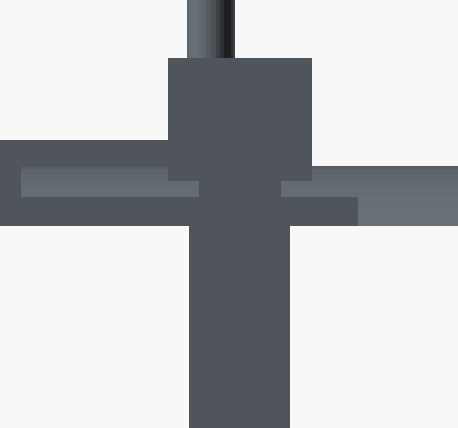
output/variants/views/robot-robot-pod-test-2.png
