JeremyProffittOrg/wopr/output/variants/views/robot-robot-pod-test-4.png

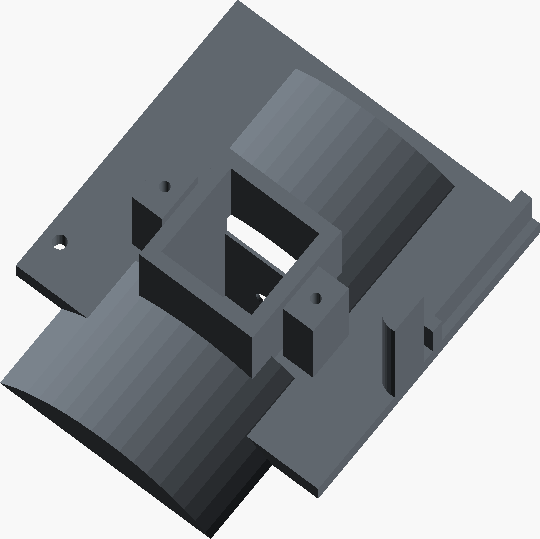
output/variants/views/robot-robot-pod-test-4.png
