JeremyProffittOrg/wopr/output/variants/views/robot-robot-pod-test-5.png

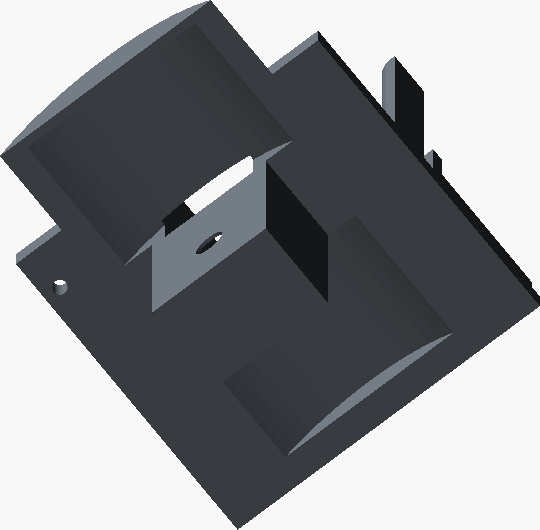
output/variants/views/robot-robot-pod-test-5.png
