JeremyProffittOrg/wopr/output/variants/views/robot-robot-pod-test-6.png

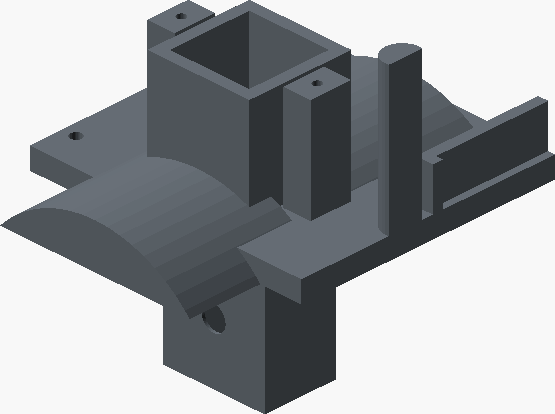
output/variants/views/robot-robot-pod-test-6.png
