JeremyProffittOrg/wopr/output/variants/views/robot-robot-pod-test-7.png

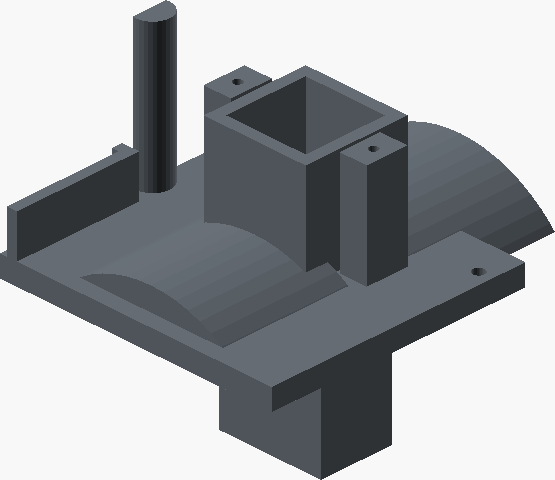
output/variants/views/robot-robot-pod-test-7.png
