JeremyProffittOrg/wopr/output/wording-test/preview.png

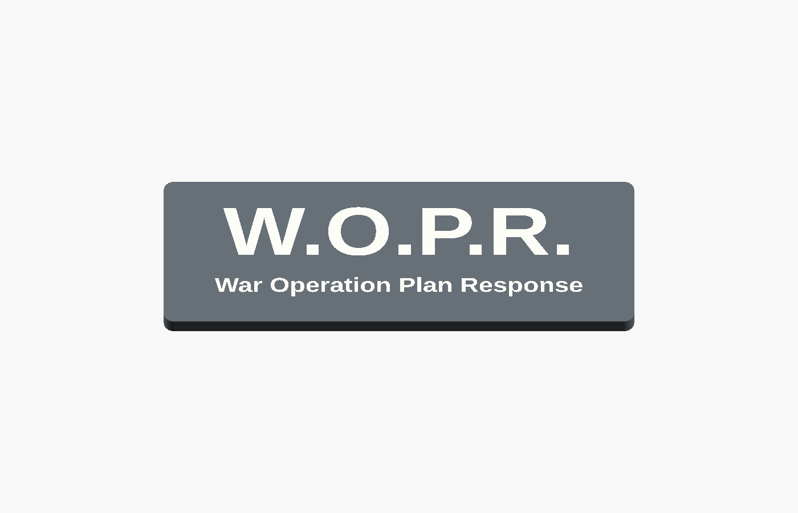
output/wording-test/preview.png
