JeremyProffittOrg/wopr/(commit log)

2026-09-26 Add eight-board WOPR printable draft and illustrated PDF
    [base-left.stl, base-right.stl, fit-coupon.stl, gray-left.stl, gray-right.stl, right-shell-two-color.3mf, splice.stl, white-right.stl]
2026-09-26 Revise WOPR with adjacent rear-mounted LEDs and open pen cups
    [cup-left.stl, cup-right.stl, cup-tower.stl, fit-coupon.stl, gray-left.stl, gray-right.stl, led-retainer.stl, right-shell-two-color.3mf]
2026-09-26 Combine WOPR parts and deliver seven-panel print kit
    [base-left.stl, base-right.stl, base.stl, cup-left.stl, cup-main.stl, cup-right.stl, gray-left.stl, gray-right.stl]
2026-09-26 Fix Bambu GUI import by delivering one geometry project
    [shell-two-color.3mf, wopr-parts.3mf]
2026-09-26 Record import fix delivery and show LCD rear mounting holes
2026-09-26 Recess WOPR base and add both divided-cup layouts
    [base.stl, cup-main-shallow-left.stl, cup-main-shallow-right.stl, cup-main.stl, cup-tower.stl, fit-coupon.stl, gray-shell.stl, shell-two-color.3mf]
2026-09-27 Trim LCD front aperture to measured edge offsets
    [fit-coupon.stl, gray-shell.stl, shell-two-color.3mf, wopr-parts.3mf, wopr.scad]
2026-09-27 Add slice-verified two-filament WOPR wording test
    [wopr-two-filament-test.3mf, wopr.scad, wording-gray.stl, wording-white.stl]
2026-09-27 Add single-filament and multi-color body 3MF projects
    [wopr-body-multi-color.3mf, wopr-body-single-filament.3mf]
2026-09-28 Add six-panel WOPR replica and eight-wheel captive-portal robot kit
    [base.stl, cup-main-shallow-left.stl, cup-main-shallow-right.stl, cup-tower.stl, fit-coupon.stl, gray-shell.stl, led-retainer.stl, robot-cap.stl]
2026-09-28 Add recessed four-wheel and wide eight-wheel WOPR variants
    [concealed-floor.stl, concealed-pod-test.stl, concealed-shell.stl, concealed-tray.stl, fit-coupon.stl, led-retainer.stl, robot-cap.stl, robot-lid.stl]
2026-09-28 Record concealed-wheel WOPR delivery and verification
2026-09-29 Reinforce every WOPR edition with 5mm walls and 10mm bases
    [r-cap.stl, r-cup-left.stl, r-cup-right.stl, r-cup-tower.stl, r-frame.stl, r-hood-front.stl, r-hood-rear.stl, r-lcd-coupon.stl]
2026-09-29 Integrate motor mounts and wheel wells into chassis with zip-tie option
    [r-frame-zip.stl, r-frame.stl, r-hood-front.stl, r-hood-rear.stl, r-pod.stl, r-shell.stl, shell-two-color.3mf, wopr-exposed-one-piece-cap.3mf]
2026-09-29 Record one-piece chassis verification and email delivery
2026-09-29 Route motor zip ties around motor through reinforced side supports
    [r-frame-zip.stl, wopr-exposed-one-piece-zip.3mf, wopr-reinforced-exposed.scad, wopr-reinforced-four.scad, wopr-reinforced-seven.scad, wopr-reinforced-six.scad, wopr-reinforced-wide.scad, wopr-reinforced.scad]
2026-09-29 Add continuous skirts, tie-down mounts, sensor ports and LED provisions
    [r-frame-zip.stl, r-frame.stl, r-lcd-coupon.stl, r-lid.stl, r-shell.stl, r-tray.stl, r-white.stl, shell-two-color.3mf]
2026-09-29 Record sensor and lighting kit verification and delivery
2026-09-29 Clear unused four-wheel shaft tips and check motor-pair spacing
    [r-frame-zip.stl, r-frame.stl, r-lcd-coupon.stl, r-lid.stl, r-shell.stl, r-white.stl, shell-two-color.3mf, wopr-reinforced-exposed.scad]
2026-09-29 Keep central battery straps clear of the bottom LED grid
    [r-frame-zip.stl, r-frame.stl, wopr-exposed-one-piece-cap.3mf, wopr-exposed-one-piece-zip.3mf, wopr-reinforced-exposed.scad, wopr-reinforced-four.scad, wopr-reinforced-seven.scad, wopr-reinforced-six.scad]
2026-09-29 Make battery platforms solid and narrower with outer-wheel lighting
    [r-frame-zip.stl, r-frame.stl, wopr-exposed-one-piece-cap.3mf, wopr-exposed-one-piece-zip.3mf, wopr-reinforced-exposed.scad, wopr-reinforced-four.scad, wopr-reinforced-seven.scad, wopr-reinforced-six.scad]
2026-09-29 Record solid battery block verification and delivery
2026-10-02 bottom-load-clearance: add bottom insertion and concealed-chassis-sensors
    [r-cap.stl, r-cup-left.stl, r-cup-right.stl, r-frame-zip.stl, r-frame.stl, r-lcd-coupon.stl, r-shell.stl, shell-two-color.3mf]
2026-10-02 concealed-chassis-sensors: record verified delivery
